ASamarkRoth/ScanningSystem/Report/Theory/Theory.tex

\documentclass[11pt,a4paper]{article}
\usepackage[utf8]{inputenc}
\usepackage[english]{babel}
\usepackage[T1]{fontenc}
\usepackage{amsmath}
\usepackage{amsfonts}
\usepackage{amssymb}
\usepackage{graphicx}
\usepackage{array}
\usepackage{multirow}
\usepackage[left=2cm,right=2cm,top=2cm,bottom=2cm]{geometry}
\author{Guillem Tocabens}
\title{First measurements}
\begin{document}
\section{Physical background}

\end{document}
