ASamarkRoth/ScanningSystem/figs_and_draws/3DPrinter.md

#Purchasing 3D printer#

_LTH contact_: <http://www.design.lth.se/english/the-department/research-laboratories/3dprintlab/facilities/>

* Olaf Diegel <olaf.diegel@mkon.lth.se>

_Nicholai_:
3D skrivaren som använder ett resin är från ett företag som heter /Formlabs/, och deras senaste modell heter /Form 2/.
*Form* *2 product page*: https://formlabs.com/3d-printers/form-2/?utm_content=landing
*Promo video*: https://www.youtube.com/watch?time_continue=1&v=Ak4kgiSvgN8
*Reviews*: https://www.youtube.com/watch?time_continue=1&v=Ak4kgiSvgN8
*Reviews*: https://www.youtube.com/watch?v=HkILCsAOMcQ

-----------------------

För extruder printers kan jag rekommendera att du kolla på företag såsom:
/- /*Makerbot* - (största på markaden, men dyra och inte alltid bäst) - https://www.makerbot.com/products/3d-printers/
- *Ultimaker* - (bra upplösning, skriver inte alltid lika snabbt) - https://ultimaker.com/en/products
- *Lulzbot* - https://www.lulzbot.com/store/printers
- *Raise3D* - https://www.raise3d.com/pages/products

Jag har inte personligen erfarenhet av dessa skrivarna, annat än Form 2 resin skrivaren, så kolla gärna upp reviews på youtube eller likanade på dom andra. Kanalen "Tested" kollar mycket på 3D skrivare tex. All priser är mellan 20 000-35 000 SEK.

---------------------

För metall 3D prining finns bla:
- *Markforged* - https://markforged.com/products/
- *PLM Group* - https://plmgroup.se/produkter/3d-printers/production-3d-printers/direct-metal/

Räkna med att de kostar rätt bra mycket mer =)

##Interesting##

* Metal: <https://plmgroup.se/produkter/3d-printers/production-3d-printers/direct-metal/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>

##Compilation##
There are mainly two types of plastic 3D-printers denoted; resin (SLA) and extruder (FDM). <http://apm-designs.com/fdm-vs-sla-3d-printer-tech-comparison> makes a good introduction and comparison. 

From a chat with Nicholai and some internet search we have gathered two main candidates: 

* [Ultimaker 3](https://ultimaker.com/en/products/ultimaker-3). This is of extruder type. 
* [Form 2](https://formlabs.com/3d-printers/form-2/?utm_content=landing). This is a resin type.

_Accuracy_: Both have accuracy ~0.1 mm (Form 2 perhaps a little better). Form 2 is better on making difficult shapes.
_Dimensions_: 

* Form 2: 145 × 145 × 175 mm 
* Ultimaker 3: 215 x 215 x 200 mm

_Materials_: Both offer many different materials. 

* Form 2: <https://formlabs.com/materials/>
* Ultimaker 3: <https://ultimaker.com/en/products/materials>

Perhaps the ultimaker material is better suitable? 

For the Form 2 one can buy the liquid plastic ~1500-2000 kr per litre. While the plastic for the Ultimaker comes on rolls and are cheaper (~500 kr/750 g).

_Service/maintenance_: The Form 2 needs some more cleaning in between prints. The piece printed with the Form 2 might also need some extra treatment (removal of supporting structure) before it is ready. The companies offer fast service and spare parts.

Somebody needs to maintain the printer from time to time to keep it functional. How can this be arranged in the division?

_Software_: Never a problem.

_Installation_: The printer is not loud but it makes some noise. The microbeam hall is probably the best choice of location. How do we initiate these discussions?

What is perhaps most unclear is how we should organise the installation and maintenance of the printer in the division? Pavel told me that Kevin showed an interest to take part in the payment. 

Note that the information above are my (and Pavels) interpretations.
