ASamarkRoth/ScanningSystem/figs_and_draws/AbsorberDist-V1.0.pdf

Material: Aluminum, stainless steel, ...

10:1

Distance pieces for Absorber V1.0 20x H=2.0 mm
20x H=1.5 mm
20x H=1.0 mm

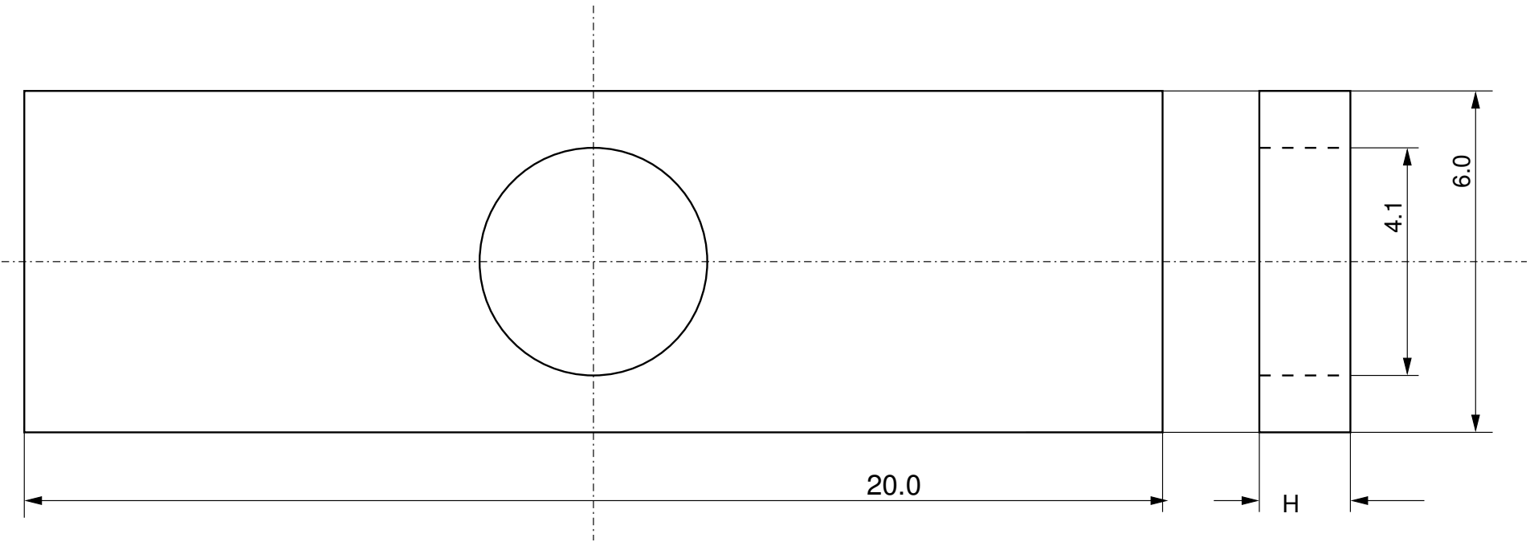
[picture p4: figure]
