ASamarkRoth/ScanningSystem/figs_and_draws/SourceHolder-V1.0.pdf

1:1

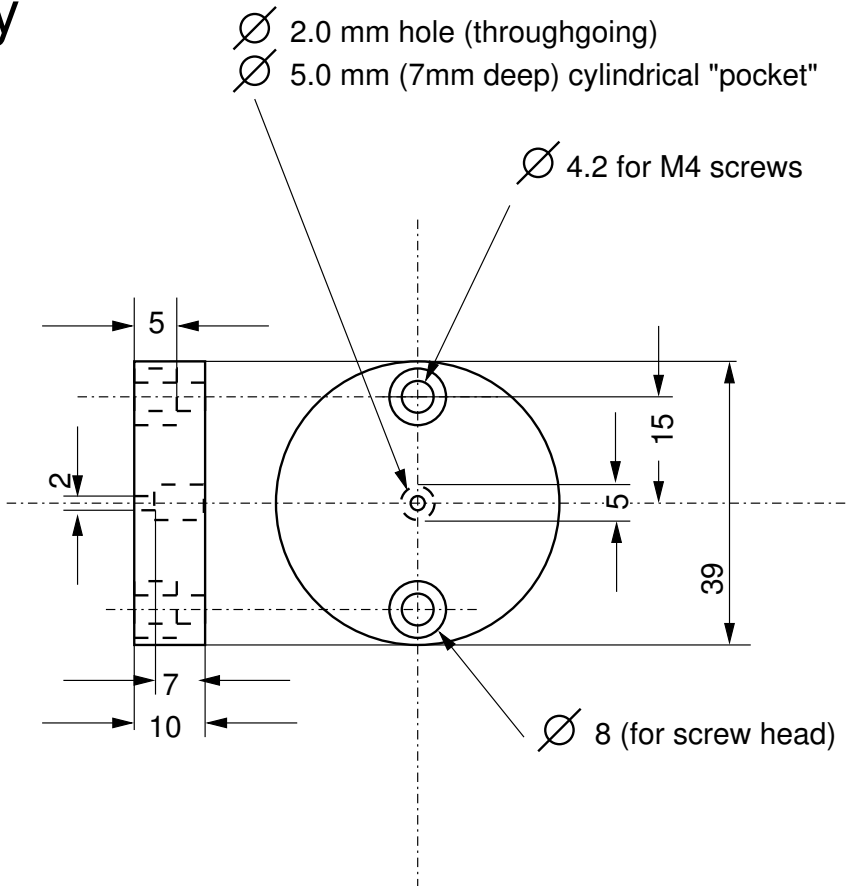
[picture p5: figure]
4.2 for M4 screws; 8 (for screw head); 2.0 mm hole (throughgoing) 5.0 mm (7mm deep) cylindrical "pocket"

# Material: Tungsten alloy

1x

# Source Holder for Collimator V1.0
