ASamarkRoth/ScanningSystem/figs_and_draws/Positioning system/HIWIN Servomotorer.pdf

# Servomotorer

### Sätt dina tankar i rörelse

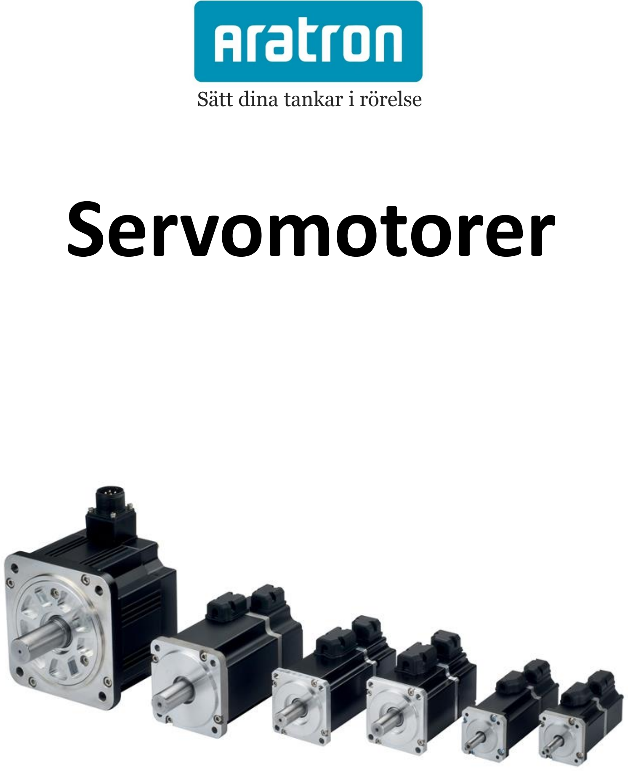
[picture p6: page 1]

# Servomotorer

## HIWIN AC servomotorer från 50W > 2kW

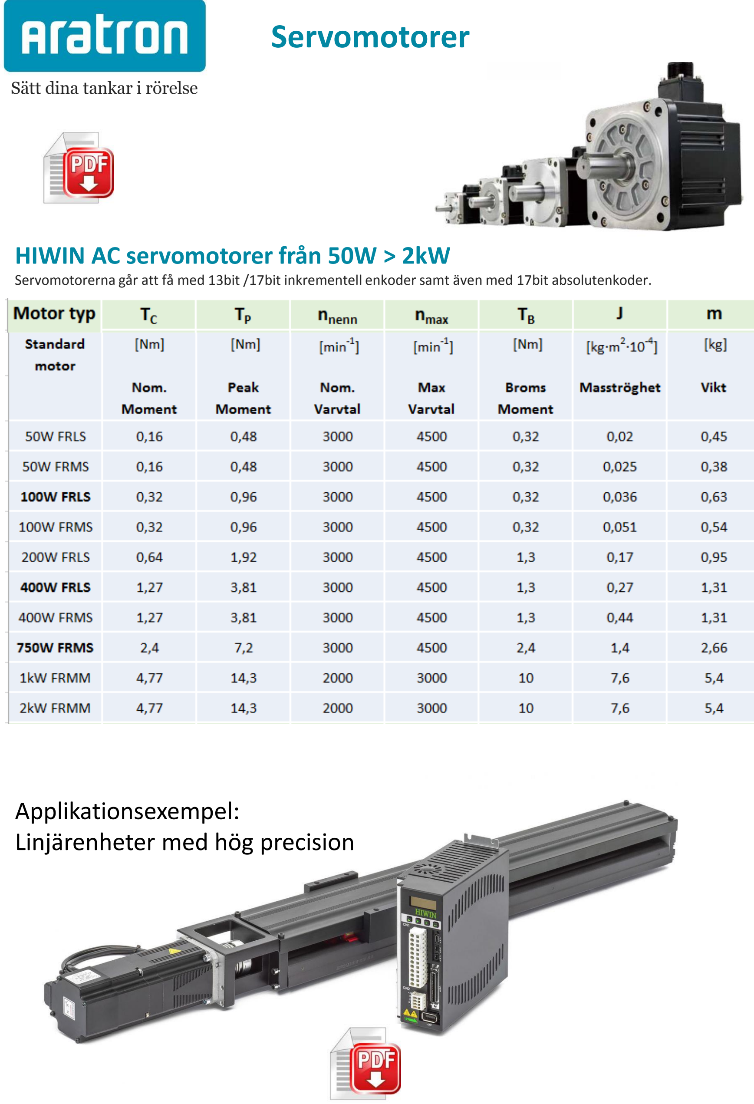
[picture p7: page 2]

Servomotorerna går att få med 13bit /17bit inkrementell enkoder samt även med 17bit absolutenkoder.

Sätt dina tankar i rörelse

## Applikationsexempel: Linjärenheter med hög precision

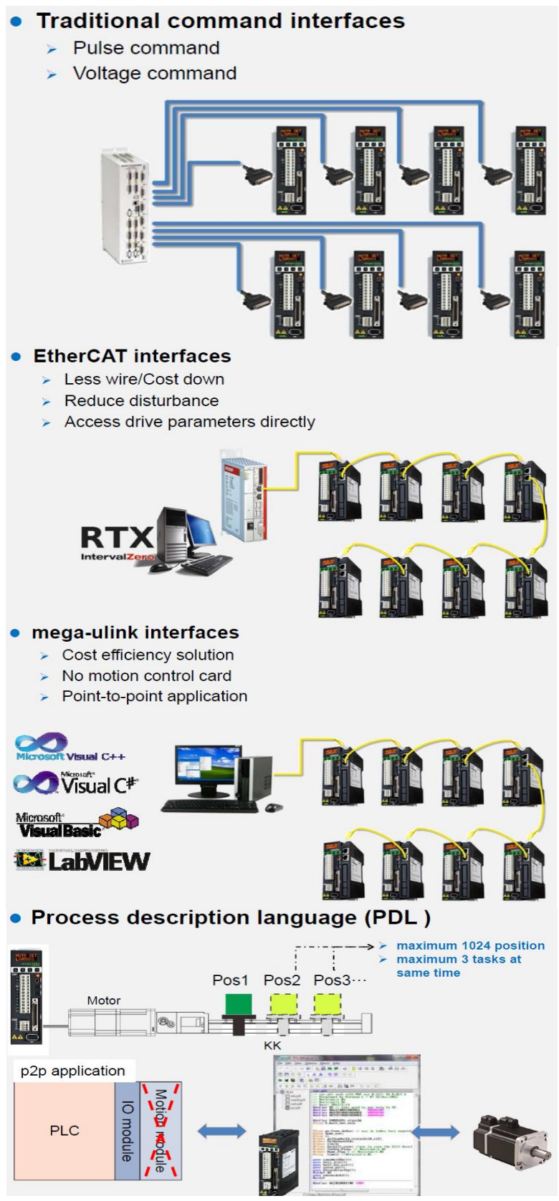
[picture p8: figure]
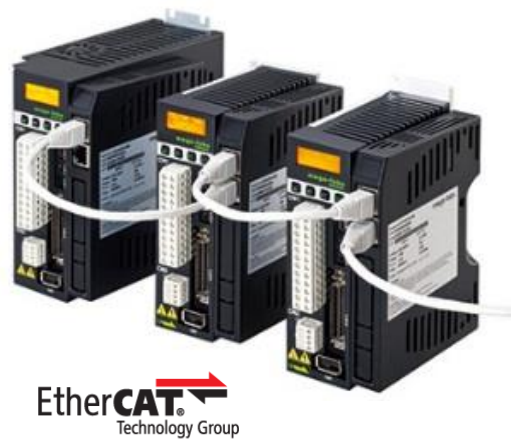
[picture p9: figure]

## Exempel på några egenskaper & funktioner

## HIWIN D2 Servodrivers

Intelligent programmerbar Standard Driver har en stor flexibiliteten. D2 har färdiga program för referenskörningar samt en gratis mjukvara ”lightening” som förenklar parameterinställning. D2 är lämplig för positionering, hastighetskontroll samt enklare I/O kontroll. Optioner: Modbus (RTU och ASCII) för seriell kommunikation mot bl.a. HMI display för att visa värden. EtherCAT interface (CoE) för avancerad CNC kontroll eller (megaulink) som erbjuder bra gränssnitt med API som passar mot andra mjukvaror och programspråk. Med en PDL koder kan HIWIN servodriver enkelt programmeras och styra positioner och hastigheter mm. D2 Driver fungerar såväl ”Standalone” som en enkel PLC eller som slav till en extern PLC eller PC styrsystem beroende på vad som passar bäst.

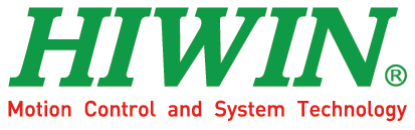
[picture p10: figure]

# Servodriver

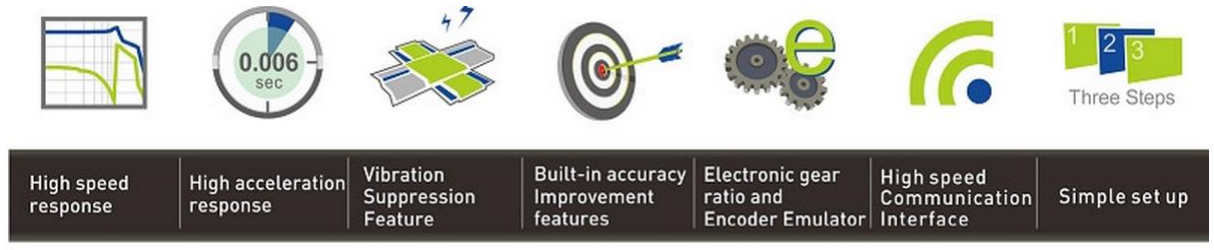
[picture p11: figure]

## Servomotorer & Direktdrivna momentmotorer

### Sätt dina tankar i rörelse

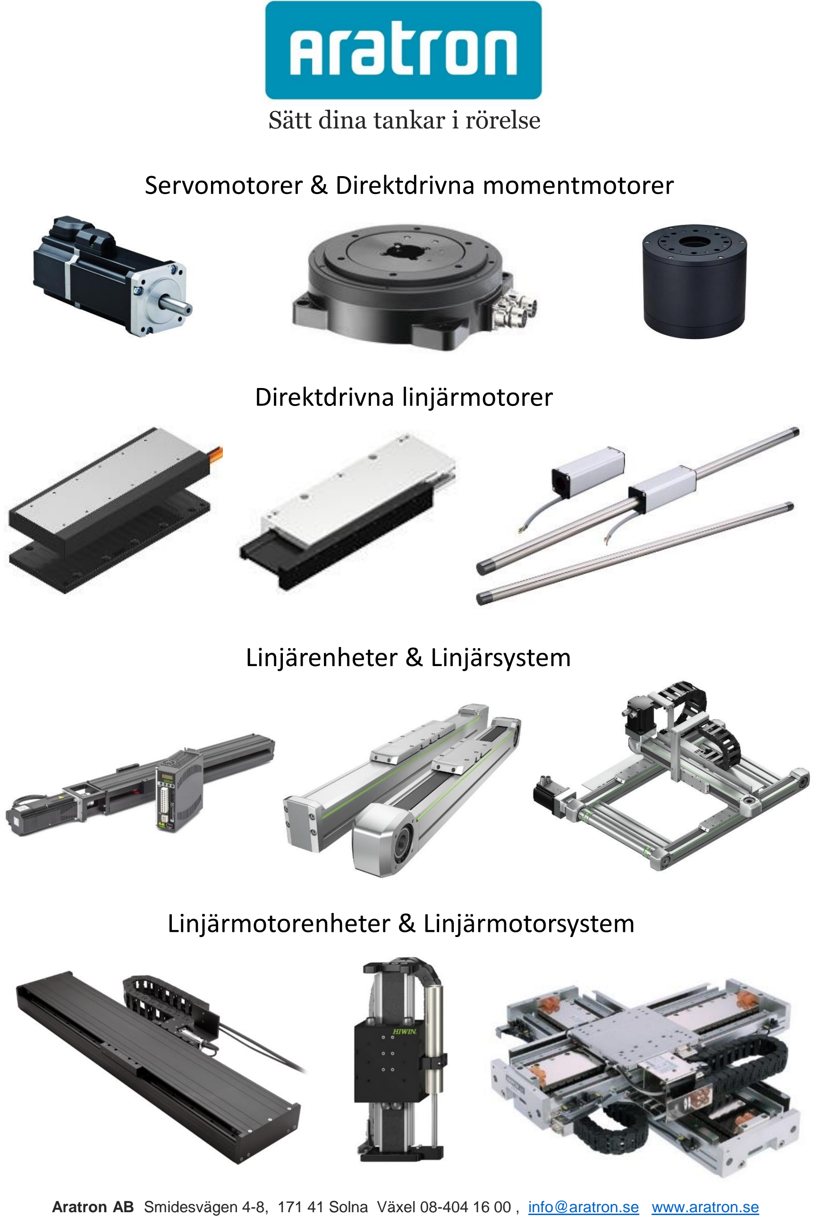
[picture p12: page 4]

Aratron AB Smidesvägen 4-8, 171 41 Solna Växel 08-404 16 00 , info@aratron.se www.aratron.se

## Direktdrivna linjärmotorer

## Linjärenheter & Linjärsystem

## Linjärmotorenheter & Linjärmotorsystem
