ASamarkRoth/ScanningSystem/figs_and_draws/Positioning system/Kort information om HIWIN Servodrifter med nåra prisexempel.pdf

Sätt dina tankar i rörelse

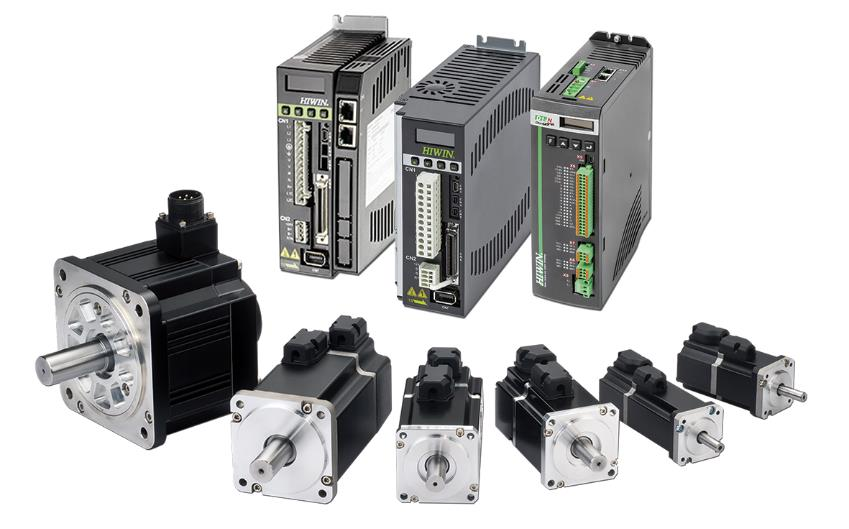
[picture p13: figure]

Aratron AB Smidesvägen 4-8, 171 41 Solna Växel 08-404 16 00 , info@aratron.se www.aratron.se

# HIWIN´s stora framgång beror på förmågan att alltid leverera högsta kvalitet till de mest konkurrenskraftiga priserna

# AC Servomotorer & Servodrives

## HIWIN erbjuder ett stort produktutbud för linjära rörelser & transmissioner

Med nyckelkomponenter såsom kulskruvar, linjära skenstyrningar, kryssrullager, linjärmotorer, momentmotorer, linjära mätskalor, AC servo och stegmotorer och elektriska gripdon mm. För några av dessa nyckelkomponenter t.ex. kulskruvar och linjära skenstyrningar rankas HIWIN som en av de största tillverkarna i världen. Genom kombinationer av dessa komponenter kan våra försäljningsingenjörer ge ert företag den bästa linjära systemlösningen.

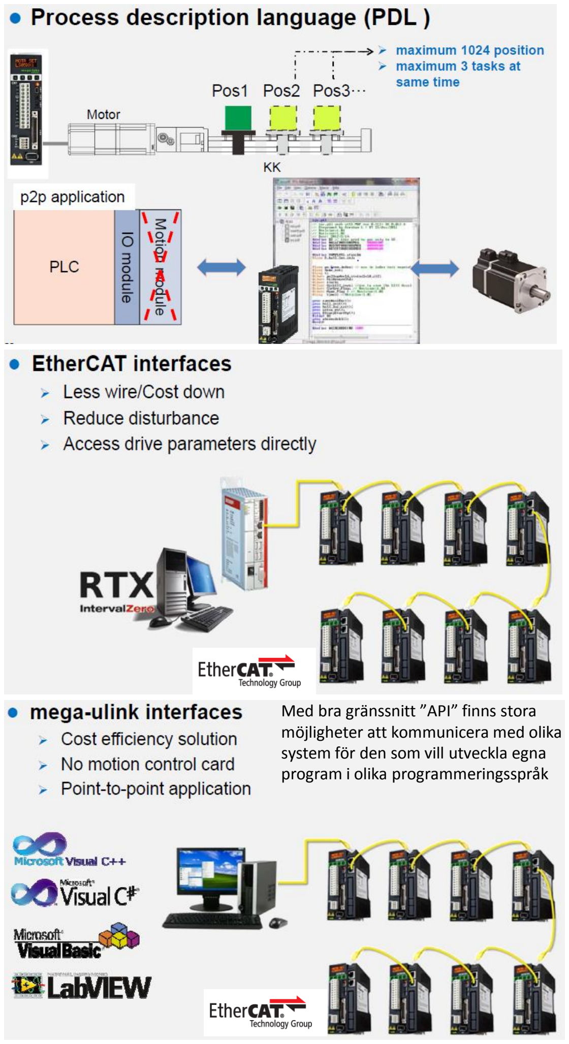
[picture p14: figure]
Med bra gränssnitt ”API” finns stora möjligheter att kommunicera med olika system för den som vill utveckla egna program i olika programmeringsspråk

### D2 Servodrivers erbjuder många möjligheter

Intelligent programmerbar Standard Driver med HIWIN´s PDL kod ökar flexibiliteten. D2 har färdiga program för referenskörningar samt en gratis mjukvara ”lightening” som förenklar parameterinställning. D2 är lämplig för positionering, hastighetskontroll samt enklare I/O kontroll. Optioner: Modbus (RTU och ASCII) för seriell kommunikation mot bl.a. HMI display för att visa värden. EtherCAT interface (CoE) för avancerad CNC kontroll eller (mega-ulink) som erbjuder bra gränssnitt med API som passar mot andra mjukvaror och programspråk.

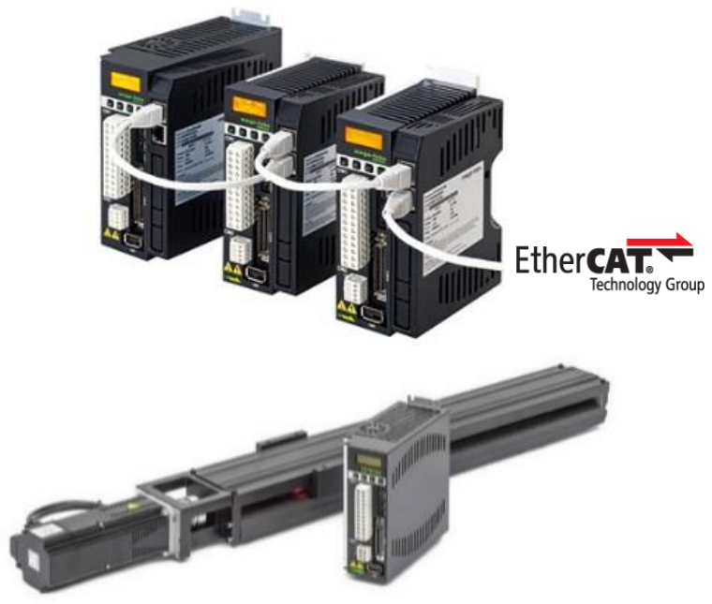
[picture p15: figure]
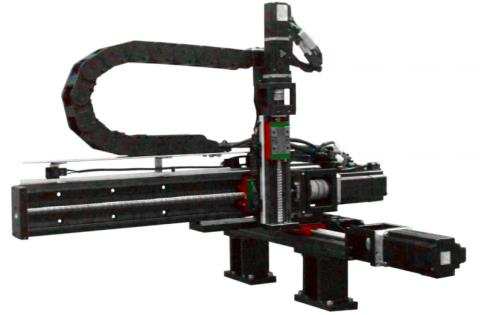
[picture p16: figure]
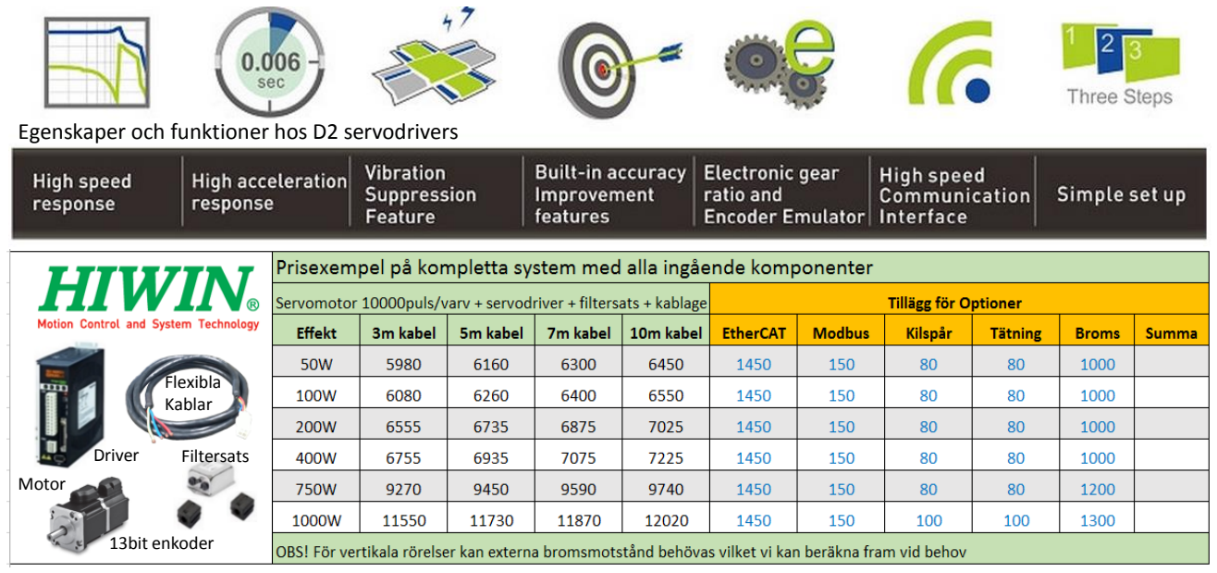
[picture p17: figure]
13bit enkoder; Driver; Flexibla Kablar; Filtersats; Motor

Aratron AB Smidesvägen 4-8, 171 41 Solna Växel 08-404 16 00 , info@aratron.se www.aratron.se

Fråga oss gärna på systemlösningar med servomotordrifter och linjärenheter

## Kortfattad beskrivning

Egenskaper och funktioner hos D2 servodrivers
