ASamarkRoth/ScanningSystem/figs_and_draws/Ritningar LYCCA-mount scanner/AddPieces-V1.0.pdf

## Distance cylinder & preamp support

Material: Hard plastic / plexiglas | 1:1 | Material: Aluminum | 1:1

16

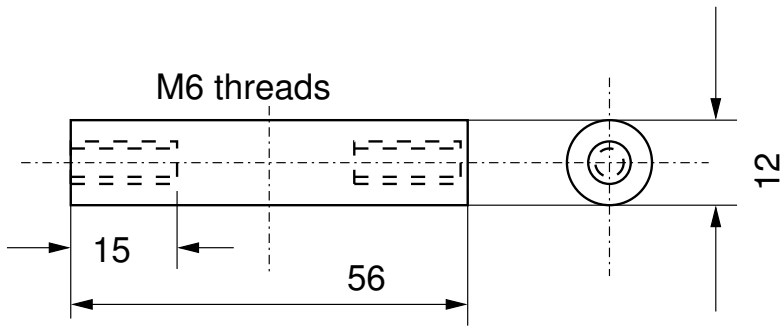
[picture p27: figure]
M6 threads

60

4 x | 12 x
