ASamarkRoth/ScanningSystem/figs_and_draws/BX 170308 SPECIAL BORD -ANTON ROTH.PDF

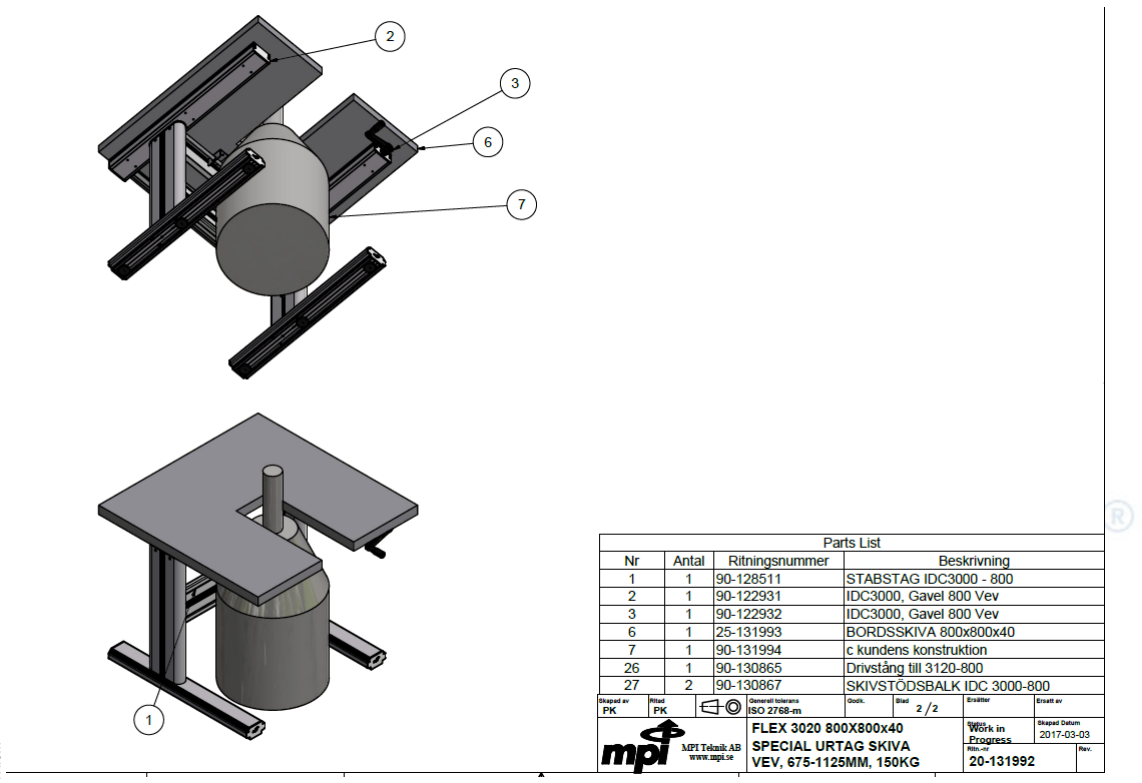
[picture p28: figure]

Kund: | Projektnamn | Datum: 2017-03-08
| | Er ref.: Anton Roth
| Offertnummer | Vår ref.: Besnik Xhemajli
BX 170308 SPECIAL BORD -ANTON ROTH

Gigant Arbetsplats AB/Configura - BX 170308 SPECIAL BORD -ANTON ROTH.om

OFFERT

2017-03-08 | Sida 1 (2)

Anton Roth

Offertnummer BX 170308 SPECIAL BORD -ANTON ROTH
Hej!
Här kommer en offert enligt dina ösnkemål.

Materialet i 40 skivan är trälamell/spån och det är inga problem att borra i den. Vad gäller broms så ska varje benpar klara 150 kg utan att det ska bli någon rörelse i bordet, men vid överlastning kan bordet börja sjunka. Borra hål och fästa i golv borde vara möjligt men ansvaret för det faller på kunden. Varje ben har 3st ställfötter som är inställbara i höjdled.

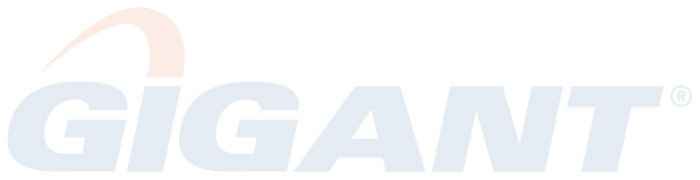
[picture p29: figure]

Välkommen att kontakta mig vid frågor!

Med vänlig hälsning

Gigant Arbetsplats AB
Innesälj

Besnik Xhemajli
Tel. direkt | 010-4546316
Mobil | 070-219 40 57
E-post | besnik.xhemajli@gigant.se
Gigant Arbetsplats AB | Telefon | Fax | Bankgiro | Postgiro | Vat reg nr | E-post
Sandbergsvägen 3 | 010-4546316 | | | | | besnik.xhemajli@gigant.se
| | | | Org nr | Internet

Sida 2 (2)

Offertspecifikation

Best.nr. | Benämning | Antal | a' pris | Totalpris
(20-131992 ) | SPECIAL BORD 100:311 | 1.00 13 019:93 | 13 019:93
Leveransvillkor | Enligt Gigants allmäna försäljnings-och leveransvillkor
Betalningsvillkor | Enligt Gigants allmäna försäljnings-och leveransvillkor
SUMMA TOTALT (exkl. moms) | SEK 13 020:-
Kund: | Projektnamn | Datum: 2017-03-08
| | Er ref.: Anton Roth
| Offertnummer | Vår ref.: Besnik Xhemajli
BX 170308 SPECIAL BORD -ANTON ROTH
