ASamarkRoth/ScanningSystem/figs_and_draws/SFi-Sor-Off17012410080.pdf

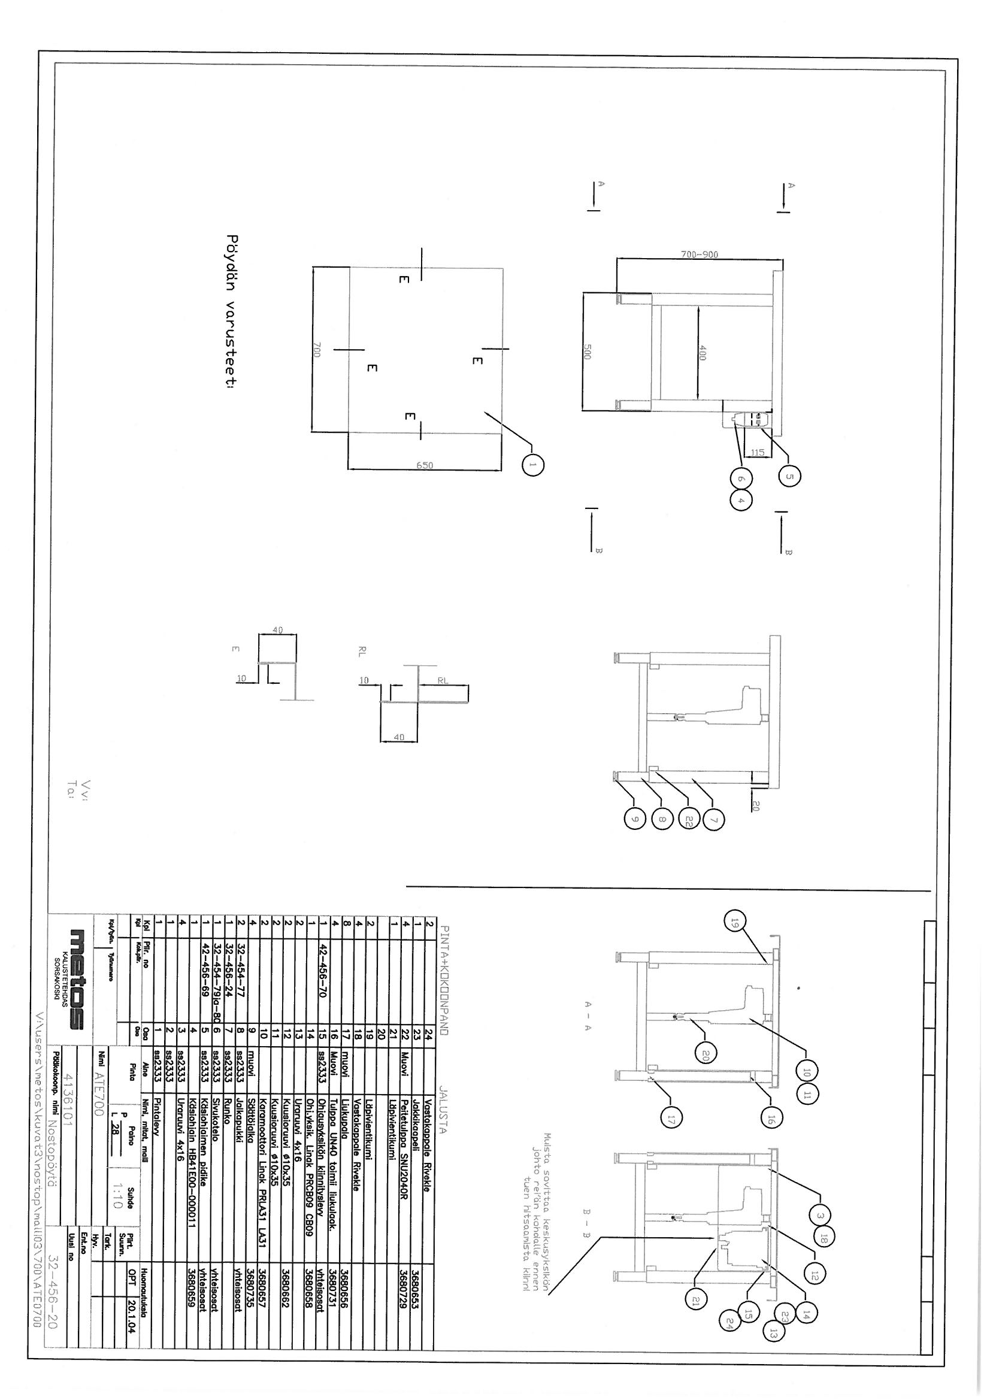
[picture p30: page 1]
