ASamarkRoth/ScanningSystem/figs_and_draws/Positioning system/principskissSKS.pdf

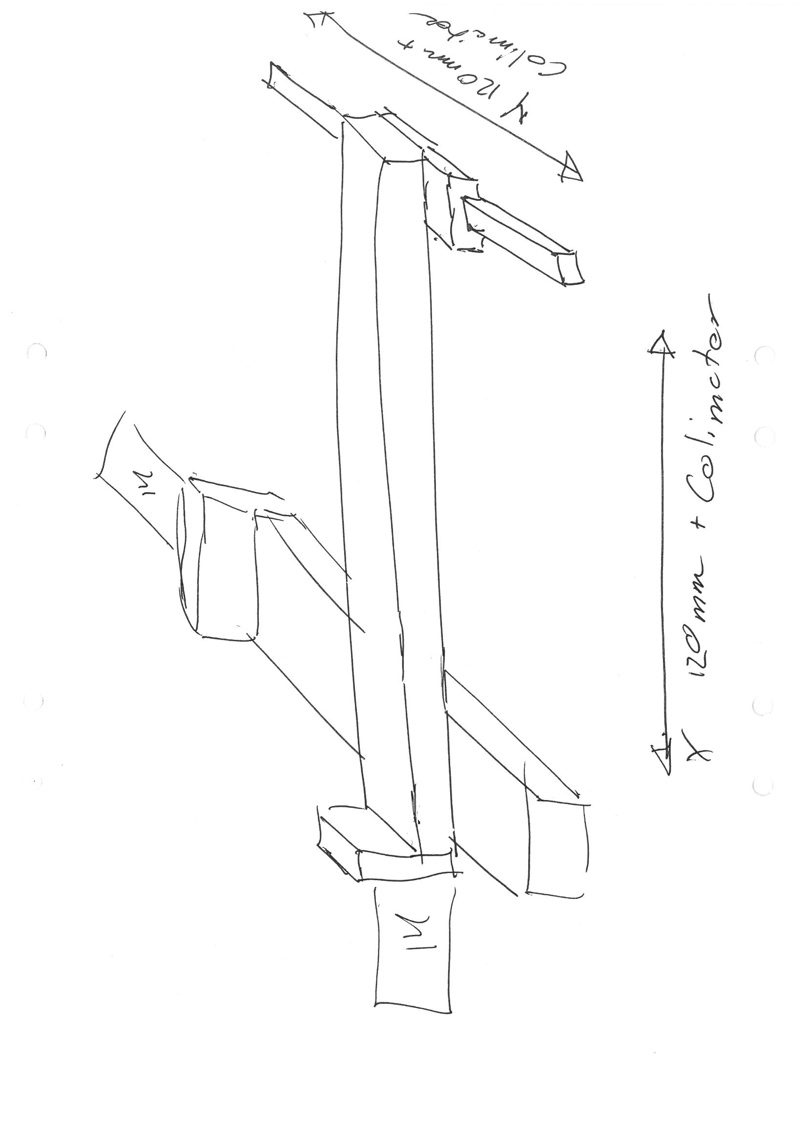
[picture p31: page 1]
