ASamarkRoth/ScanningSystem/figs_and_draws/Positioning system/SketchPS.png

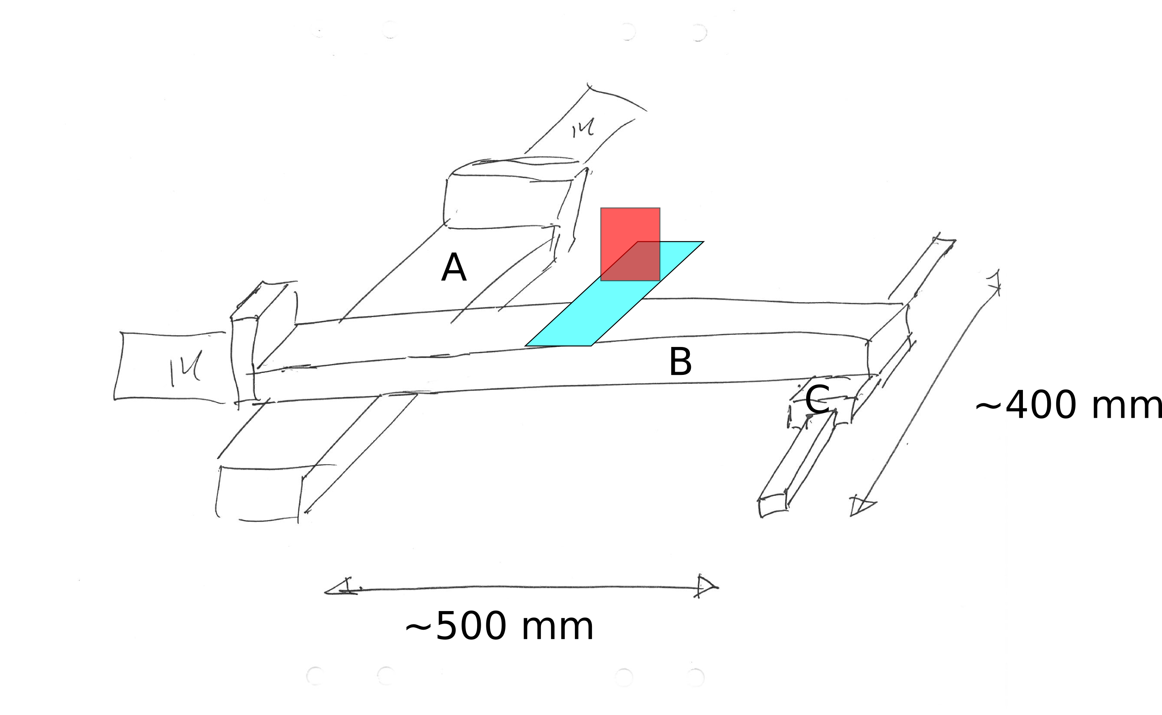
figs_and_draws/Positioning system/SketchPS.png
