ASamarkRoth/ScanningSystem/figs_and_draws/Positioning system/TopTableDrillingSputter.svg.png

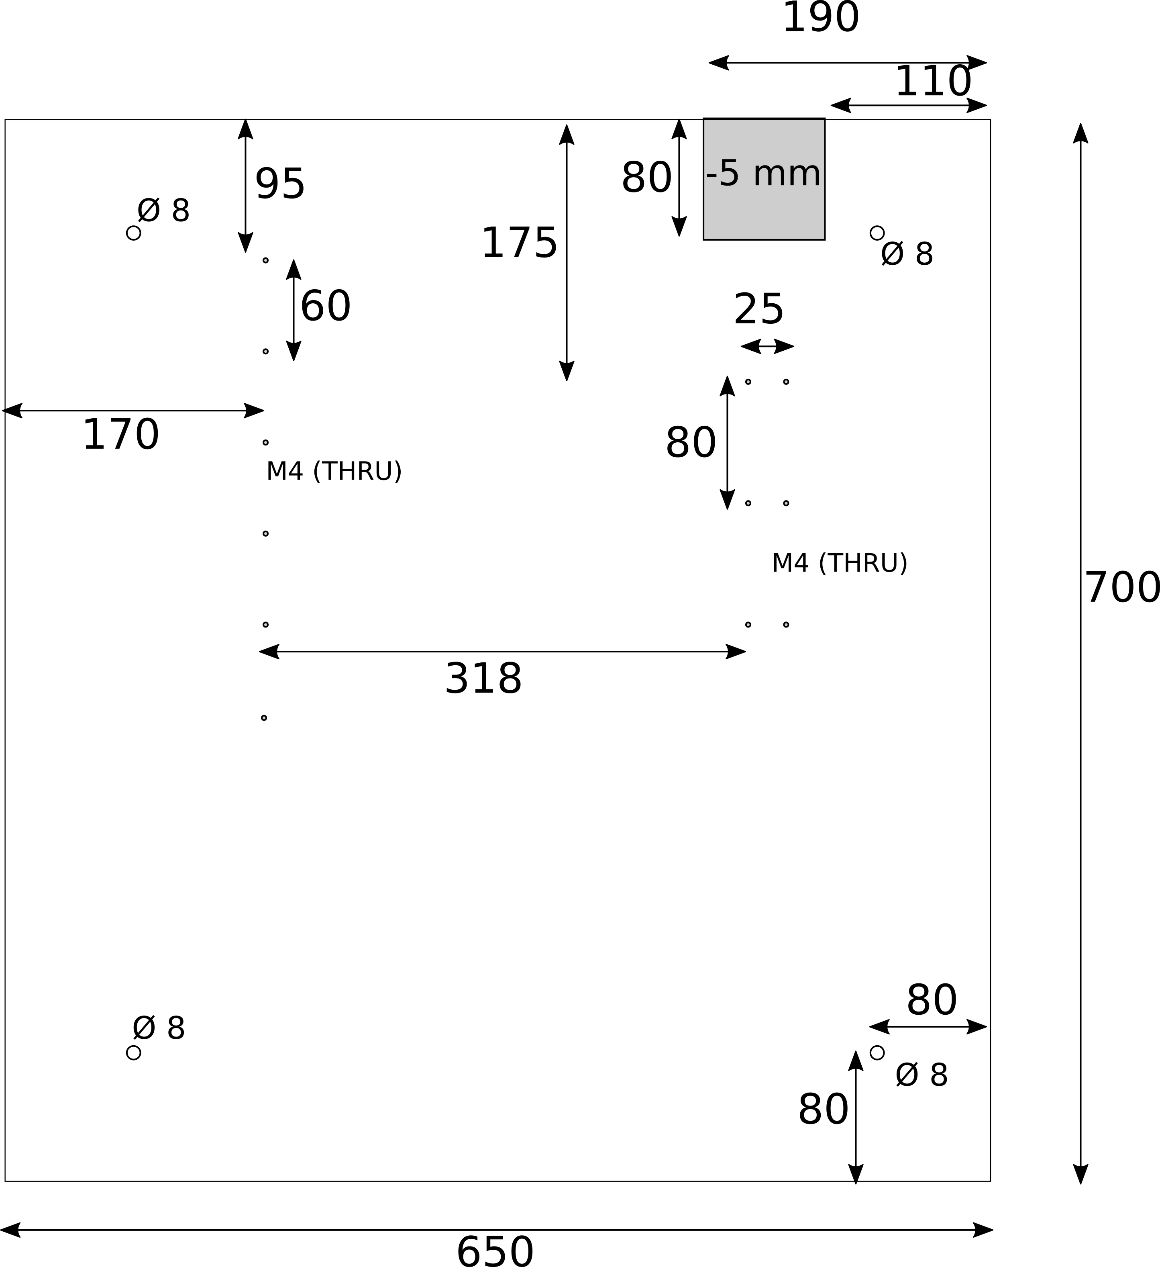
figs_and_draws/Positioning system/TopTableDrillingSputter.svg.png
