ASamarkRoth/ScanningSystem/figs_and_draws/ScanningSystem1.png

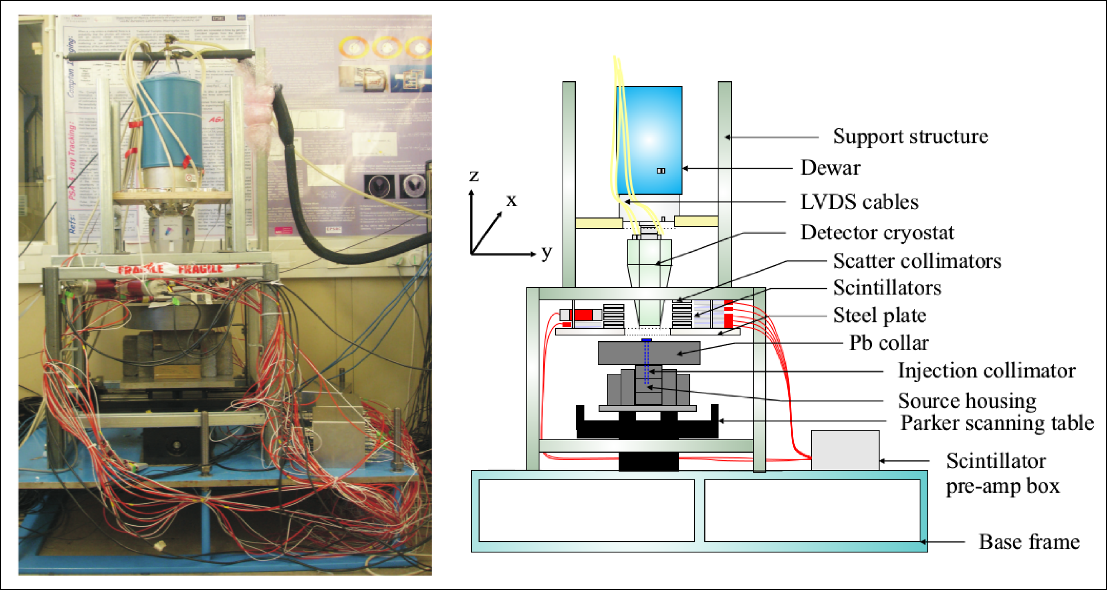
figs_and_draws/ScanningSystem1.png
