ASamarkRoth/ScanningSystem/figs_and_draws/ScanningSystem2.png

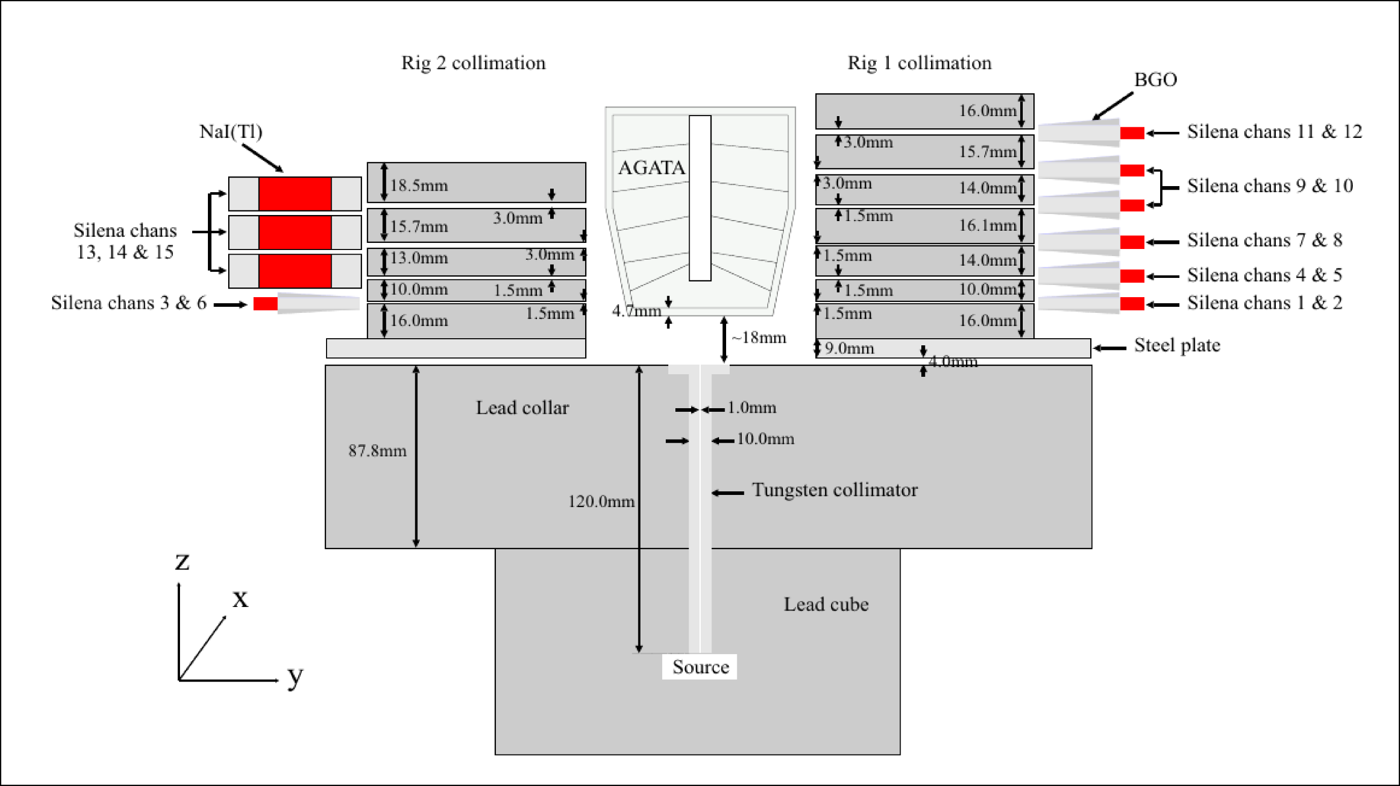
figs_and_draws/ScanningSystem2.png
