ASamarkRoth/ScanningSystem/orders/Order_Compotech_stepper_motors.odt

Offert positionssystem: Lunds Universitet, avdelning kärnfysik - Compotech

Organisationsnummer: 202100-3211

Faktureringsadress | Leveransadress
Lunds universitet Anton Roth Kärnfysik Box 188 221 00 Lund | Lunds universitet Fysiska inst Kärnfysik Sölvegatan 14 223 62 Lund

2st 17H261-02S/D (61mm lång, 1,2A per fas (motor drar då max ~1,8A totalt, ger ca 0,5Nm vid låga varvtal)): 190kr/st exkl. moms
