ASamarkRoth/ScanningSystem/orders/Distrelec_Order_No_Compex_Anton-1.PDF

Postal address: Elfa Distrelec AB, 175 80 Järfälla Visiting address: Elektronikhöjden 14 Tel: 020-75 80 00 Fax: 020-75 80 10
Internet: www.elfa.se E-mail: order@elfa.se Bank/Swift address: Swedbank AB (publ) SWEDSESS IBAN No.: SE54 8000 0890 1190 3267 3163 Bank giro: 565-2060 Organization no.: 556751-1414 VAT no.: SE556751141401 Seat of board of directors: Järfälla

Godsadress
Fysiska Instutitionen/Kärnfysik Sölvegatan 14
223 62 LUND
Sweden
Följesedel | 1 ( 1)
Leveransnummer | 83791681
Leveransdatum | 01.11.2017
Kundnummer | 2090226
Kundnamn | Fysiska Instutitionen/Kärnfysik
Kundens referens | Compex_Anton
Vårt kundordernummer 1001954839
Datum | 01.11.2017
Kontaktperson | Pavel Golubev
Vårt kontonummer | 2090225

Villkor
Leveransvillkor Normal to door / LUND Antal positioner 1

Vikt (brutto/netto) volym
Bruttovikt 172 G | Nettovikt 172 G | Volym 1.44 CDM
Pos | Artikelnr | Benämning | Beställt antal | Levererat antal Kvar att
leverera

Bruttovikt

000010 | 300-09-110 | Läsgaffel 3.18mm 5V 30mA | 8 | ST | 8 | 0 | 56 G
| Tillverkare | Optek | / Typ nr. OPB990T51Z
Customer Material No.:Anton Såmark-Roth
StatVarunr/ImpKodnr 8541409090
Country of Origin: US , 8 ST
