ASamarkRoth/ScanningSystem/orders/Offert3DPrima.pdf

Prima Printer Nordic AB
Kantyxegatan 25 F
213 76 MALMÖ / SWEDEN
Corp. id no.: 556957-2927

Phone: + 46 40 684 97 90
E-mail: info@3dprima.com
Webpage: www.3dprima.com

IBAN: SE9080000821492376772238 SWIFT/BIC: SWEDSESS
BankGiro: 377-8214

1

Lunds Universitet Kärnfysik Anton Såmark-Roth
Sweden

## Offert Nr: 2

Order Nr: | 17666
Kund Nr: | 12397
Er referens:

Momsreg nr: SE556957292701

Datum: | 30 Aug 2017
Pos | ID | Artikelnamn | Antal | Pris exkl. moms | Summa exkl. moms
1 | 22142 | Ultimaker 3 Extended | 1.00 | 36,900.00 | 36,900.00
2 | 21862 | PrimaSelect PLA - 2.85mm - 750 g - Natural EAN: 7340002100319 Discount 50% = 598.00 SEK gross (478.40 SEK net) Model: PS-PLA-285-0750-NA | 4.00 | 119.60 | 478.40
3 | 21717 | PrimaSelect ABS+ - 2.85mm - 750 g - Svart EAN: 7340002100951 Discount 50% = 798.00 SEK gross (638.40 SEK net) Model: PS-ABSP-285-0750-BK | 4.00 | 159.60 | 638.40
4 | 22442 | PrimaSelect PLA PRO - 2.85mm - 750 g - Svart EAN: 7340002102696 Discount 50% = 798.00 SEK gross (638.40 SEK net) Model: PS-PLAPRO-285-0750-BK | 4.00 | 159.60 | 638.40
5 | 22181 | PrintaFix Basic EAN: 9190001018164 Discount 10% = 99.90 SEK gross (79.92 SEK net) | 1.00 | 719.30 | 719.30
6 | 21569 | BuildTak Spatel EAN: 0099461339224 Discount 10% = 21.90 SEK gross (17.52 SEK net) Model: BT30185 | 1.00 | 157.70 | 157.70
Summa varor exkl. moms SEK | 39,532.20
Frakt SEK | 0.00
Summa totalt exkl. moms SEK | 39,532.20
25.00% Moms SEK | 9,883.04
Summa totalt inkl. moms SEK | 49,415.20
Avdragen Rabatt SEK | 2,315.80
Betalningssätt: | Faktura
Leveransadress: | Lunds Universitet Kärnfysik Anton Såmark-Roth - -
| Sweden

Vi hoppas att offerten ser bra ut och ser fram emot en beställning.

Powered by TCPDF (www.tcpdf.org)
