ASamarkRoth/ScanningSystem/orders/OrdererkännandeSensorPieces.pdf

52943

Ordernummer
234

Kundkod

2017-06-30

Orderdatum

Er referens
Peter Huismann | Anton Roth

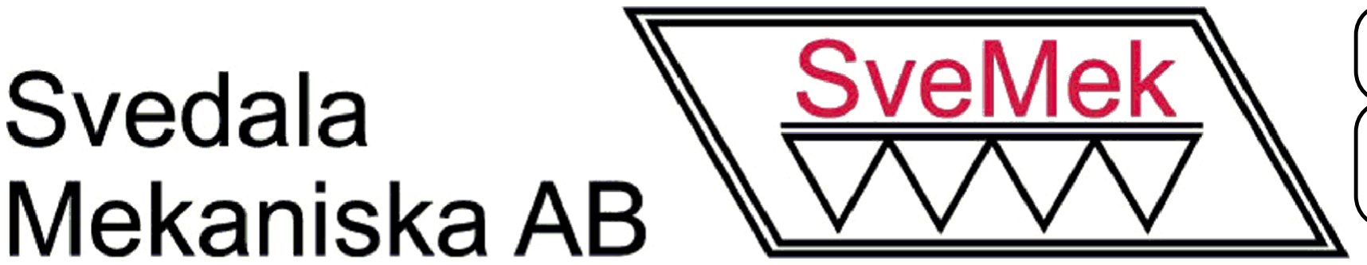
[picture p36: figure]

Ert momsreg.nr | Vår referens

Sida
1 / 1
Utskriftsdatum
2017-07-06

# Ordererkännande

### e-post 170630 AJ

Ert ordernr

Betalningsvillkor

Postadress

### 30 dagar netto

Leveransvillkor

Leveranssätt

Leveransadress

Godsmärkning Lev.period gäller för leverans från oss

### Efter förfallodatum debiteras dröjsmålsränta med

12,00%

### Telefax

### 223 62 Lund

### Lunds University Fysiska inst Kärnfysik Sölvegatan 14 221 00 LUND

### Lunds University Synchrotron Radiation Research Department of Physics Box 118

### Företagsbil

### Fritt Svedala, Ex Works

Pos Artikelnr | Benämning | Levper | Antal | à-pris | % | Belopp
1 SENSORCUTBLADELGSensorCutBladeLG | 2017-08-30 | 2,00 ST | 0,00 | 0,00
| Ritn.nr: SENSORCUTBLADELG
2 SENSORCUTBLADELUSensorCutBladeLU | 2017-08-30 | 2,00 ST | 0,00 | 0,00
| Ritn.nr: SENSORCUTBLADELU
3 SENSORHOLDER&SLI SensorHolder&Slit | 2017-08-30 | 4,00 ST | 0,00 | 0,00
| Ritn.nr: SENSORHOLDER&SLI
Summa Exkl. Moms ( SEK ) | 0,00

Vi har semesterstängt vecka 29,30,31.
Växel 040-404090
Direkt nummer
Anders Jönsson 040-40 40 91 Susanna Månsson 040-40 40 92 Peter Huisemann 040-40 40 93 Hans Eriksson 040-40 40 94

SWEDEN

Svedala Mekaniska AB
Företagsgatan 13
233 51 SVEDALA

info@svemek.com

Postadress | Besöksadress

Företagsgatan 13
233 51 SVEDALA

www.svemek.com

Org.nr | 556524-9942
VAT.nr | SE556524994201
Telefon | 040-404090

IBAN

Bankgiro

SWIFT

PlusGiro

Säte: Svedala

659-9757

SE8050000000052011006171

ESSESESS

F-skattsedel innehas | Skandinaviska Enskilda Banken AB

Telefax
