ASamarkRoth/ScanningSystem/orders/Order_gammadata_sources.pdf

## Offert

Offert nr | Utskriftsdatum | Kund nr | Sida
4001727 | 2017-03-20 | 10542 | 1
Leveransadress: | Fakturaadress:
Lunds Universitet | Lunds Universitet
Fysiska institutionen, avd. Kärnfysik | Fysiska Institutionen, Kärnfysik
Sölvegatan 14 | Box 118
223 62 LUND | 221 00 LUND
Vår ref. | Leveransvillkor

Offerten är giltig till

Betalningsvillkor
Stefan Isaksson | EXW Tillverkare | SEK | 30 dagar netto
Er ref. | Leveranstid | Valuta

Allmänna villkor
Anton Roth | 2-4 veckor | 2017-04-16 | ALOS05

Innehar F-skattebevis

Styrelsens säte:
Uppsala
Adress | Tel
| Fax E-post
| Internet

Organisationsnr
Gammadata Instrument AB | order@gammadata.se
| www.gammadata.se
Produktnr | Benämning | Antal | Pris ex moms | Belopp

556296-3503
Momsregistreringsnr
SE556296350301

Box 2034

018-56 68 00

750 02 UPPSALA | 018-56 68 88
CS137S10 | Sealed gamma/beta emitter. 370 kBq | 1 St | 1 690,00 | 1 690,00
CO57S100 | Sealed gamma emitter. 3.7 MBq | 1 St | 4 560,00 | 4 560,00
CO60S1 | Sealed gamma emitter. 37 kBq | 1 St | 850,00 | 850,00
EU152S1 | Sealed gamma emitter. 37 kBq | 1 St | 1 690,00 | 1 690,00
NA22S10 | Sealed gamma emitter. 370 kBq | 1 St | 1 690,00 | 1 690,00
| 1 inch diameter solid disk Nominal uncalibrated activity +/- 20%.
| Total fraktkostnad uppskattas till ca. 3000,-
