ASamarkRoth/ScanningSystem/orders/OrderGigant.pdf

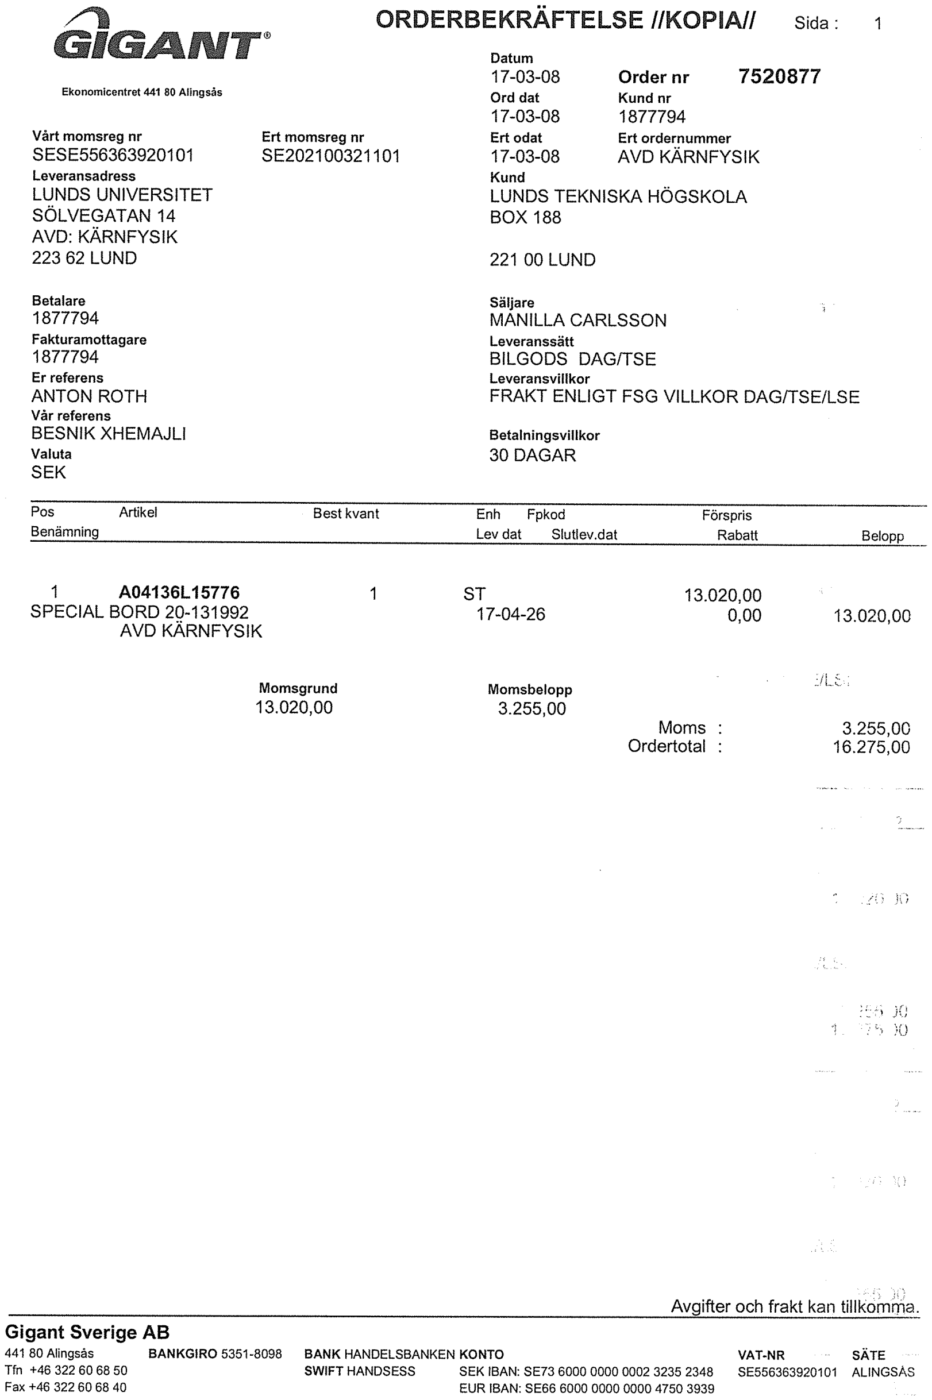
[picture p38: page 1]
