ASamarkRoth/ScanningSystem/orders/Order_TungstenPieces1.pdf

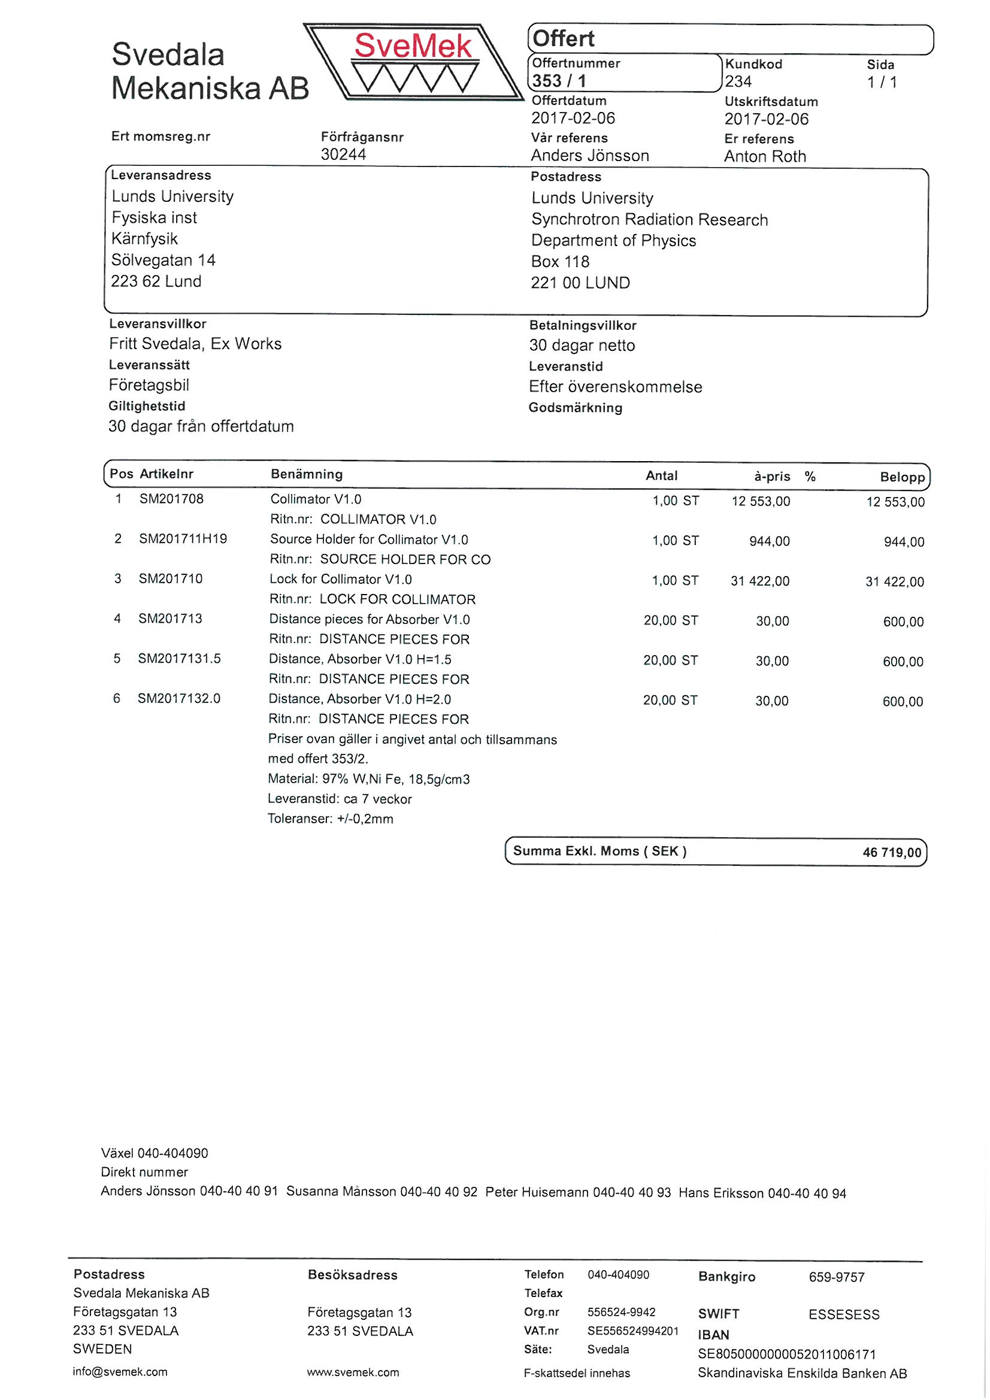
[picture p39: page 1]
