ASamarkRoth/ScanningSystem/orders/Order_TungstenPieces2.pdf

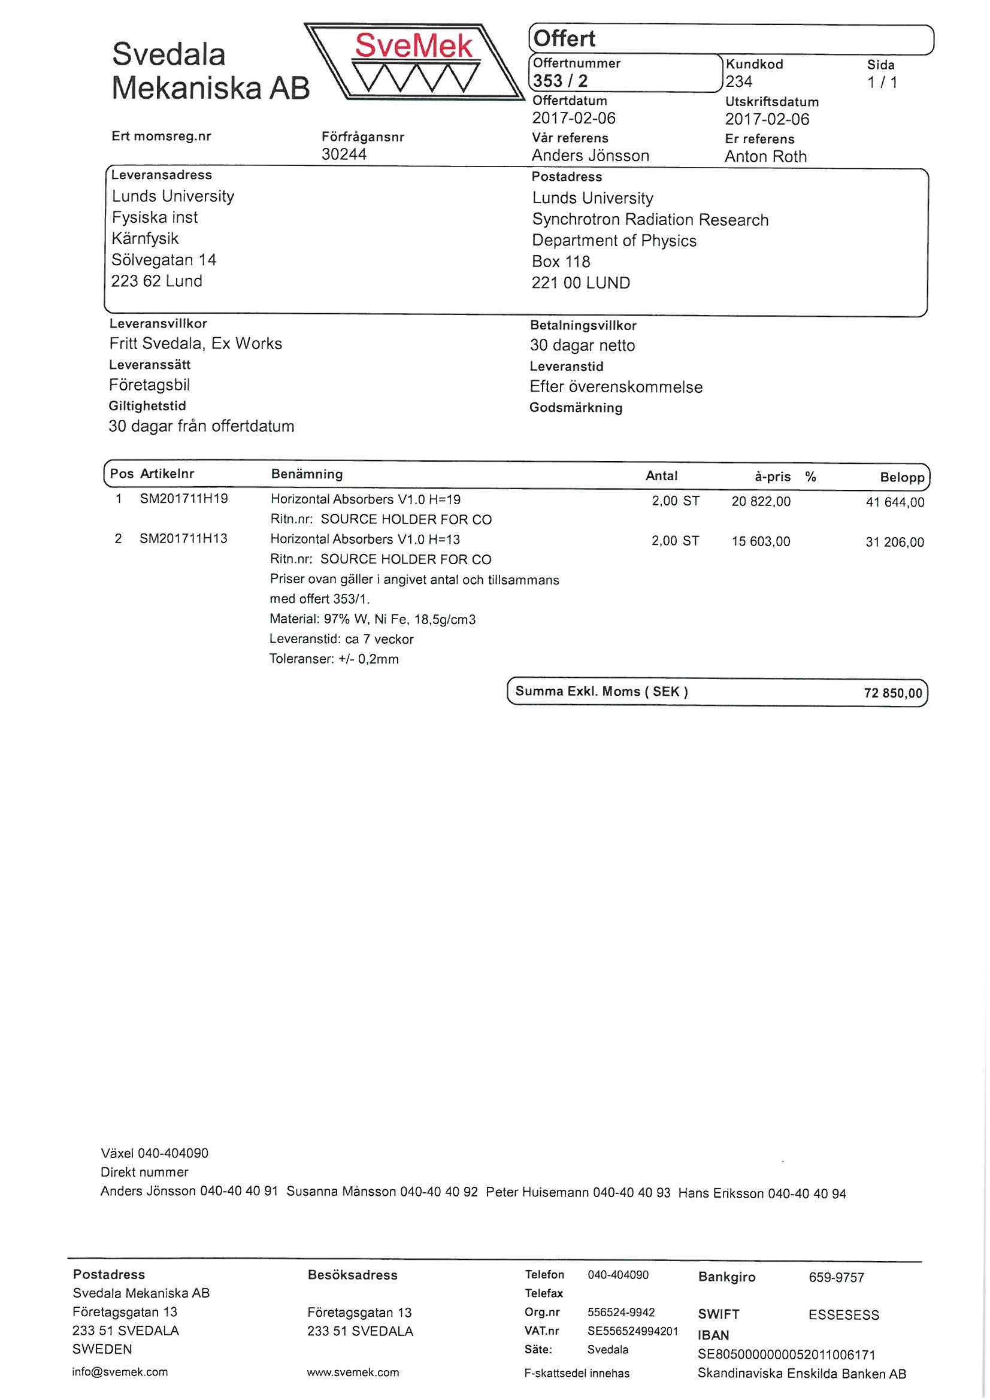
[picture p40: page 1]
