ASamarkRoth/ScanningSystem/orders/Ordererkännande_SveMekLYCCA.pdf

52384

Ordernummer
234

Kundkod

2017-01-25

Orderdatum

Er referens
Peter Huismann | Anton Roth


Ert momsreg.nr | Vår referens

Sida
1 / 1
Utskriftsdatum
2017-01-30

# Ordererkännande

### E-post 170125 AJ

Ert ordernr

Betalningsvillkor

Postadress

### 30 dagar netto

Leveransvillkor

Leveranssätt

Leveransadress

Godsmärkning Lev.period gäller för leverans från oss

### Efter förfallodatum debiteras dröjsmålsränta med

12,00%

### Telefax

### 223 62 Lund

### Lunds University Fysiska inst Kärnfysik Sölvegatan 14 221 00 LUND

### Lunds University Synchrotron Radiation Research Department of Physics Box 118

### Företagsbil

### Fritt Svedala, Ex Works

Pos Artikelnr | Benämning | Levper | Antal | à-pris | % | Belopp
1 SM201701 | Preamp support | 2017-02-17 | 4,00 ST | 0,00 | | 0,00
2 SM201704 | Distanse cylinder | 2017-02-17 | 12,00 ST | 0,00 | | 0,00
3 SM201702 | Absorber LYCCA-Holder Plastic-Top V | 2017-02-17 | 1,00 ST | 0,00 | | 0,00
4 SM201703 | Absorber LYCCA-Holder,bas V1.0 plex | 2017-02-17 | 1,00 ST | 0,00 | | 0,00
5 SM201705 | Absorber LYCCA-Holder,bas V1.0 alum | 2017-02-17 | 1,00 ST | 0,00 | | 0,00
6 000000 | Totalt pris | 2017-02-17 | 1,00 ST | 13 500,00 | | 13 500,00
Summa Exkl. Moms ( SEK ) | 13 500,00

Växel 040-404090
Direkt nummer
Anders Jönsson 040-40 40 91 Susanna Månsson 040-40 40 92 Peter Huisemann 040-40 40 93 Hans Eriksson 040-40 40 94

SWEDEN

Svedala Mekaniska AB
Företagsgatan 13
233 51 SVEDALA

info@svemek.com

Postadress | Besöksadress

Företagsgatan 13
233 51 SVEDALA

www.svemek.com

Org.nr | 556524-9942
VAT.nr | SE556524994201
Telefon | 040-404090

IBAN

Bankgiro

SWIFT

PlusGiro

Säte: Svedala

659-9757

SE8050000000052011006171

ESSESESS

F-skattsedel innehas | Skandinaviska Enskilda Banken AB

Telefax
