ASamarkRoth/ScanningSystem/SveMek files/TASISpec.obj

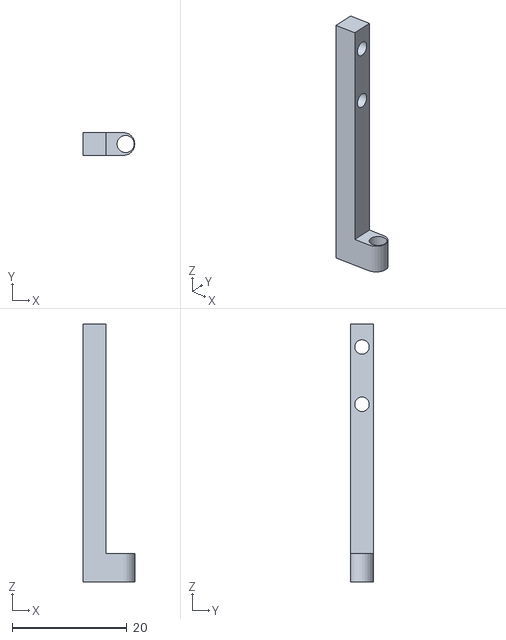
[picture p43: CAD file, 2017-11-17]
SveMek files/TASISpec.obj
9.00 x 4.00 x 45.0
