ASamarkRoth/ScanningSystem/TASISpec pieces/TASISpec piece1.step

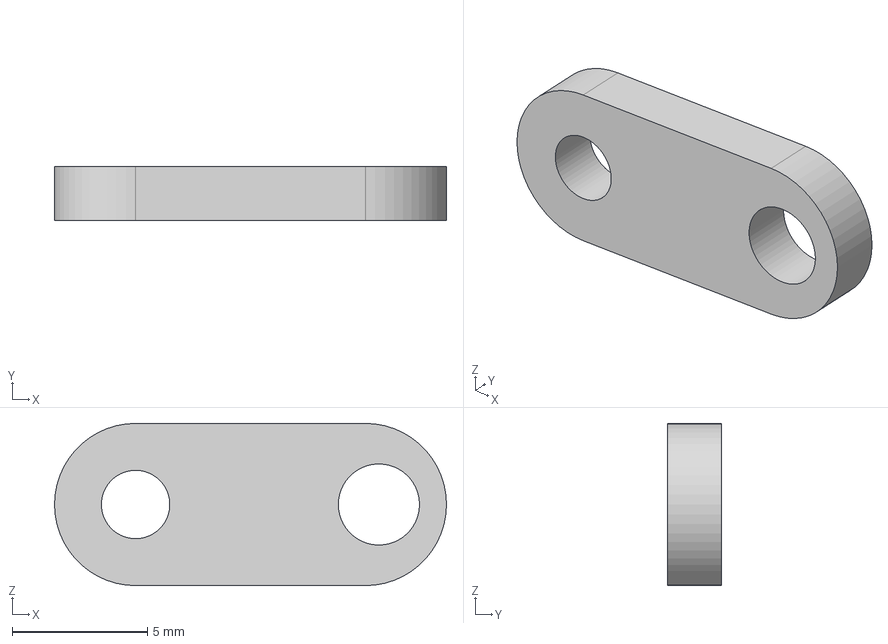
[picture p44: CAD file, 2017-06-07]
TASISpec pieces/TASISpec piece1.step
14.5 x 2.00 x 6.00 mm
