ASamarkRoth/ScanningSystem/Tungsten pieces/Lock.step

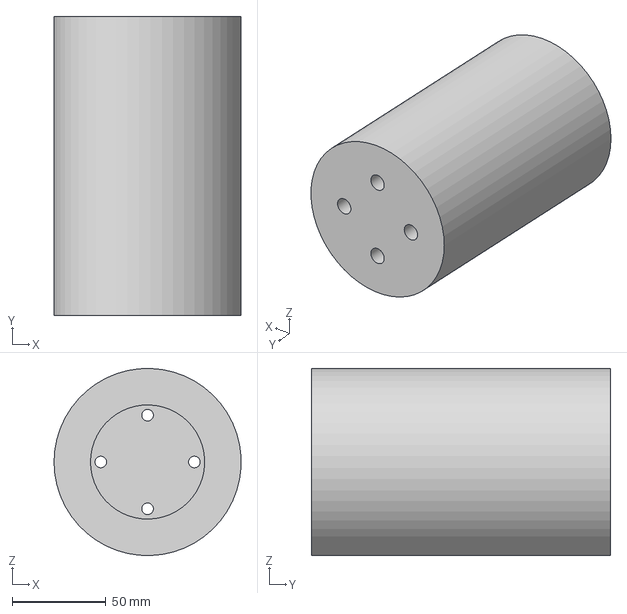
[picture p45: CAD file, 2017-02-06]
Tungsten pieces/Lock.step
99.9 x 160.0 x 100.0 mm
