ASamarkRoth/ScanningSystem/figs_and_draws/setup_3D/Top plate.step

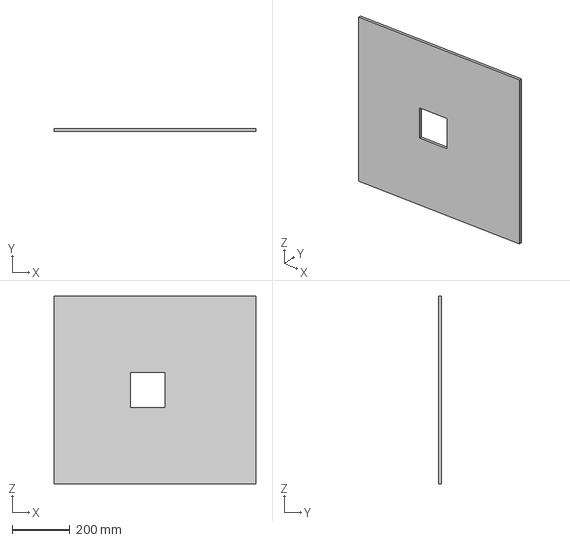
[picture p46: CAD file, 2017-03-27]
figs_and_draws/setup_3D/Top plate.step
700.0 x 10.0 x 650.0 mm
