ASamarkRoth/ScanningSystem/SveMek files/SensorHolder&Slit.obj

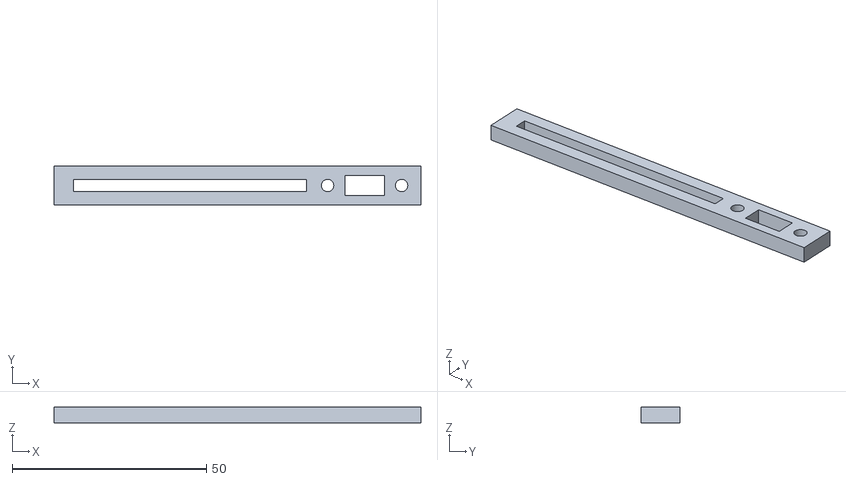
[picture p47: CAD file, 2017-11-17]
SveMek files/SensorHolder&Slit.obj
94.5 x 10.0 x 4.00
