ASamarkRoth/ScanningSystem/TASISpec pieces/TASISpec piece2.step

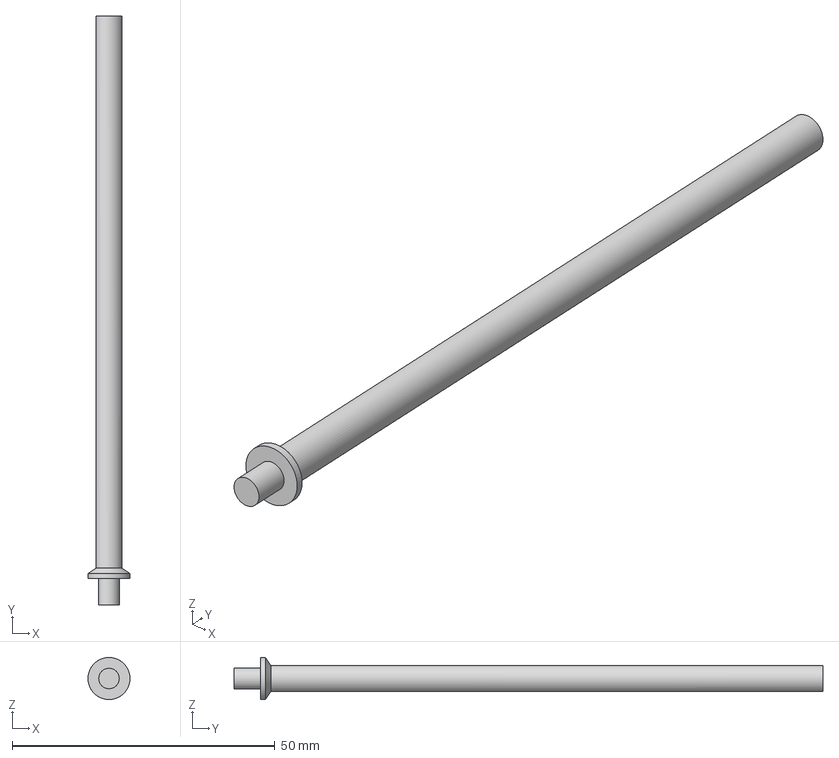
[picture p48: CAD file, 2017-06-07]
TASISpec pieces/TASISpec piece2.step
8.00 x 112.0 x 8.00 mm
