ASamarkRoth/ScanningSystem/Tungsten pieces/Collimator.step

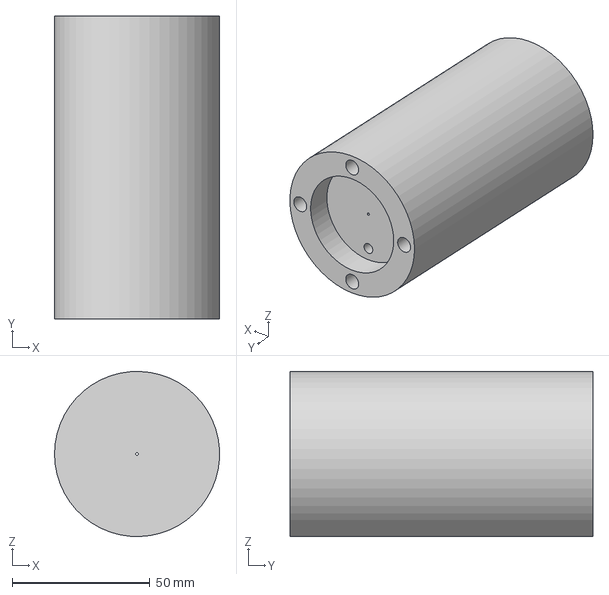
[picture p49: CAD file, 2017-02-06]
Tungsten pieces/Collimator.step
59.9 x 110.0 x 60.0 mm
