ASamarkRoth/ScanningSystem/figs_and_draws/setup_3D/Setup.step

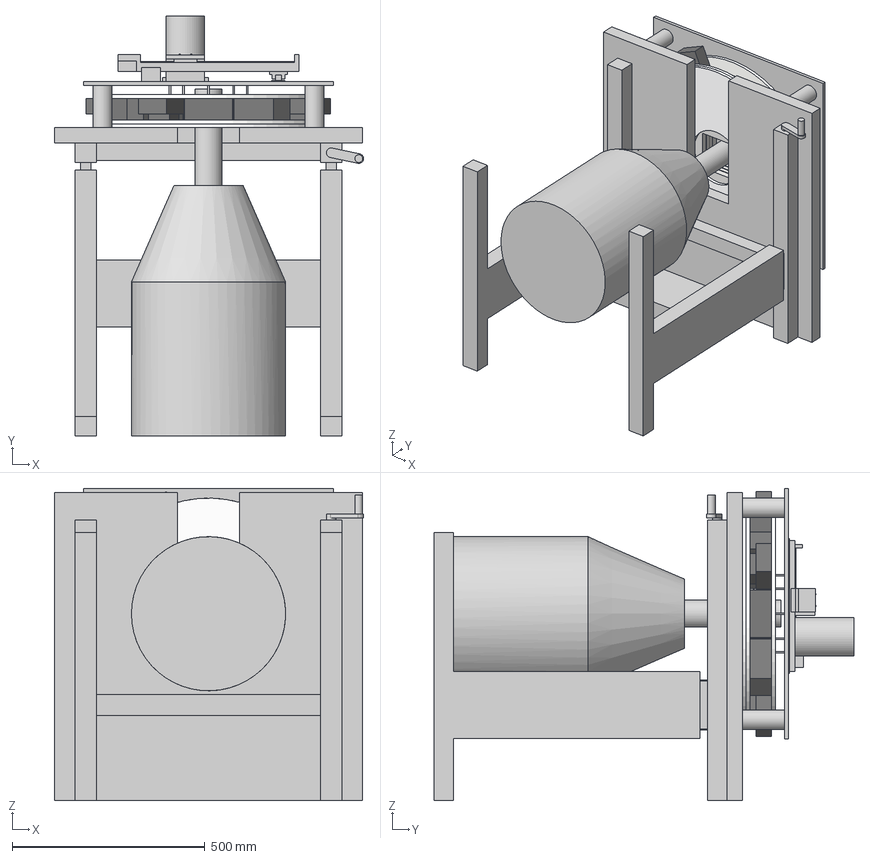
[picture p50: CAD file, 2017-03-07]
figs_and_draws/setup_3D/Setup.step
802.5 x 1090.0 x 809.8 mm
Dewar + crystal
Table
Lycca complex
Horizontal holders
Top table
Wagon 1
KK5002
KK6005
Wagon 2
Linear guide
Wagon 3
Level for LG
Arm
