ASamarkRoth/ScanningSystem/TASISpec pieces/TASISpec piece3.step

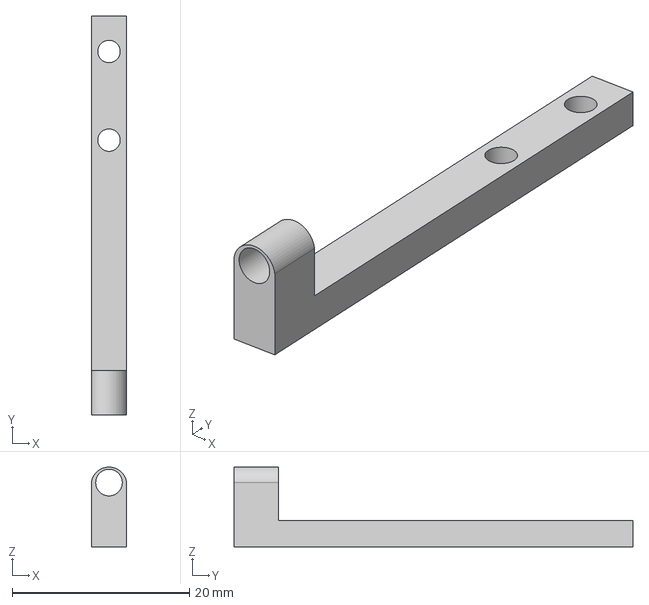
[picture p51: CAD file, 2017-06-07]
TASISpec pieces/TASISpec piece3.step
4.00 x 45.0 x 9.00 mm
