ASamarkRoth/ScanningSystem/Tungsten pieces/Horizontal absorber.step

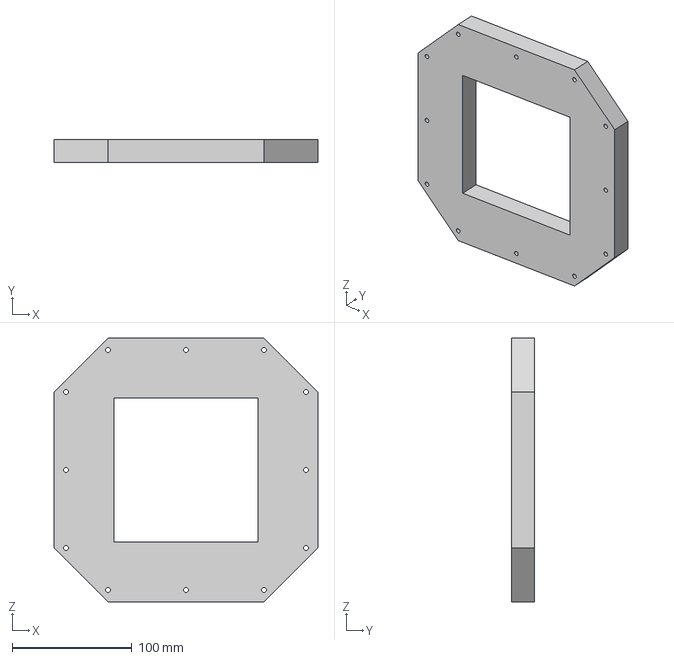
[picture p52: CAD file, 2017-02-06]
Tungsten pieces/Horizontal absorber.step
220.0 x 19.0 x 220.0 mm
