ASamarkRoth/ScanningSystem/figs_and_draws/setup_3D/Table v1.step

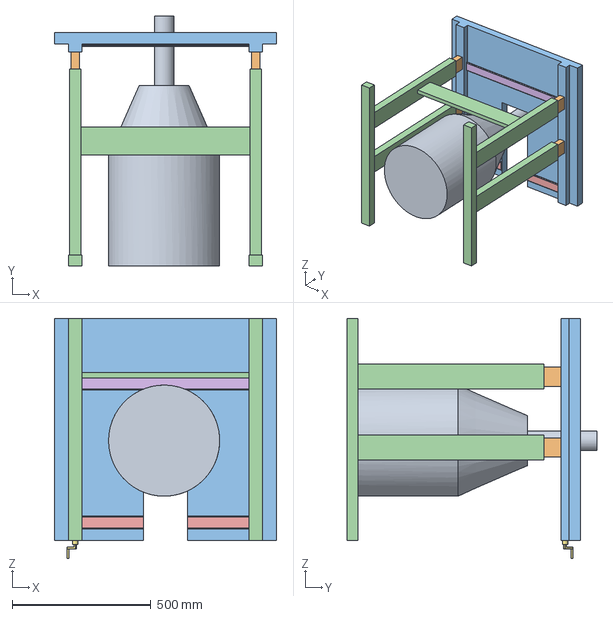
[picture p53: CAD file, 2017-03-01]
figs_and_draws/setup_3D/Table v1.step
800.0 x 900.0 x 865.0 mm
