ASamarkRoth/ScanningSystem/SveMek files/SensorCutBladeLU v0.step

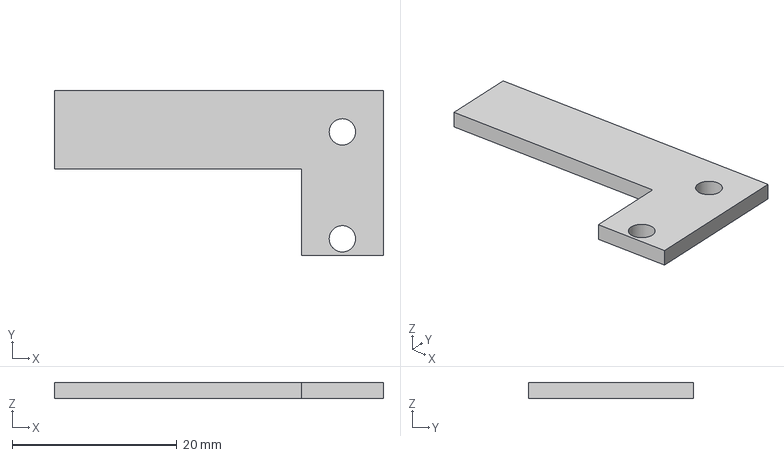
[picture p54: CAD file, 2017-06-30]
SveMek files/SensorCutBladeLU v0.step
40.0 x 20.0 x 2.00 mm
