ASamarkRoth/ScanningSystem/Tungsten pieces/Source holder.step

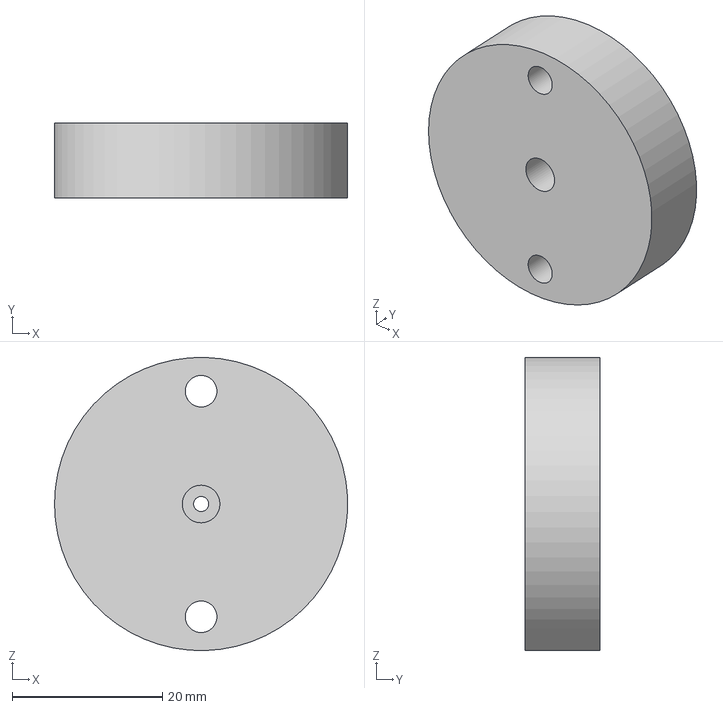
[picture p55: CAD file, 2017-02-06]
Tungsten pieces/Source holder.step
39.0 x 10.0 x 39.0 mm
