ASamarkRoth/ScanningSystem/figs_and_draws/setup_3D/Position table.step

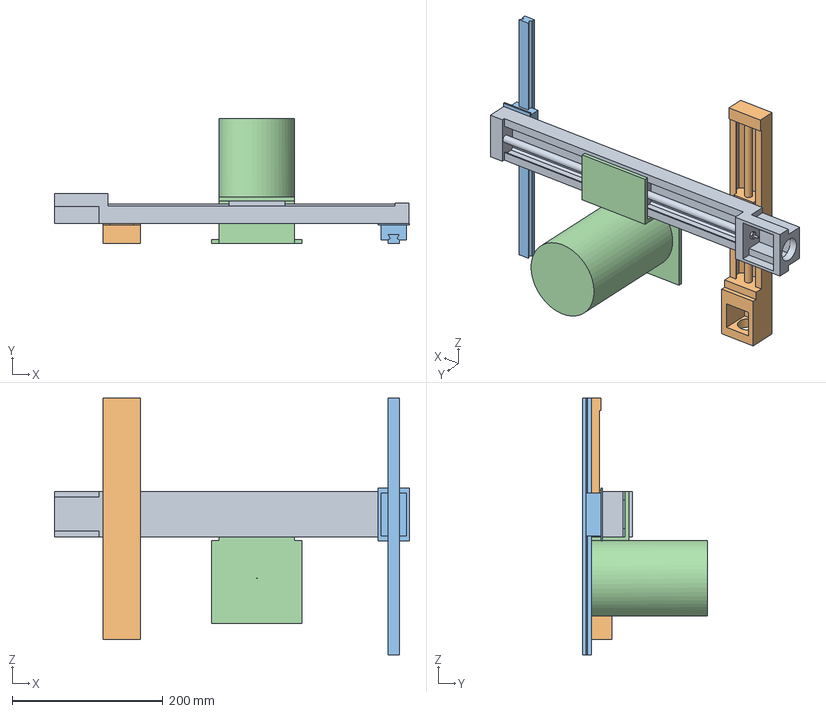
[picture p56: CAD file, 2017-03-01]
figs_and_draws/setup_3D/Position table.step
470.4 x 165.0 x 340.0 mm
