ASamarkRoth/ScanningSystem/SveMek files/SensorCutBladeLG v0.step

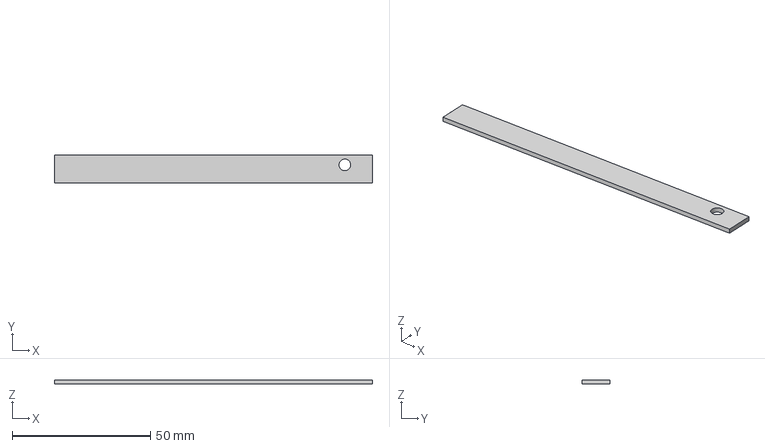
[picture p57: CAD file, 2017-06-30]
SveMek files/SensorCutBladeLG v0.step
115.0 x 10.0 x 1.50 mm
