ASamarkRoth/ScanningSystem/SveMek files/Legs v4.step

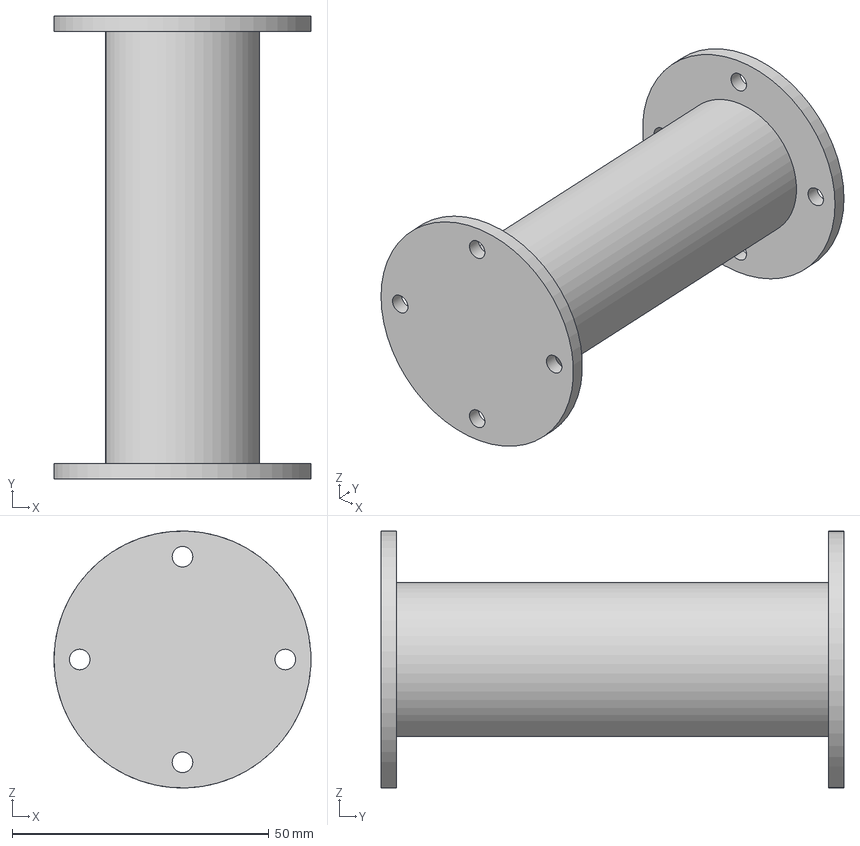
[picture p58: CAD file, 2017-03-17]
SveMek files/Legs v4.step
50.0 x 90.0 x 50.0 mm
