ASamarkRoth/ScanningSystem/SveMek files/Holder plastic base v2.step

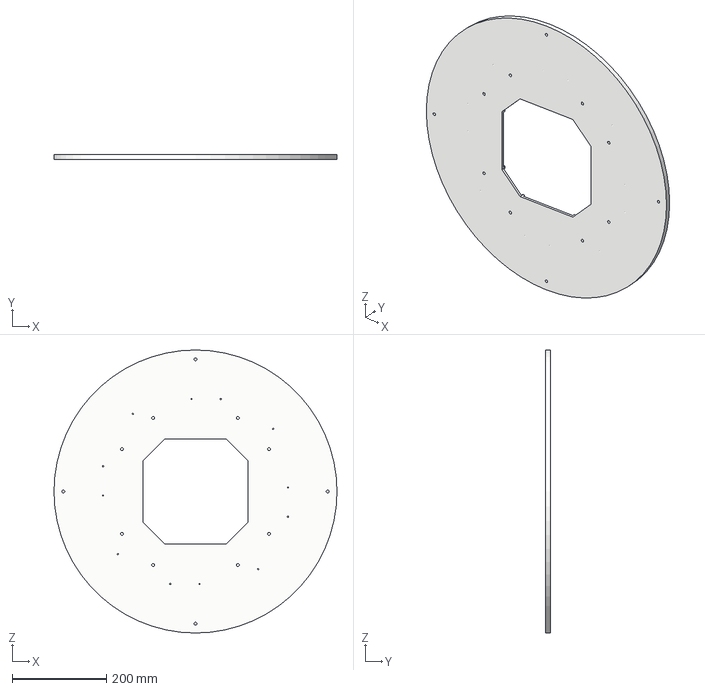
[picture p59: CAD file, 2017-02-13]
SveMek files/Holder plastic base v2.step
600.0 x 10.0 x 600.0 mm
