ASamarkRoth/ScanningSystem/SveMek files/Distance cylinder v1.step

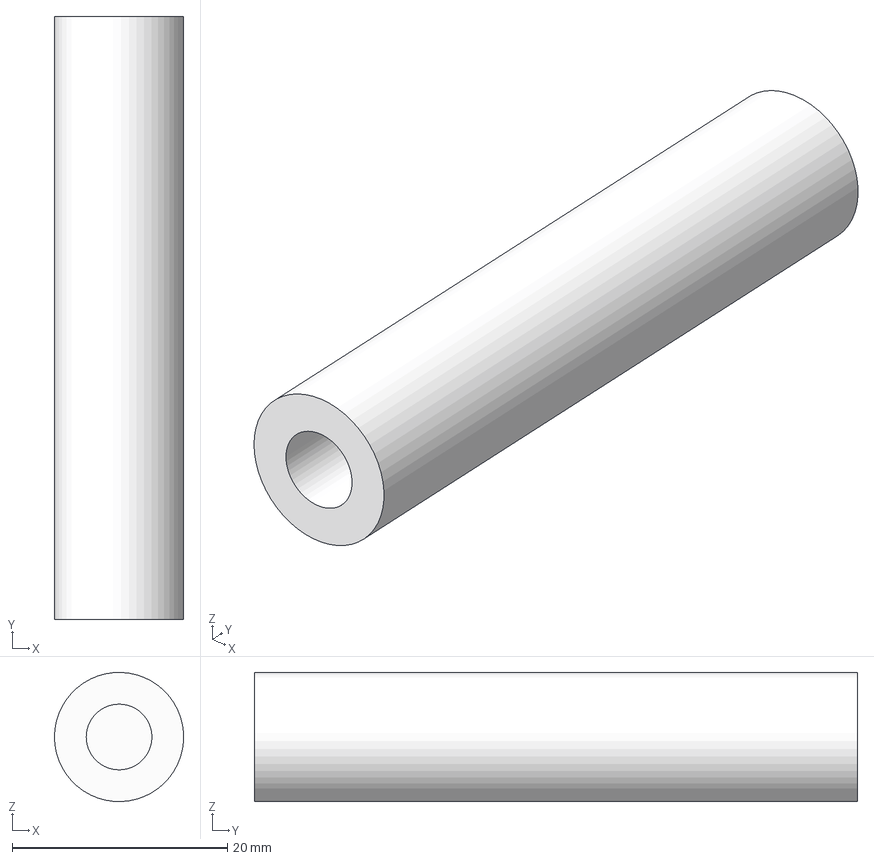
[picture p60: CAD file, 2017-02-10]
SveMek files/Distance cylinder v1.step
12.0 x 56.0 x 12.0 mm
