ASamarkRoth/ScanningSystem/SveMek files/Lycca aluminum base v1.step

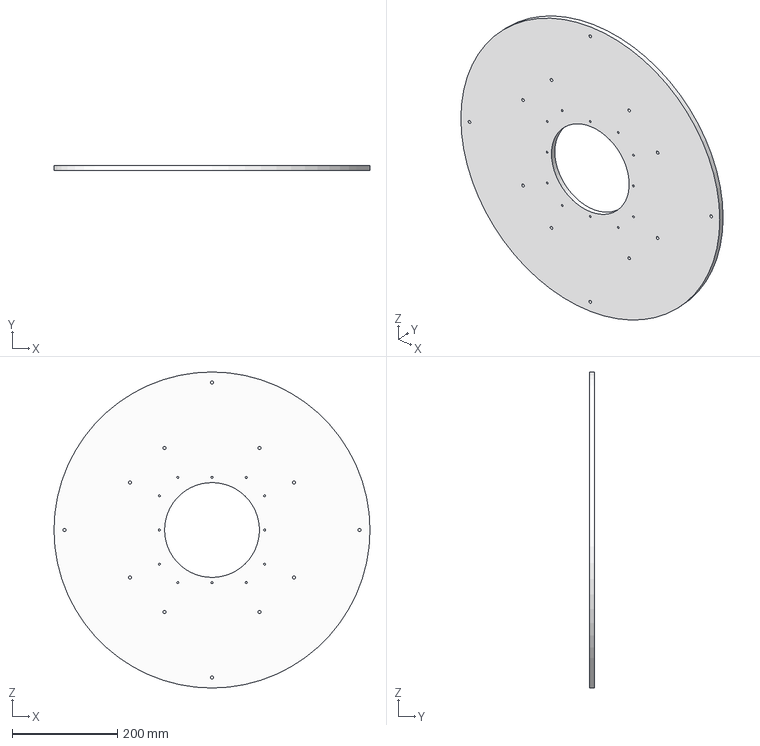
[picture p61: CAD file, 2017-02-10]
SveMek files/Lycca aluminum base v1.step
600.0 x 10.0 x 600.0 mm
