ASamarkRoth/ScanningSystem/(list of files, cad)

Other CAD files:
SveMek files/SensorHolder&Slit v0.step
