ASamarkRoth/ScanningSystem/Report/First measurements/Setup.jpg

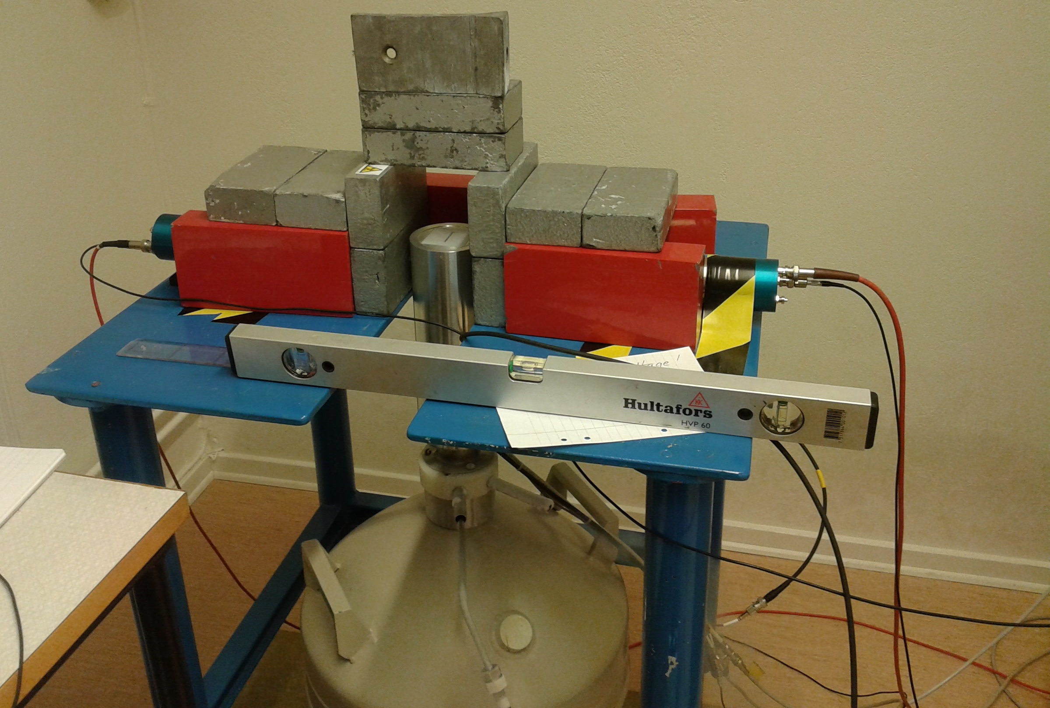
Report/First measurements/Setup.jpg
