ASamarkRoth/ScanningSystem/Report/First measurements/Scan.pdf

### Feuille3

Cobalt 60
Center | Top right | Bottom right Bottom left | Top left
Energy (keV)
FWHM (keV) | 2,49 | 2,76 | 2,87 | 2,98 | 2,62
FWTM (keV) | 4,71 | 5,26 | 5,53 | 5,70 | 5,01
FWFM (keV) | 6,34 | 6,97 | 7,08 | 7,32 | 6,67
FWTM/FWHM | 1,89 | 1,91 | 1,93 | 1,91 | 1,91
FWFM/FWHM | 2,55 | 2,53 | 2,47 | 2,46 | 2,55
| | | Cobalt 57
Center | Top right | Bottom right Bottom left | Top left
Energy (keV) | 121,38 | 121,57 | 121,49 | 121,48 | 121,56
FWHM (keV) | 1,59 | 1,59 | 1,62 | 1,70 | 1,58
FWTM (keV) | 2,90 | 3,13 | 3,17 | 3,29 | 3,08
FWFM (keV) | 4,19 | 4,07 | 4,19 | 4,07 | 3,71
FWTM/FWHM | 1,82 | 1,97 | 1,96 | 1,94 | 1,95
FWFM/FWHM | 2,64 | 2,56 | 2,59 | 2,39 | 2,35
1 332,50 | 1 332,01 | 1 331,91 | 1 331,73 | 1 332,22
