ASamarkRoth/ScanningSystem/Measurements/New crystal/Results.xls

 | 60 keV (single Gaussian) | 60 keV (double Gaussian) | 661 keV | 1332 keV
Resolution (FWHM, keV) | 1.45 | 1.03 | 1.45 | 1.91
FWTM/FWHM |  |  |  | 1.90
FWFM/FWHM |  |  |  | 2.76
