ASamarkRoth/ScanningSystem/Report/First_measurements.pdf

### 1 Overall setup

The global setup uses three detectors: two scintillator detectors, placed on the sides (black squared boxes on the picture, Figure 1) and one semi conductor detector - hyperpure germanium detector -below the collimated source (grey cylinder on the picture). The source is placed on the top lead brick which contains a hole in the middle to collimate the radioactive source. In that position, the source is 97mm from the top of the crystal, which is 5mm from the top of the cryostat (grey cylinder), and collimated in a 5mm hole through an 80mm lead brick. the source is covered by a little lead brick and the setup is shielded by lead to avoid propagation of gamma radiation away from the setup (see Figure 2).


Figure 1: Back of the original setup. The scintillator detectors are the black squared boxes on the sides of the germanium detector, placed in a cryostat (grey cylinder in the middle).

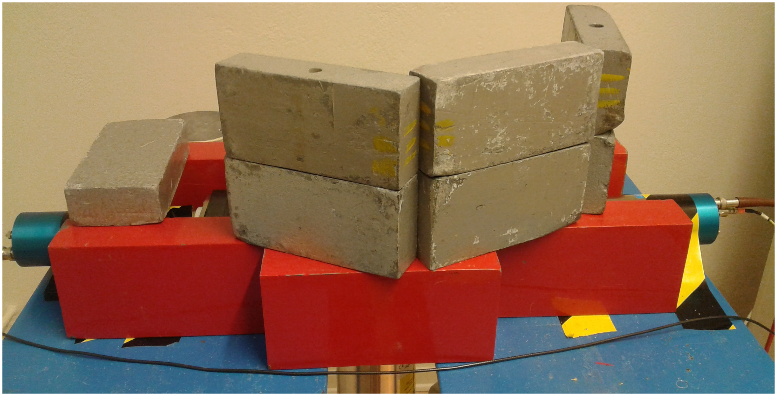
[picture p82: figure]

Figure 2: Front side of the original setup (with the lead shielding).

### 2 Scanning the prototype detector

For this rst set of measurements, we did not use the scintillator detectors but only the germanium detector. The goal of this experiment was to determine some properties of the detector depending on the location of the collimated source. Therefore, we collimated the source in ve dierent places on the top of the crystal: one measurement was performed with the collimator in the center of the crystal surface, and four were performed with the collimator in the corners of the crystal surface. The scanning went as described on Figure ?? and we used two dierent cobalt sources: one of 60Co and one of 57Co (the decay schemes are shown in Figure 2).

| 1

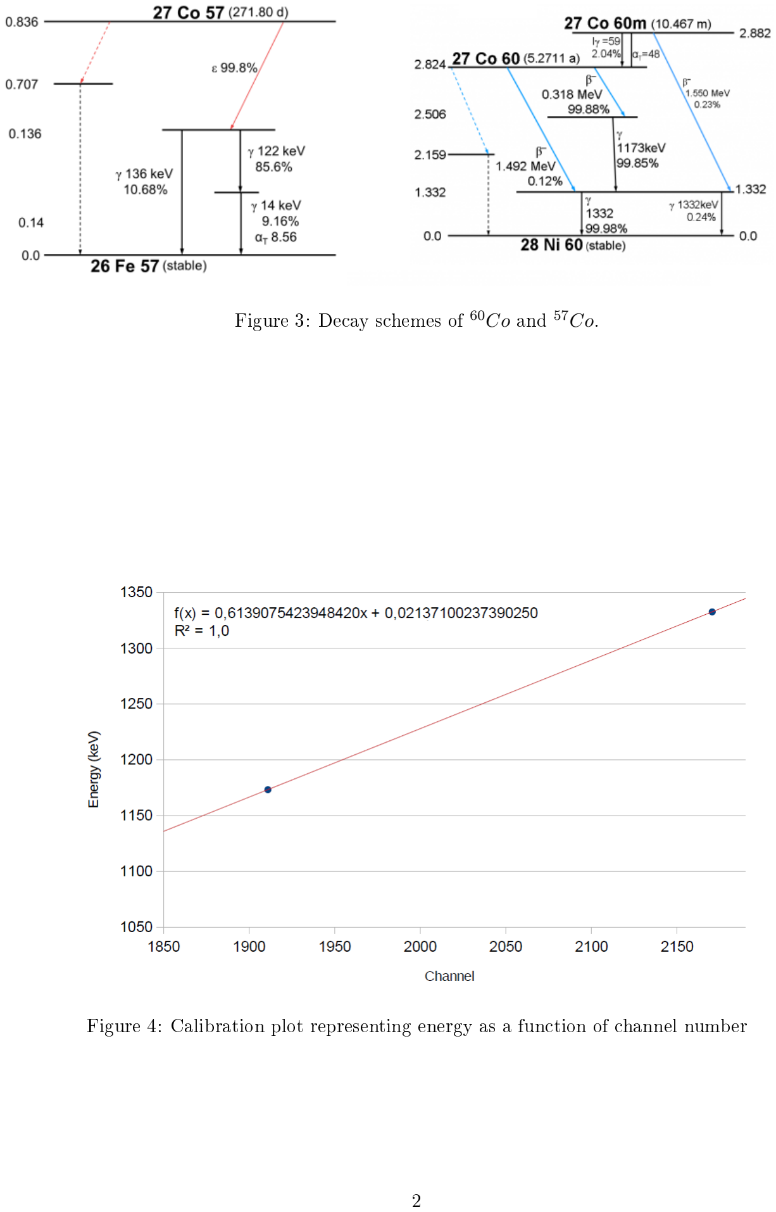
[picture p83: page 2]

Figure 3: Decay schemes of 60Co and 57Co.

Figure 4: Calibration plot representing energy as a function of channel number

2
