ASamarkRoth/ScanningSystem/Report/First measurements/20170213_142723.jpg

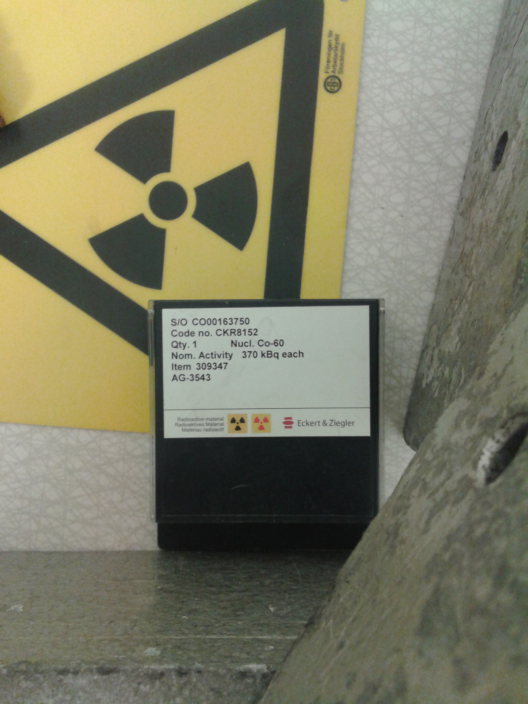
Report/First measurements/20170213_142723.jpg
