ASamarkRoth/ScanningSystem/Report/First measurements/calibration.png

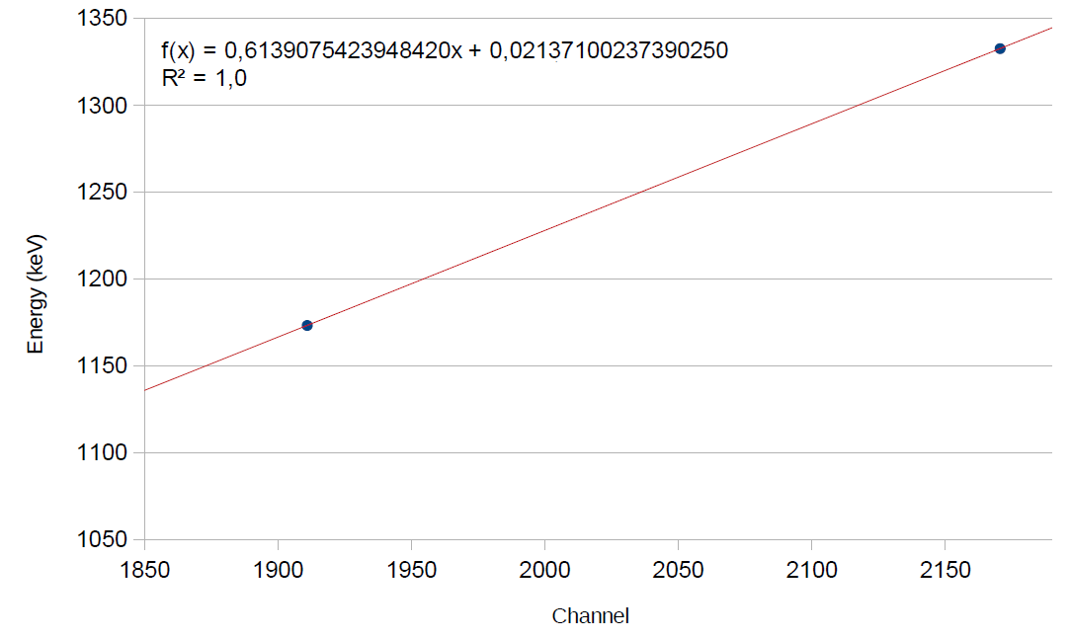
Report/First measurements/calibration.png
