ASamarkRoth/ScanningSystem/Report/First measurements/Calibration_2.png

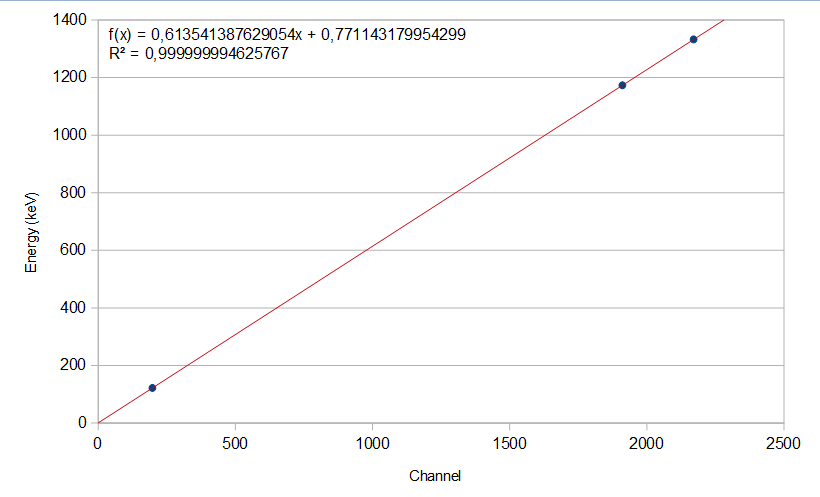
Report/First measurements/Calibration_2.png
