ASamarkRoth/ScanningSystem/Report/First measurements/Co57_decay.png

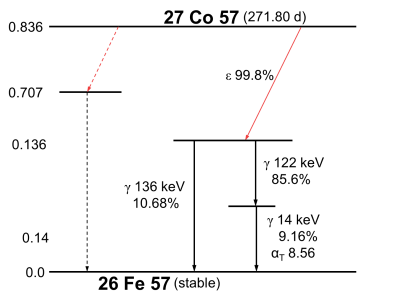
Report/First measurements/Co57_decay.png
