ASamarkRoth/ScanningSystem/Report/First measurements/Cos_decays.png

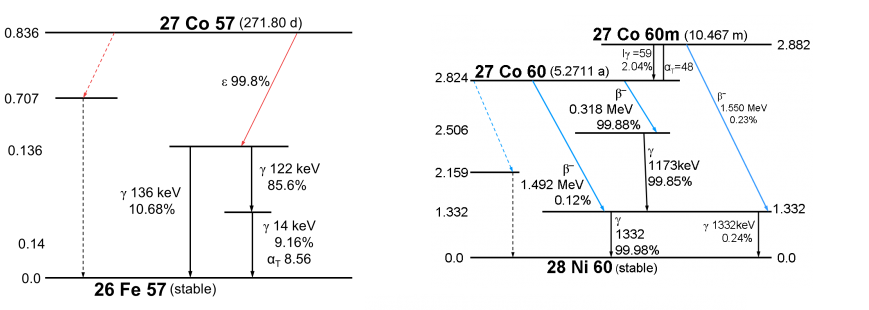
Report/First measurements/Cos_decays.png
