ASamarkRoth/ScanningSystem/Report/First measurements/horiz.png

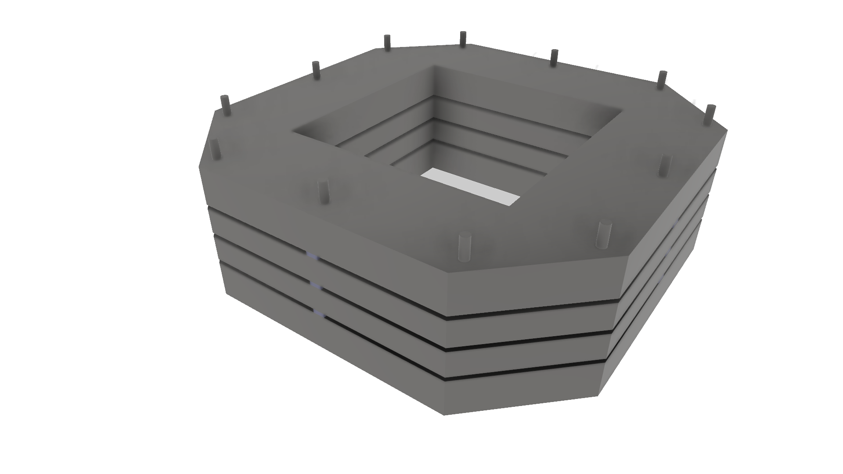
Report/First measurements/horiz.png
