ASamarkRoth/ScanningSystem/Report/First measurements/lycca.png

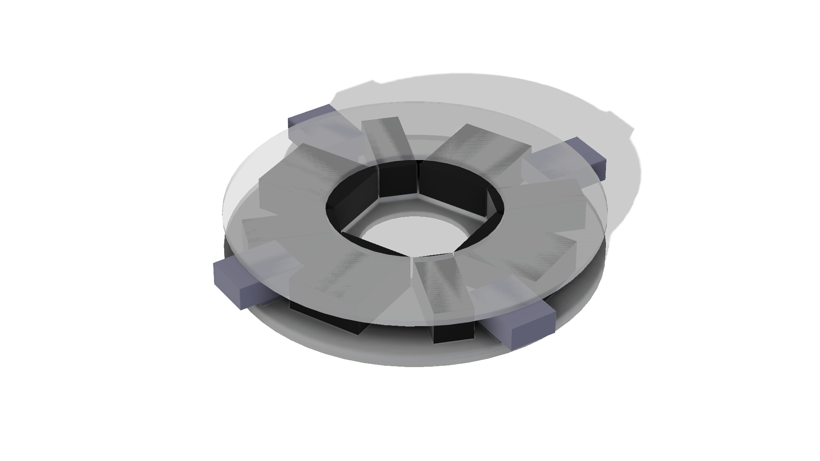
Report/First measurements/lycca.png
