ASamarkRoth/ScanningSystem/Report/First measurements/Modules1.jpg

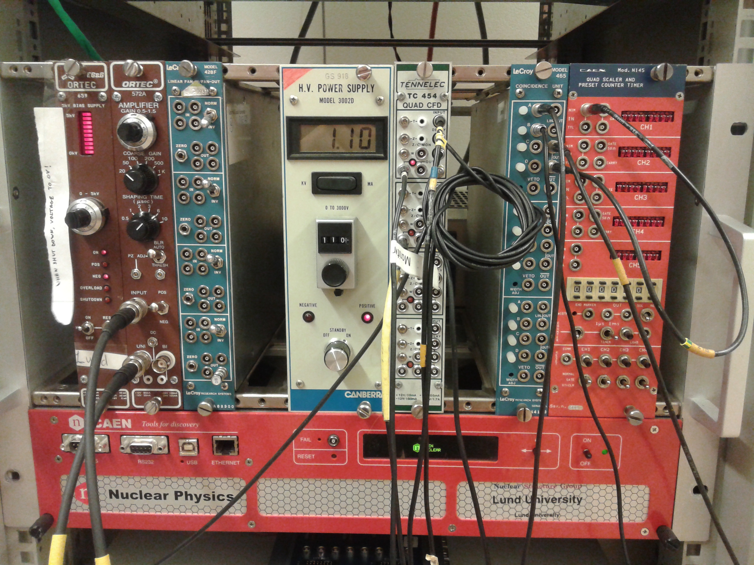
Report/First measurements/Modules1.jpg
