ASamarkRoth/ScanningSystem/Report/First measurements/Modules2.jpg

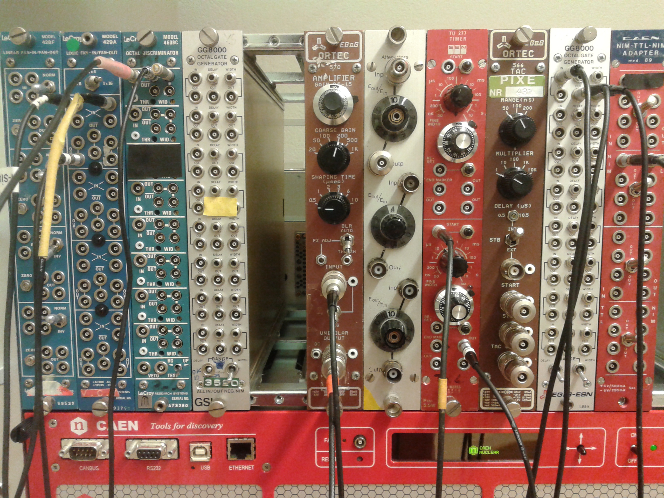
Report/First measurements/Modules2.jpg
