ASamarkRoth/ScanningSystem/Report/First measurements/Nuclchart.png

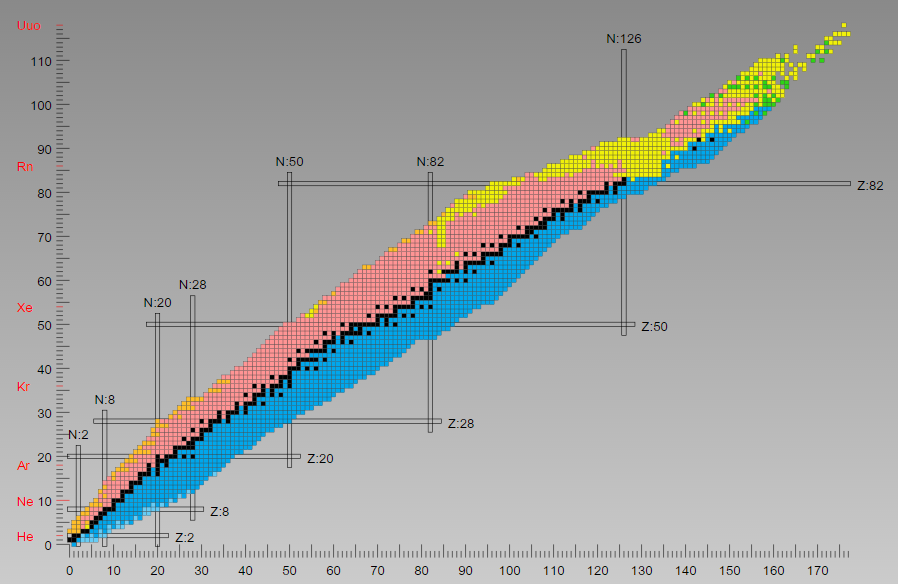
Report/First measurements/Nuclchart.png
