ASamarkRoth/ScanningSystem/Report/First measurements/Scan.png

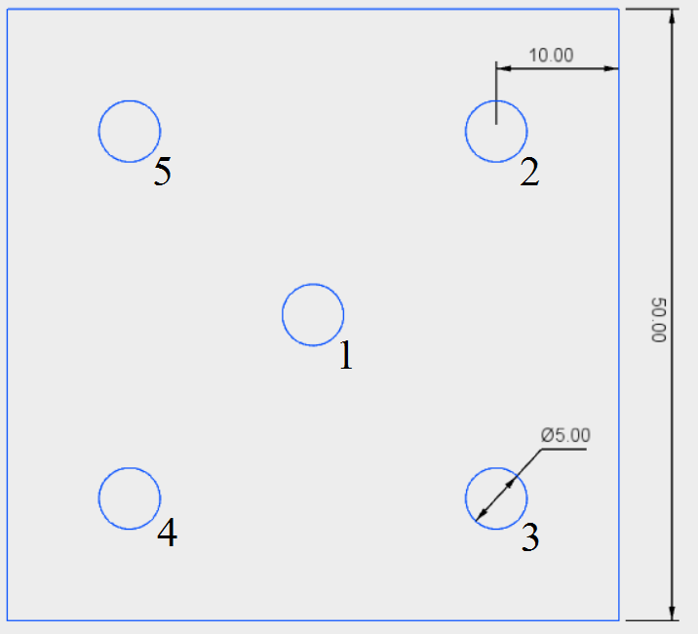
Report/First measurements/Scan.png
