ASamarkRoth/ScanningSystem/Report/First measurements/Scan_Co_57.png

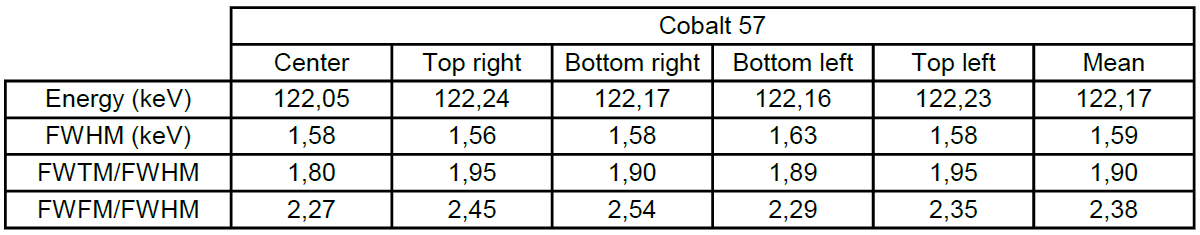
Report/First measurements/Scan_Co_57.png
