ASamarkRoth/ScanningSystem/Report/First measurements/Scan_Co_60.png

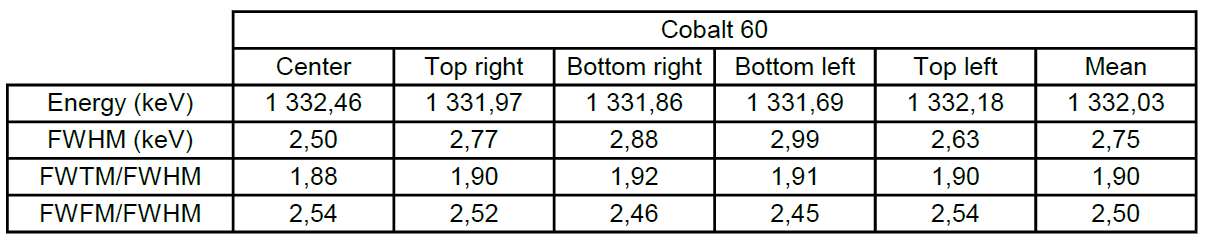
Report/First measurements/Scan_Co_60.png
