ASamarkRoth/ScanningSystem/Report/First measurements/Scan_Cos.png

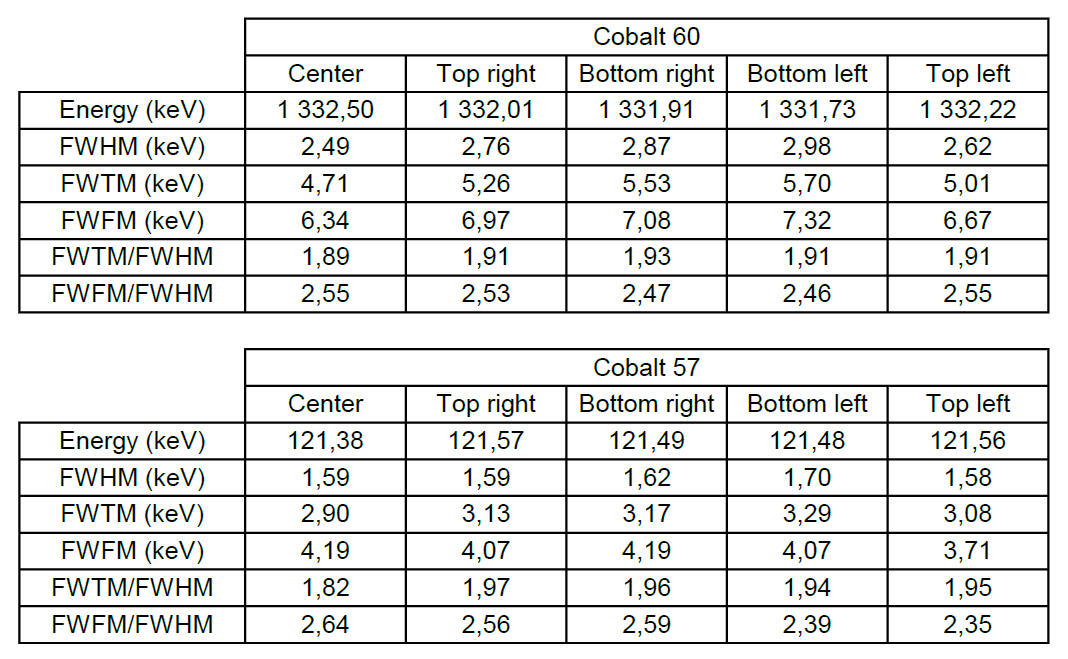
Report/First measurements/Scan_Cos.png
