ASamarkRoth/ScanningSystem/diary.txt

In this document events that have occurred in the use Compex components should be written down.

Compex prototype:
26/01: First HV ramp up, ~500 V per 2 min.
	Signals, well shaped, are there without source
	Co-60 source added - weirdly shaped signals and spectrum
27/01: Change of source to Cs-137 ~10 kBq
	Nice looking spectrum obtained over the weekend
30/01: Change of scale on oscilloscope -> the y-position of the signal shifts, i.e. we have an offset. This was not the case after first ramp up!
	Also, mistakenly ramped up the voltage to max (forgot to rotate switch back). But the signal shape still looked good.
03/02: Change of the shaper, new measurements must be performed. Performed three sets of measurements with source of 60 and 57 cobalt and 137 cesium.
	Measurement of the background has been started and will be on through the weekend.
06/02: Added a bunch of new modules to get some coincidences. The whole scheme will be drawn in the Latex file as soon as I can.
	This far, we have the data for 60 and 57 cobalt, 137 cesium and the background. I will start a measurement with a 55 iron source for the night.
	Worked on coincidences, the whole setup is now working (NIM to TTL was not working correctly) and I will try to get some data tomorrow.
07/02: First data with the whole coincidence setup are now in the "measurement" folder but is the setup really working ?
	Indeed, too much noise on the final coincidence spectrum. Noise may come from the scintillators: performed a coincidence measurement shielding the scintillators and still noise.
	Need to determine exactly how we expect the coincidence spectrum to look like so that we can pursue further.
	Had to do a new calibration (60 cobalt) while we added gain in order to see coincidences.
	The setup changed a little: had to remove one of the "collimation bricks" of lead to get a decent count rate and thus the distance from the source to the top of the crystal changed (-70mm total).
08/02: Started to scan the detector. Used the lead brick to collimate the source (5mm diameter) which is placed at  mm from the top of the detector.
	Measurement are performed as follows: first beam in the center, then top right handed corner and going anti-trigonometric direction.
	First four measurements are done, the last one (top left) will go over night.
09/02: Finished to scan the detector with the cobalt 60 source and started with the cobalt 57 source.
	The source is too weak to give enough statistics: four hour to get a net area of less than 3000 (Canberra used the peak at 122keV with 100 000 net area a least).
	Thus, we won't have a lot of statistics but should be enough to get an idea.
	Started the second measurement for cobalt 57, will finish it tomorrow morning and try to do at least one more.
	Otherwise, I calculated the resolution for the measurements with cobalt 60 source: the results are in the excel file "Results".
10/02: Finished to scan the detector with the cobalt 57 source.
	I stoped the measurements with around 1000 counts in the net area of the peak at 122keV.
	Calculation of the resolution for each measurement are in the 'Results' file, with the symmetry ratios, and I will write a paragraph to analyse these results.
	Still can't calculate the efficiency of the detector while we miss information (the age of the sources basically), need to look for this.
15/02: Point on the analysis now that the measurements are done:
		-At first glance, resolution is a bit lower than what expected seing the Canberra measurements for 60Co but way lower for 57Co (twice larger).
		-The symmetry ratios on the other hand are better than what Canberra measured which means the peaks we have look more like real Gaussians (still need to look at this in detail for the analysis routine in Python).
		-There is a shift in energy between the different positions of the collimated source (center or corners) for both cobalt sources. Fot this, I tried to calibrate using the two sources and not only 60Co to have a 
		 peak in lower energies. The results are "better" in the sense that now the peak in 57Co spectrum is closer to its literature value, but of course, the shift is still present. See the Results excel file.
		-I asked Mikael and the source is so to say a ghost source, implying we don't now its age and thus can't calculate the efficiency of the crystal.
	I will write this in the report today and continue with the analysis (background, other peaks in the spectra, look at the coincidence data...).
	I am calculating the peak-to-Compton values in each case, will finish this tomorrow.
