ASamarkRoth/ScanningSystem/(threads)

Thread 4 (2017-06-23):

Real position update

tfy11aro, 2017-06-23:
Once a coordinate system is chosen it is important to keep using it. Hence, it is essential to update the position according to the motor movement, strictly. Missed steps and if no power is connected need to be properly detected and adjusted for.

tfy11aro, 2017-06-26:
The position update has now been implemented. However, it is unclear what happens if the power is off.

Furthermore, it is essential to fail safe the program if a user wants to terminate in the middle of a scan. A command now exists which activates a stopping of the program whenever the script is called. But this needs further testing and it the order in which the real position is updated needs to be improved in the script.

ASamarkRoth, 2017-11-20:
Unclear what is really meant here. A functioning stop has been implemented ...

Thread 5 (2017-06-26):

Reset to origin

ASamarkRoth, 2017-06-26:
Always have the ability to simply reset the positioning system after a termination or error.

-> Install the photo-sensors and make an activation of two in one direction be the origin.

ASamarkRoth, 2017-11-13:
Photo sensors have now successfully been installed.

Software implementation remains.

ASamarkRoth, 2017-11-20:
Implemented and tested successfully.

Closed 2017-11-20.

Thread 7 (2017-11-13):

Floating ground

ASamarkRoth, 2017-11-13:
Mikael Elfman pointed out that there might be a need for a specific common ground to avoid floating voltages and false signals.

Ask Mikael for a clarification of how this can be implemented.

Thread 8 (2017-11-14):

Reproducibility (x,y)

ASamarkRoth, 2017-11-14:
If an emergency breakdown occurs, how well can we reproduce the (x,y) position scans?

One way to test this is:

1. Set stepper at (x0,y0).
2. Step +100 steps and then -100 steps.
3. How many times can this be done?

On this subject it might become more and more important to fix the sensor cut blades in x such that they are stable.
