ASamarkRoth/ScanningSystem/figs_and_draws/AbsorberHor-V1.0.pdf

Horizontal Absorbers V1.0 | 2x H=19mm
| 2x H=13mm

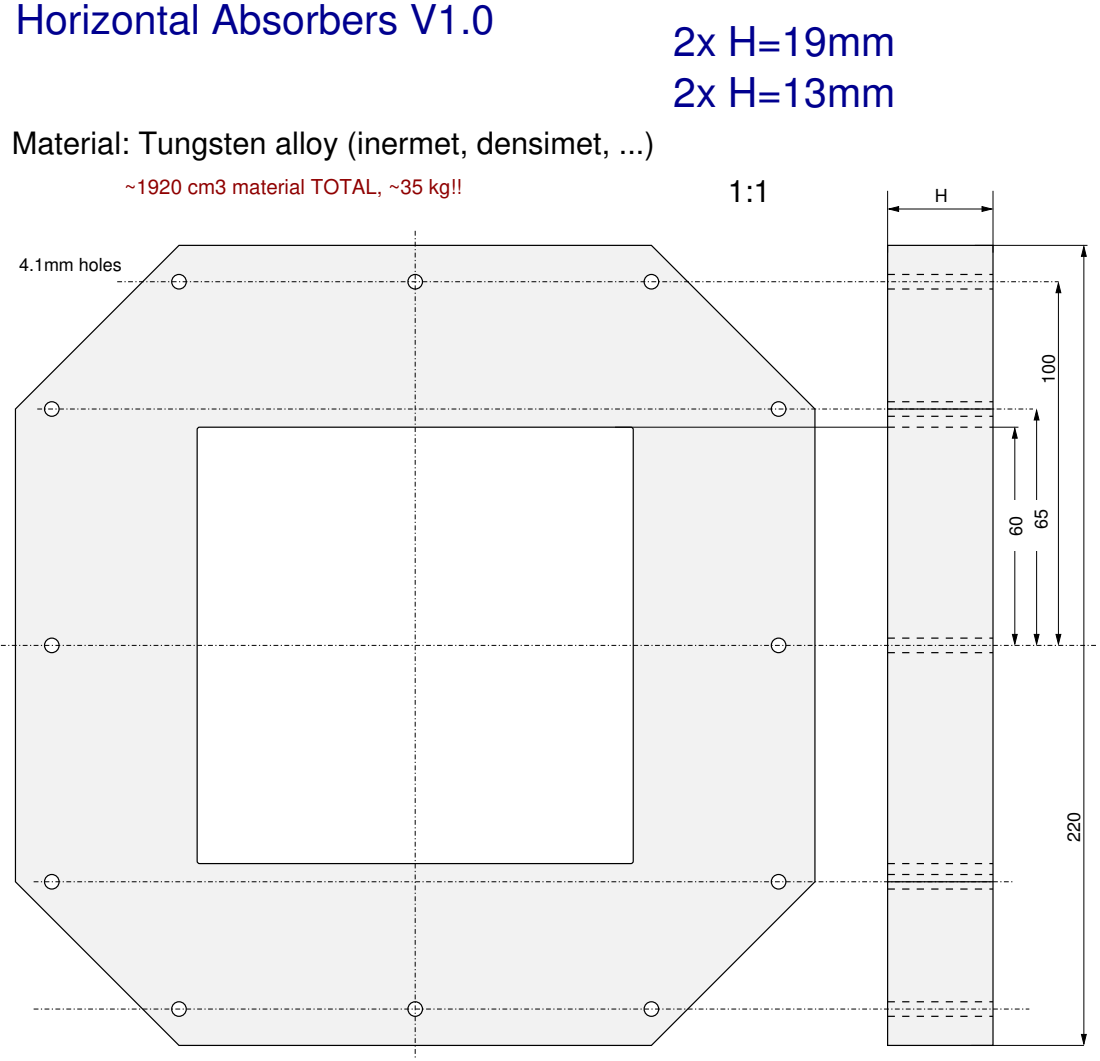
[picture p98: page 1]
4.1mm holes

Material: Tungsten alloy (inermet, densimet, ...)

~1920 cm3 material TOTAL, ~35 kg!!
