ASamarkRoth/ScanningSystem/figs_and_draws/Collimator-V1.0.pdf

1:1

# Material: Tungsten alloy

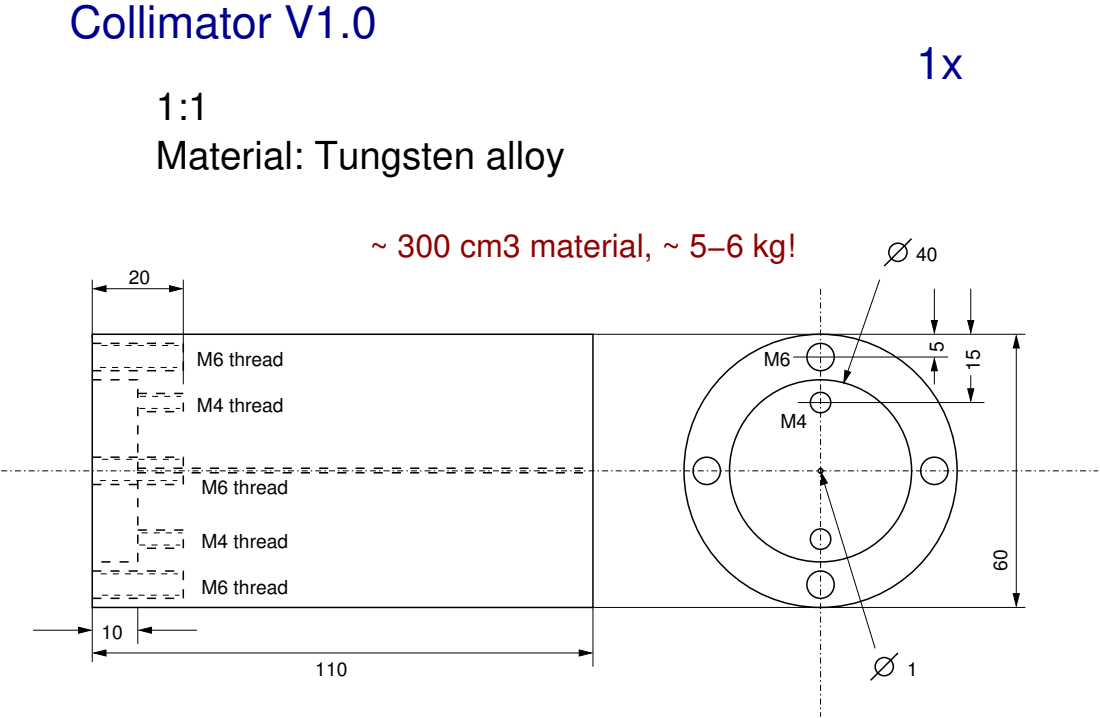
[picture p99: page 1]
M4 thread; M6 thread; Collimator V1.0; ~ 300 cm3 material, ~ 5−6 kg!
