ASamarkRoth/ScanningSystem/figs_and_draws/Lock-Coll-V1.0.pdf

1:1

# Material: Tungsten alloy

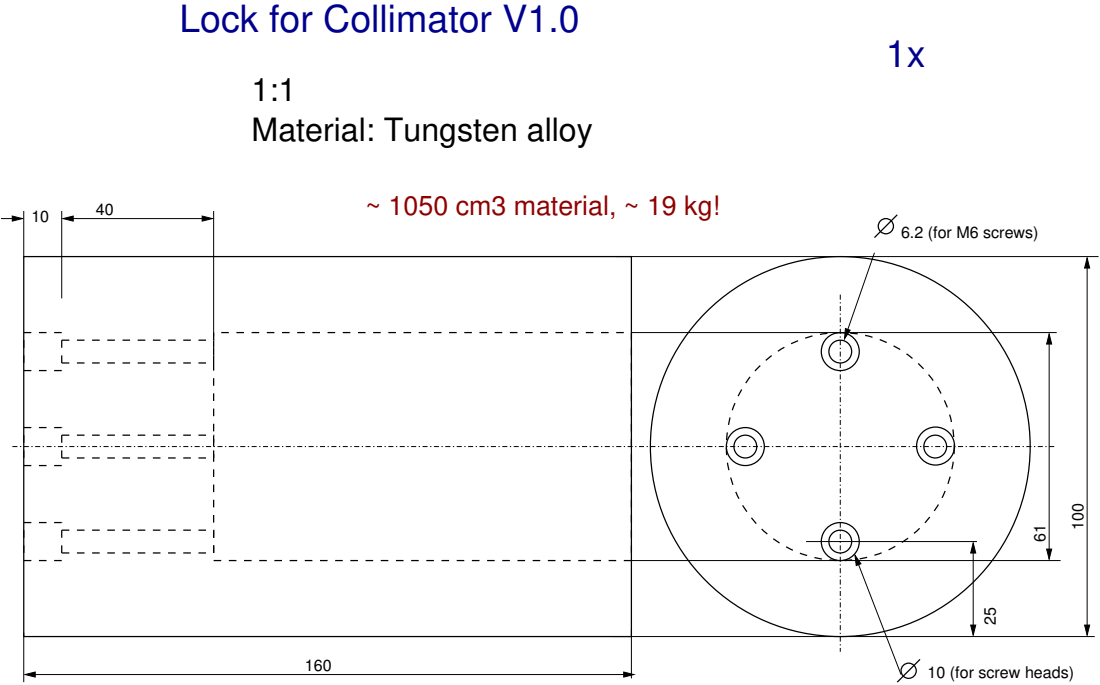
[picture p100: page 1]
6.2 (for M6 screws); ~ 1050 cm3 material, ~ 19 kg!

Lock for Collimator V1.0

10 (for screw heads)
