ASamarkRoth/ScanningSystem/figs_and_draws/Positioning system/Aratron_linjarenheter_kulskruvsdrivna_KK.pdf

# Single Axis Robot

# KK Series

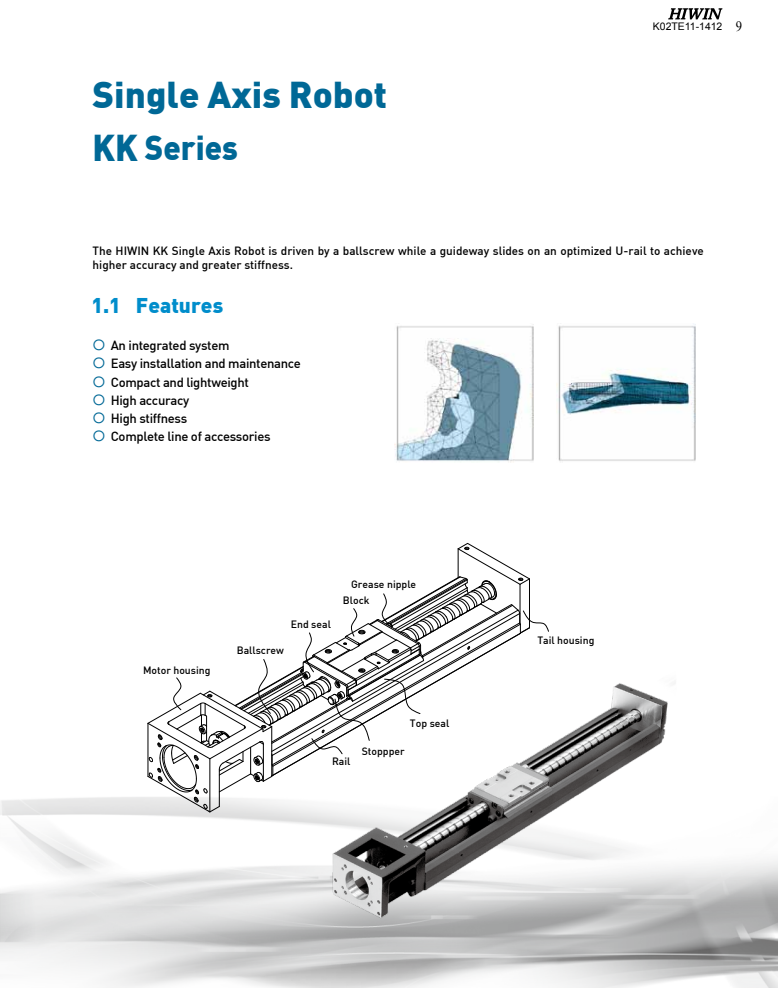
[picture p102: page 1]
Motor housing; Ballscrew; End seal; Block; Grease nipple; Tail housing; Top seal; Stoppper; Rail

The HIWIN KK Single Axis Robot is driven by a ballscrew while a guideway slides on an optimized U-rail to achieve
higher accuracy and greater stiffness.
1.1 Features

〇 An integrated system
〇 Easy installation and maintenance
〇 Compact and lightweight
〇 High accuracy
〇 High stiffness
〇 Complete line of accessories

Taiwan Patent No. 183022
China Patent No. 481446
USA Patent No. 6584868
Germany Patent No. 20117489.8

10 K02TE11-1412

## 1.1.1 Modulization

The KK Single Axis Robot integrating a ballscrew and guideway forms a modularized product. The modularized design can help customers save time, cost and system inspection. Therefore, installation efficiency and a space-saving design are also promoted.

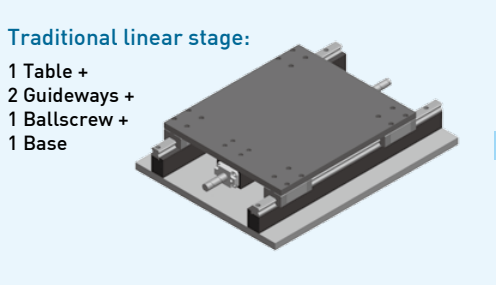
[picture p103: figure]
Traditional linear stage:

## 1.1.2 Equivalent Load

The gothic arch contact design sustains load from all directions and offers high rigidity and accuracy.

## 1.1.3 High Stiffness

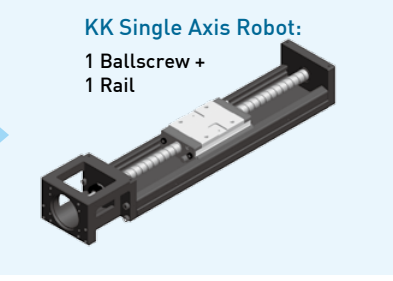
[picture p104: figure]
KK Single Axis Robot: 1 Ballscrew + 1 Rail

Using finite element analysis on the U-shaped cross section allows the volume and rigidity to be made balanced, therefore, a high rigidity rail, compact design and a light weight design are also accomplished

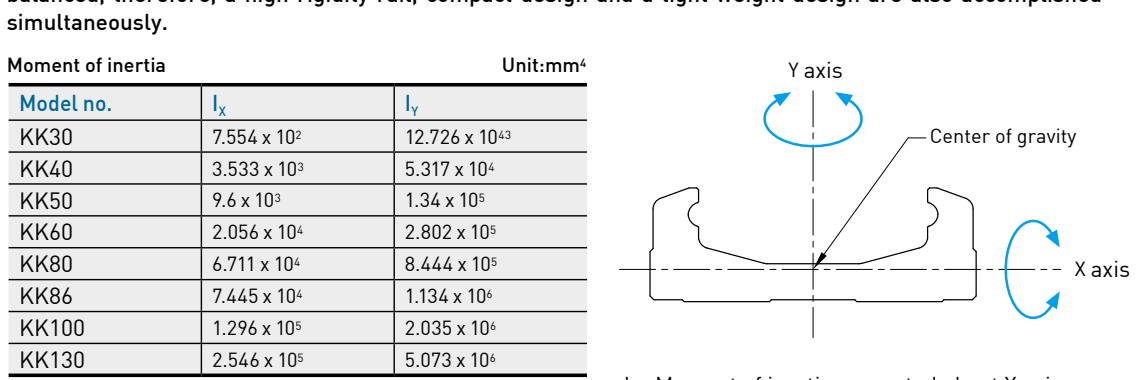
[picture p105: figure]
simultaneously.; Model no.; Moment of inertia; Unit:mm⁴; Center of gravity; Y axis; X axis

## 1.1.4 Various Specification

KK Single Axis Robots of various specifications are developed, providing customers with different choices relating to space and loading conditions.

1 Table +
2 Guideways +
1 Ballscrew +
1 Base

45°

45°

45°

45°

Model no. | W | H
KK30 | 30 | 15
KK40 | 40 | 20
KK50 | 50 | 26
KK60 | 60 | 33
KK80 | 80 | 45
KK86 | 86 | 46
KK100 | 100 | 55
KK130 | 130 | 65

IX : Moment of inertia computed about X axis IY : Moment of inertia computed about Y axis

W

H

# 1.2 Accessories

Accessories of KK Single Axis Robot are also supported for specific demands, such as an aluminum cover, bellows, motor adaptor flange and limit switchs.

### 〇 Aluminum cover and bellow: contamination protection 〇 Motor adaptor flange: connection for different types of motors 〇 Limit switchs: starting point, positioning and other safety matters

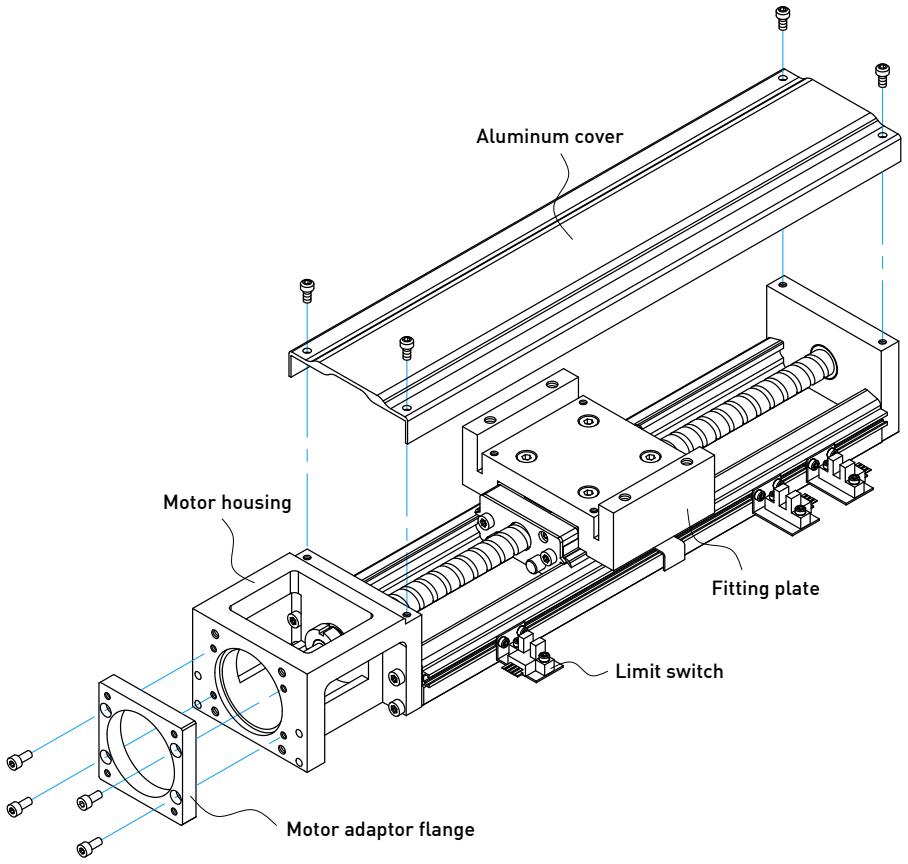
[picture p106: figure]
Aluminum cover; Fitting plate; Limit switch; Motor housing; Motor adaptor flange
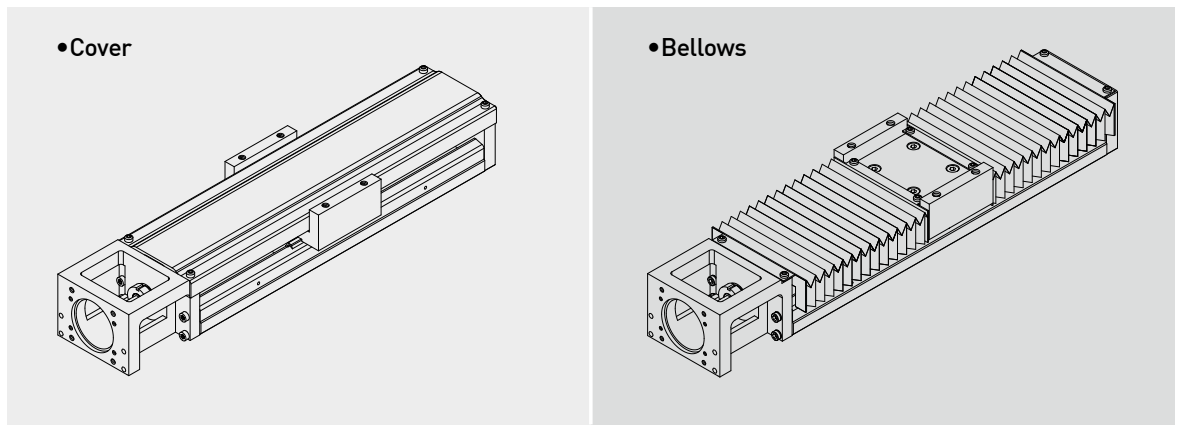
[picture p107: figure]
● Cover; ● Bellows

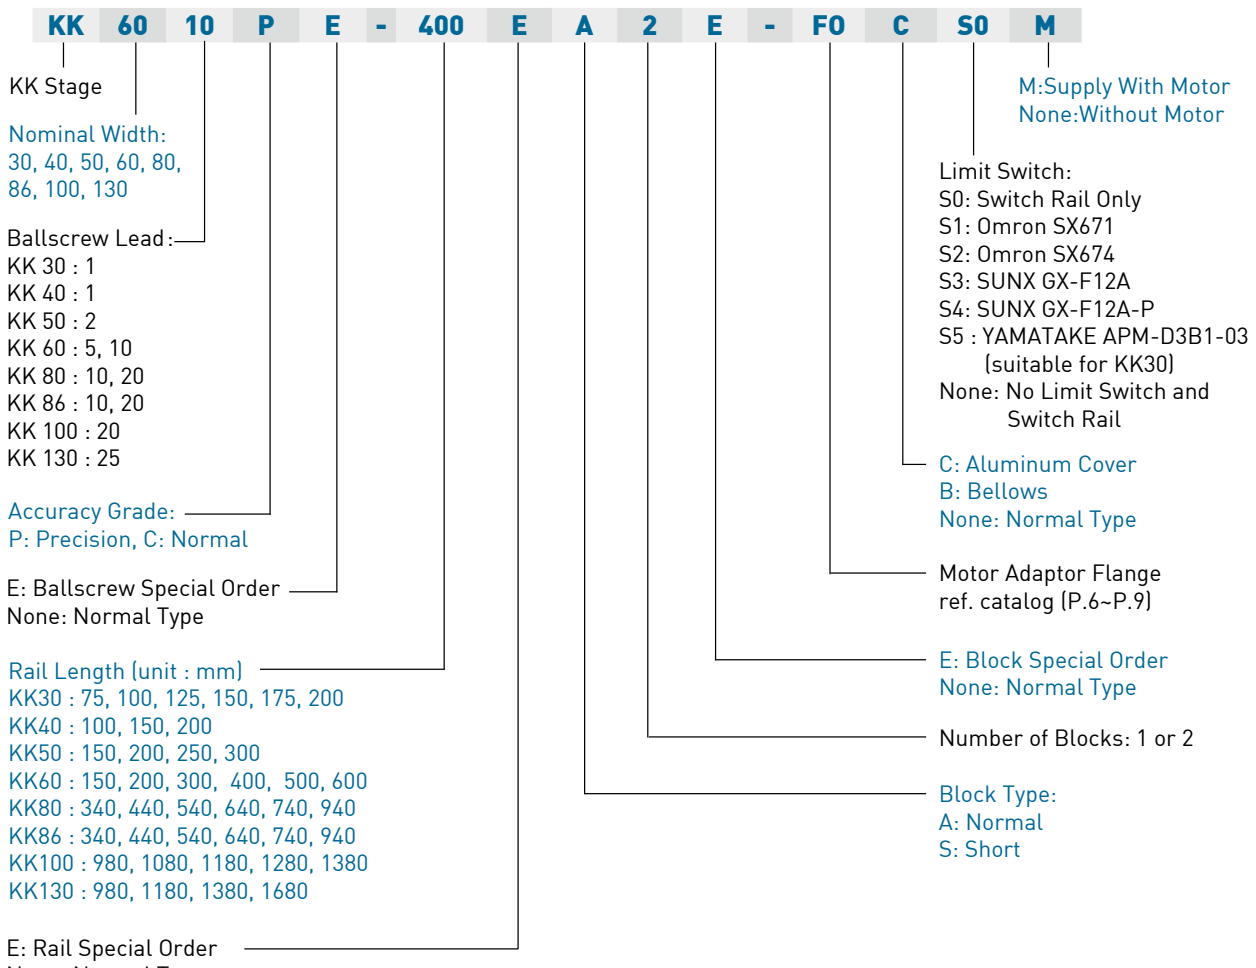
[picture p108: figure]
KK Stage; Nominal Width: 30, 40, 50, 60, 80, 86, 100, 130; Accuracy Grade: P: Precision, C: Normal; E: Ballscrew Special Order None: Normal Type; Rail Length (unit : mm) KK30 : 75, 100, 125, 150, 175, 200 KK40 : 100, 150, 200 KK50 : 150, 200, 250, 300 KK60 : 150, 200, 300, 400, 500, 600 KK80 : 340, 440, 540, 640, 740, 940 KK86 : 340, 440, 540, 640, 740, 940 KK100 : 980, 1080, 1180, 1280, 1380 KK130 : 980, 1180, 1380, 1680; Ballscrew Lead: KK 30 : 1 KK 40 : 1 KK 50 : 2 KK 60 : 5, 10 KK 80 : 10, 20 KK 86 : 10, 20 KK 100 : 20 KK 130 : 25; Limit Switch: S0: Switch Rail Only S1: Omron SX671 S2: Omron SX674 S3: SUNX GX-F12A S4: SUNX GX-F12A-P S5 : YAMATAKE APM-D3B1-03 (suitable for KK30) None: No Limit Switch and Switch Rail; Motor Adaptor Flange ref. catalog (P.6~P.9); E: Block Special Order None: Normal Type; Number of Blocks: 1 or 2; Block Type: A: Normal S: Short; C: Aluminum Cover B: Bellows None: Normal Type; E: Rail Special Order

M:Supply With Motor
None:Without Motor

# 1.3 Model Number of KK Series

Example: KK6010P-400A1-F1CS0

None: Normal Type

# 1.4 Specifications

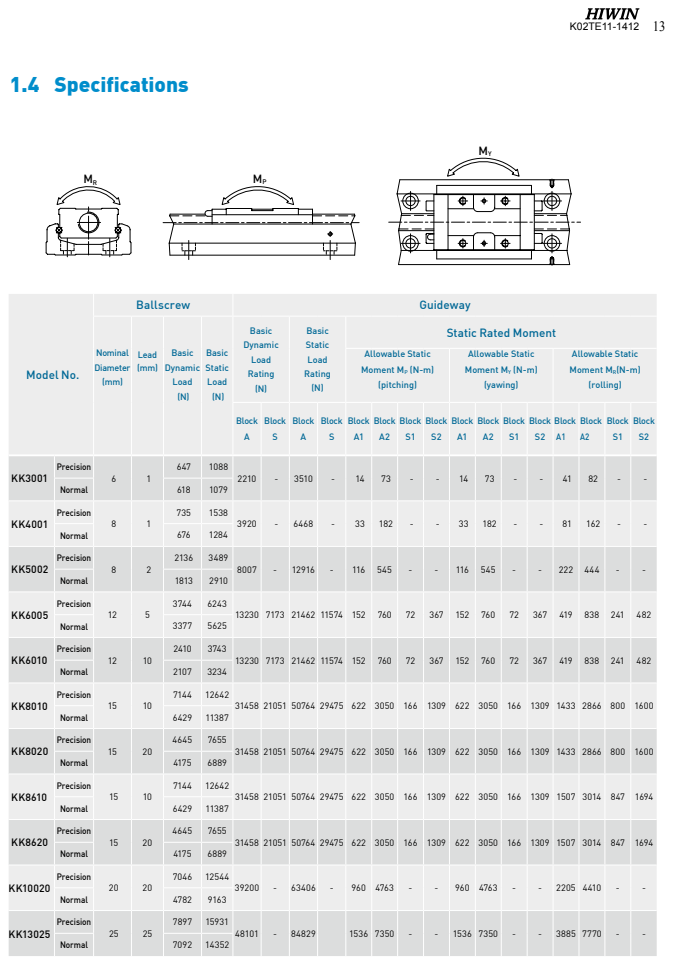
[picture p109: page 5]

Model No. | Ballscrew | Guideway

Basic Dynamic Load Rating (N) | Basic Static Load Rating (N) | Static Rated Moment

Nominal Diameter (mm) | Lead (mm) | Basic Dynamic Load (N) | Basic Static Load (N) | | | Allowable Static Moment MP (N-m) (pitching) | Allowable Static Moment MY (N-m) (yawing) | Allowable Static Moment MR(N-m) (rolling)

Block A | Block S | Block A | Block S | Block A1 | Block A2 | Block S1 | Block S2 | Block A1 | Block A2 | Block S1 | Block S2 | Block A1 | Block A2 | Block S1 | Block S2

KK3001 | Precision | 6 | 1 | 647 | 1088 | 2210 | - | 3510 | - | 14 | 73 | - | - | 14 | 73 | - | - | 41 | 82 | - | -

Normal | | | 618 | 1079

KK4001 | Precision | 8 | 1 | 735 | 1538 | 3920 | - | 6468 | - | 33 | 182 | - | - | 33 | 182 | - | - | 81 | 162 | - | -

Normal | | | 676 | 1284

KK5002 | Precision | 8 | 2 | 2136 | 3489 | 8007 | - | 12916 | - | 116 | 545 | - | - | 116 | 545 | - | - | 222 | 444 | - | -

Normal | | | 1813 | 2910

KK6005 | Precision | 12 | 5 | 3744 | 6243 | 13230 | 7173 | 21462 | 11574 | 152 | 760 | 72 | 367 | 152 | 760 | 72 | 367 | 419 | 838 | 241 | 482

Normal | | | 3377 | 5625

KK6010 | Precision | 12 | 10 | 2410 | 3743 | 13230 | 7173 | 21462 | 11574 | 152 | 760 | 72 | 367 | 152 | 760 | 72 | 367 | 419 | 838 | 241 | 482

Normal | | | 2107 | 3234

KK8010 | Precision | 15 | 10 | 7144 | 12642 | 31458 | 21051 | 50764 | 29475 | 622 | 3050 | 166 | 1309 | 622 | 3050 | 166 | 1309 | 1433 | 2866 | 800 | 1600

Normal | | | 6429 | 11387

KK8020 | Precision | 15 | 20 | 4645 | 7655 | 31458 | 21051 | 50764 | 29475 | 622 | 3050 | 166 | 1309 | 622 | 3050 | 166 | 1309 | 1433 | 2866 | 800 | 1600

Normal | | | 4175 | 6889

KK8610 | Precision | 15 | 10 | 7144 | 12642 | 31458 | 21051 | 50764 | 29475 | 622 | 3050 | 166 | 1309 | 622 | 3050 | 166 | 1309 | 1507 | 3014 | 847 | 1694

KK8620 | Precision | 15 | 20 | 4645 | 7655 | 31458 | 21051 | 50764 | 29475 | 622 | 3050 | 166 | 1309 | 622 | 3050 | 166 | 1309 | 1507 | 3014 | 847 | 1694

KK10020 | Precision | 20 | 20 | 7046 | 12544 | 39200 | - | 63406 | - | 960 | 4763 | - | - | 960 | 4763 | - | - | 2205 | 4410 | - | -

Normal | | | 4782 | 9163

KK13025 | Precision | 25 | 25 | 7897 | 15931 | 48101 | - | 84829 | | 1536 | 7350 | - | - | 1536 | 7350 | - | - | 3885 | 7770 | - | -

Normal | | | 7092 | 14352

# 1.5 Accuracy Grade

Unit : mm
Model | Rail Length | Repeatability | Accuracy | Running Parallelism | Starting Torque(N-cm)
Precision | Normal | Precision | Normal | Precision | Normal | Precision | Normal
KK30 | 75 | ±0.003 | ±0.004 | 0.02 | 0.04 | 0.01 | 0.02 | 1.2 | 0.8
100
125
150
175
200

KK40

100
150 | ±0.003 | ±0.01 | 0.02 | - | 0.01 | - | 1.2 | 0.8
200

KK50

150

±0.003 | ±0.01 | 0.02 | - | 0.01 | - | 4 | 2

200
250
300

KK60

150

±0.003 | ±0.01 | 0.02 | - | 0.01 | - | 15 | 7

200
300
400
500
±0.003 | ±0.01 | 0.025 | - | 0.015 | - | 15 | 7
600

KK80

340

±0.003 | ±0.01 | 0.025 | - | 0.015 | - | 15 | 10

440
540
640
740 | ±0.003 | ±0.01 | 0.03 | - | 0.02 | - | 17 | 10
940 | ±0.003 | ±0.01 | 0.04 | - | 0.03 | - | 25 | 10
KK86 | 340 | ±0.003 | ±0.01 | 0.025 | - | 0.015 | - | 15 | 10
440
540
640
740 | ±0.003 | ±0.01 | 0.03 | - | 0.02 | - | 17 | 10
940 | ±0.003 | ±0.01 | 0.04 | - | 0.03 | - | 25 | 10
KK100 | 980 | ±0.005 | ±0.01 | 0.035 | - | 0.025 | - | 17 | 12
1080
1180 | ±0.005 | ±0.01 | 0.04 | - | 0.03 | - | 20 | 12
1280 | ±0.005 | ±0.01 | 0.045 | - | 0.035 | - | 23 | 15
1380 | | | 0.05 | | 0.04 | | 25
KK130 | 980 | ±0.005 | ±0.01 | 0.035 | - | 0.025 | - | 25 | 15
| 1180 | | | 0.04 | | 0.03 | | 25 | 15
1380
1680 | ±0.007 | ±0.012 | 0.05 | - | 0.04 | - | 27 | 18

# 1.6 Maximum Speed Limit

Model | Ballscrew Lead (mm) | Rail Length (mm) | Speed (mm/sec)
Precision | Normal
KK30 | 01 | 75 | 160 | 160
| | 100 | 160 | 160
| | 125 | 160 | 160
| | 150 | 160 | 160
| | 175 | 160 | 160
| | 200 | 160 | 160
KK40 | 01 | 100 | 190 | 190
| | 150 | 190 | 190
| | 200 | 190 | 190
KK50 | 02 | 150 | 270 | 270
| | 200 | 270 | 270
| | 250 | 270 | 270
| | 300 | 270 | 270
KK60 | 05 | 150 | 550 | 390
| | 200 | 550 | 390
| | 300 | 550 | 390
| | 400 | 550 | 390
| | 500 | 550 | 390
| | 600 | 340 | 340
| 10 | 150 | 1100 | 790
| | 200 | 1100 | 790
| | 300 | 1100 | 790
| | 400 | 1100 | 790
| | 500 | 1100 | 790
| | 600 | 670 | 670
KK80 | 10 | 340 | 740 | 520
| | 440 | 740 | 520
| | 540 | 740 | 520
| | 640 | 740 | 520
| | 740 | 740 | 520
| | 940 | 610 | 430
| 20 | 340 | 1480 | 1050
| | 440 | 1480 | 1050
| | 540 | 1480 | 1050
| | 640 | 1480 | 1050
| | 740 | 1480 | 1050
| | 940 | 1220 | 870
KK86 | 10 | 340 | 740 | 520
| | 440 | 740 | 520
| | 540 | 740 | 520
| | 640 | 740 | 520
| | 740 | 740 | 520
| | 940 | 610 | 430
| 20 | 340 | 1480 | 1050
| | 440 | 1480 | 1050
| | 540 | 1480 | 1050
| | 640 | 1480 | 1050
| | 740 | 1480 | 1050
| | 940 | 1220 | 870
KK100 | 20 | 980 | 1120 | 800
| | 1080 | 980 | 800
| | 1180 | 750 | 750
| | 1280 | 630 | 630
| | 1380 | 530 | 530
KK130 | 25 | 980 | 1120 | 800
| | 1180 | 1120 | 800
| | 1380 | 830 | 800
| | 1680 | 550 | 550

# 1.7 Life Calculations

# 1.7.1 Service Life

Under repeated stress between the raceway and the rolling elements, pitting and flaking will occur as it reaches fatigue failure. The service life of the KK Single Axis Robot is defined as the distanced traveled before any failure of the raceway or rolling elements appear.

# 1.7.2 Nominal Life (L)

The service life varies greatly even when the KK units are manufactured in the same way or operated under the same conditions. For this reason, nominal life is used as the criteria for predicting the service life of a KK unit.

# 1.7.3 Nominal Life Calculation

The calculating formulas are divided into two parts, guideway and ballscrew. The smaller value of the two would be the recommended nominal life of the KK unit.
Nominal life formulas for both the guideway and ballscrew depend on several parameters and are shown below.

# Guideway

L : Life Rating (km) | C : Basic Dynamic Load Rating (N)
ft : Contact Coefficient (ref. Table 1) | Pn : Calculated Loading (N)
fw : Loading Coefficient (ref. Table 2)

# L = ( ft . C

)

3
x 50 km fw | Pn
L : Life Rating (rev.) | Ca : Basic Dynamic Load Rating (N)
fw : Loading Coefficient (ref. Table 2) | Pa,n : Axial Loading (N)
Operating Condition | Loading
| Velocity (V) | Coefficient fw Thrust and Vibration
No Thrust | V﹤15m/min | 1.0 ~ 1.5
Low Vibration | 15m/min﹤V﹤60m/min | 1.5 ~ 2.0
High Vibration | V﹥60m/min | 2.0 ~ 3.5

# Ballscrew and Bearing

Table 2

# L = ( 1 . Ca

)

3
x 10⁶ rev fw | Pa,n
Block Type | Contact Coefficient ft
A1, S1 | 1.0
A2, S2 | 0.81

Table 1

T =

100 × 1000
Ve × 60

Insufficient lubrication of the guideway would lead to a reduction of the service life. The lubricant provides the following functions: ● Reducing rolling friction and avoiding abrasion ● Providing a lubricating film and extending the service life ● Anti-rusting

# 1.8.1 Lubricating Grease

Re-lubricating the KK Single Axis Robot every 100km is recommened. Generally, grease is applied for speeds under 60 m/min. For operating speeds over 60 m/min, a grease with a higher viscosity should be used.

# 1.8.2 Grease Nipple

# 1.8 Lubrication

T : Lubricating frequency (hrs) Ve : Speed (m/min)

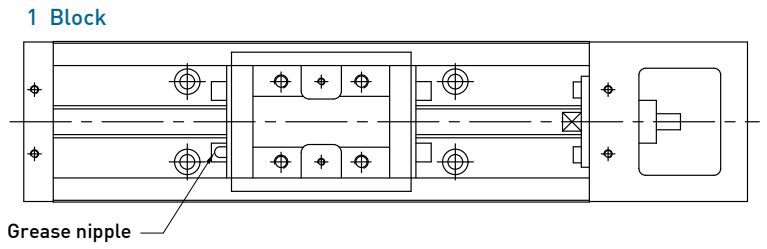
[picture p110: figure]
1 Block; Grease nipple
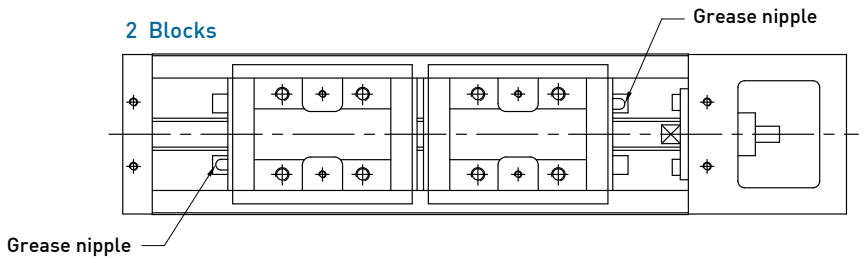
[picture p111: figure]
2 Blocks; Grease nipple

# 1.9 Dimensions

# 1.9.1 Without cover

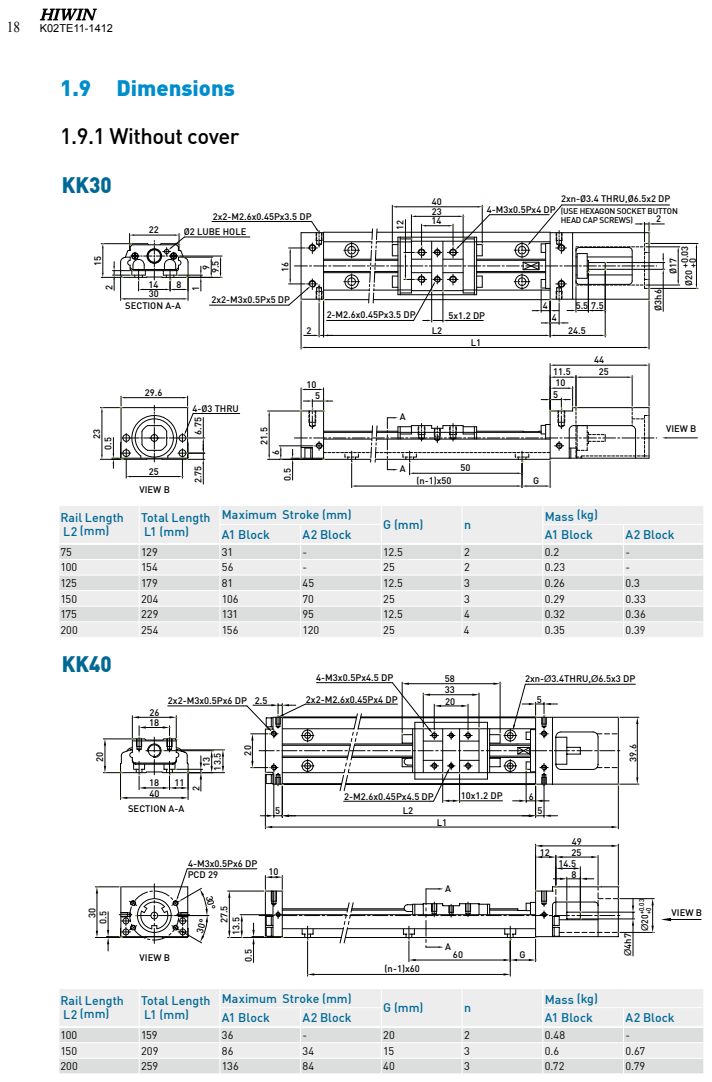
[picture p112: page 10]
4-Ø3 THRU; SECTION A-A; Ø2 LUBE HOLE; VIEW B; 2xn-Ø3.4THRU,Ø6.5x3 DP39.6; 4-M3x0.5Px6 DP PCD 29

2xn-Ø3.4 THRU,Ø6.5x2 DP
(USE HEXAGON SOCKET BUTTON
HEAD CAP SCREWS)

Rail Length L2 (mm) | Total Length L1 (mm) | Maximum Stroke (mm) | G (mm) | n | Mass (kg)

A1 Block | A2 Block | | | A1 Block | A2 Block

75 | 129 | 31 | - | 12.5 | 2 | 0.2 | -
100 | 154 | 56 | - | 25 | 2 | 0.23 | -
125 | 179 | 81 | 45 | 12.5 | 3 | 0.26 | 0.3
150 | 204 | 106 | 70 | 25 | 3 | 0.29 | 0.33
175 | 229 | 131 | 95 | 12.5 | 4 | 0.32 | 0.36
200 | 254 | 156 | 120 | 25 | 4 | 0.35 | 0.39

100 | 159 | 36 | - | 20 | 2 | 0.48 | -
150 | 209 | 86 | 34 | 15 | 3 | 0.6 | 0.67
200 | 259 | 136 | 84 | 40 | 3 | 0.72 | 0.79

KK50

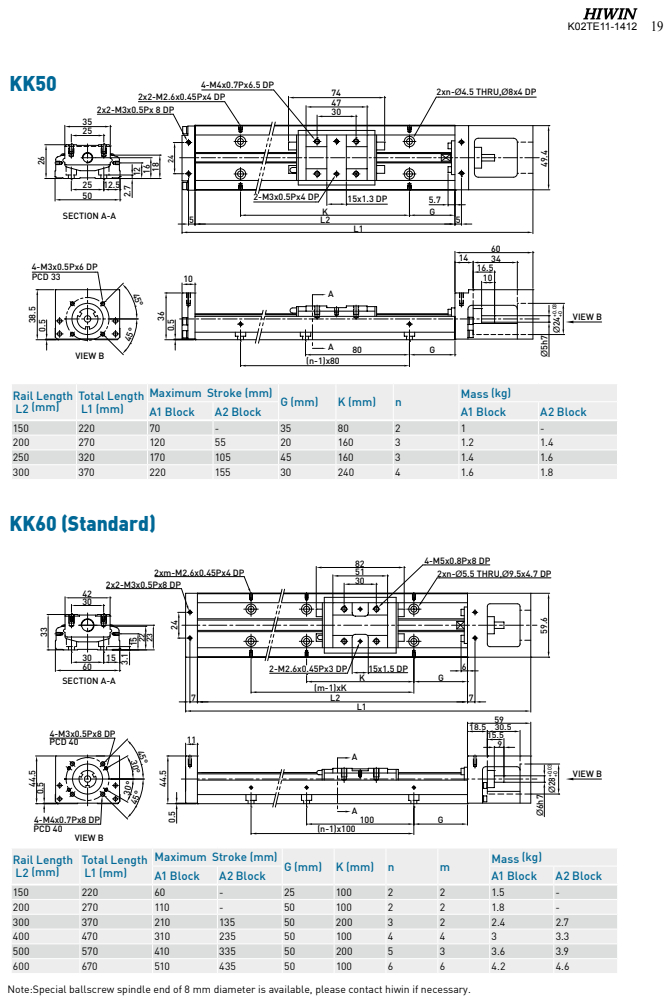
[picture p113: page 11]
SECTION A-A; VIEW B; PCD 33; KK60 (Standard); 30 60 SECTION A-A; PCD 40; 2xn-Ø5.5 THRU,Ø9.5x4.7 DP

2xn-Ø4.5 THRU,Ø8x4 DP 2x2-M2.6x0.45Px4 DP

Rail Length L2 (mm) | Total Length L1 (mm) | Maximum Stroke (mm) | G (mm) | K (mm) | n | Mass (kg)

A1 Block | A2 Block | | | | A1 Block | A2 Block

150 | 220 | 70 | - | 35 | 80 | 2 | 1 | -
200 | 270 | 120 | 55 | 20 | 160 | 3 | 1.2 | 1.4
250 | 320 | 170 | 105 | 45 | 160 | 3 | 1.4 | 1.6
300 | 370 | 220 | 155 | 30 | 240 | 4 | 1.6 | 1.8

Rail Length L2 (mm) | Total Length L1 (mm) | Maximum Stroke (mm) | G (mm) | K (mm) | n | m | Mass (kg)

A1 Block | A2 Block | | | | | A1 Block | A2 Block

150 | 220 | 60 | - | 25 | 100 | 2 | 2 | 1.5 | -
200 | 270 | 110 | - | 50 | 100 | 2 | 2 | 1.8 | -
300 | 370 | 210 | 135 | 50 | 200 | 3 | 2 | 2.4 | 2.7
400 | 470 | 310 | 235 | 50 | 100 | 4 | 4 | 3 | 3.3
500 | 570 | 410 | 335 | 50 | 200 | 5 | 3 | 3.6 | 3.9
600 | 670 | 510 | 435 | 50 | 100 | 6 | 6 | 4.2 | 4.6

Note:Special ballscrew spindle end of 8 mm diameter is available, please contact hiwin if necessary.

# KK60 (Light Duty)

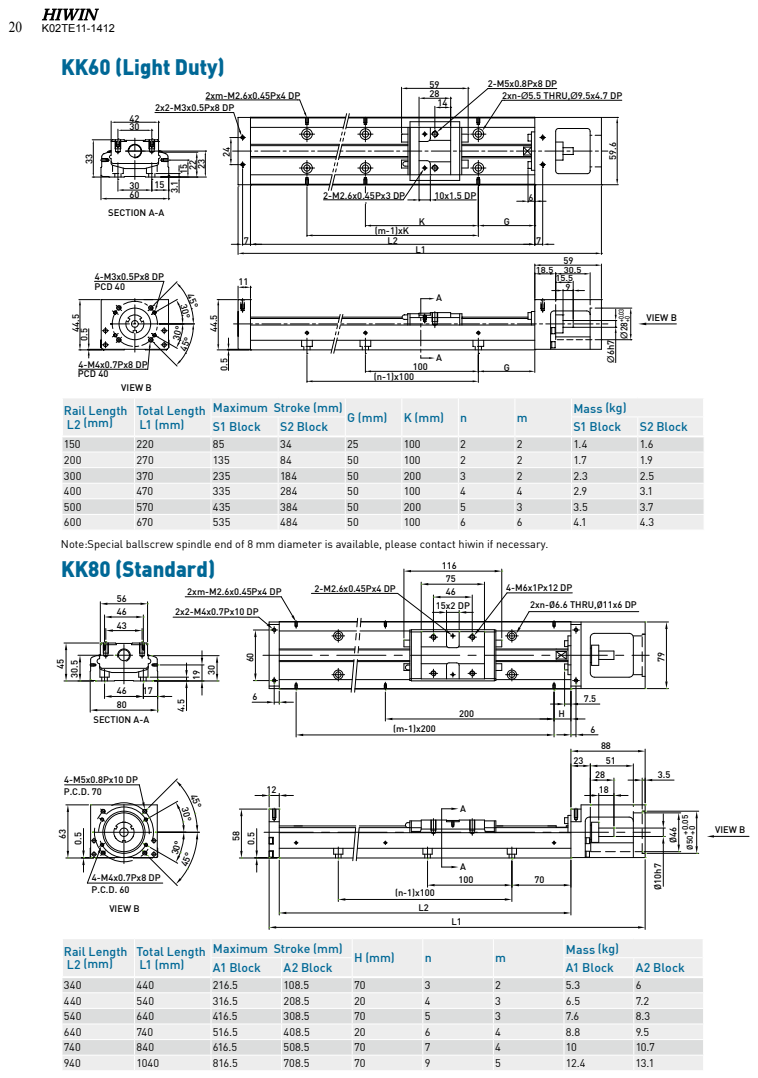
[picture p114: page 12]
SECTION A-A; VIEW B; PCD 40; 2xn-Ø5.5 THRU,Ø9.5x4.7 DP; 2xn-Ø6.6 THRU,Ø11x6 DP

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

S1 Block | S2 Block | | | | | S1 Block | S2 Block

150 | 220 | 85 | 34 | 25 | 100 | 2 | 2 | 1.4 | 1.6
200 | 270 | 135 | 84 | 50 | 100 | 2 | 2 | 1.7 | 1.9
300 | 370 | 235 | 184 | 50 | 200 | 3 | 2 | 2.3 | 2.5
400 | 470 | 335 | 284 | 50 | 100 | 4 | 4 | 2.9 | 3.1
500 | 570 | 435 | 384 | 50 | 200 | 5 | 3 | 3.5 | 3.7
600 | 670 | 535 | 484 | 50 | 100 | 6 | 6 | 4.1 | 4.3

Note:Special ballscrew spindle end of 8 mm diameter is available, please contact hiwin if necessary.
KK80 (Standard)

Rail Length L2 (mm) | Total Length L1 (mm) | Maximum Stroke (mm) | H (mm) | n | m | Mass (kg)

A1 Block | A2 Block | | | | A1 Block | A2 Block

340 | 440 | 216.5 | 108.5 | 70 | 3 | 2 | 5.3 | 6
440 | 540 | 316.5 | 208.5 | 20 | 4 | 3 | 6.5 | 7.2
540 | 640 | 416.5 | 308.5 | 70 | 5 | 3 | 7.6 | 8.3
640 | 740 | 516.5 | 408.5 | 20 | 6 | 4 | 8.8 | 9.5
740 | 840 | 616.5 | 508.5 | 70 | 7 | 4 | 10 | 10.7
940 | 1040 | 816.5 | 708.5 | 70 | 9 | 5 | 12.4 | 13.1

# KK80 (Light Duty)

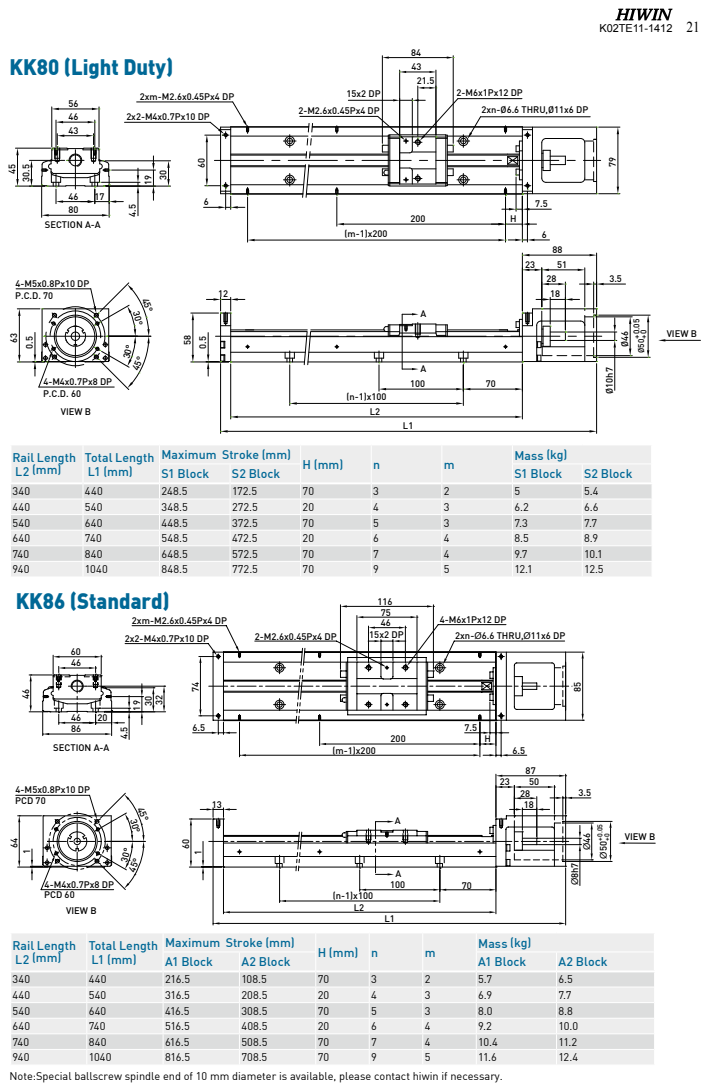
[picture p115: page 13]
VIEW B; 2xn-Ø6.6 THRU,Ø11x6 DP; SECTION A-A; KK86 (Standard); 4-M5x0.8Px10 DP PCD 70; 4-M4x0.7Px8 DP PCD 60

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

S1 Block | S2 Block | | | | S1 Block | S2 Block

340 | 440 | 248.5 | 172.5 | 70 | 3 | 2 | 5 | 5.4
440 | 540 | 348.5 | 272.5 | 20 | 4 | 3 | 6.2 | 6.6
540 | 640 | 448.5 | 372.5 | 70 | 5 | 3 | 7.3 | 7.7
640 | 740 | 548.5 | 472.5 | 20 | 6 | 4 | 8.5 | 8.9
740 | 840 | 648.5 | 572.5 | 70 | 7 | 4 | 9.7 | 10.1
940 | 1040 | 848.5 | 772.5 | 70 | 9 | 5 | 12.1 | 12.5

A1 Block | A2 Block | | | | A1 Block | A2 Block

340 | 440 | 216.5 | 108.5 | 70 | 3 | 2 | 5.7 | 6.5
440 | 540 | 316.5 | 208.5 | 20 | 4 | 3 | 6.9 | 7.7
540 | 640 | 416.5 | 308.5 | 70 | 5 | 3 | 8.0 | 8.8
640 | 740 | 516.5 | 408.5 | 20 | 6 | 4 | 9.2 | 10.0
740 | 840 | 616.5 | 508.5 | 70 | 7 | 4 | 10.4 | 11.2
940 | 1040 | 816.5 | 708.5 | 70 | 9 | 5 | 11.6 | 12.4

Note:Special ballscrew spindle end of 10 mm diameter is available, please contact hiwin if necessary.

# KK86 (Light Duty)

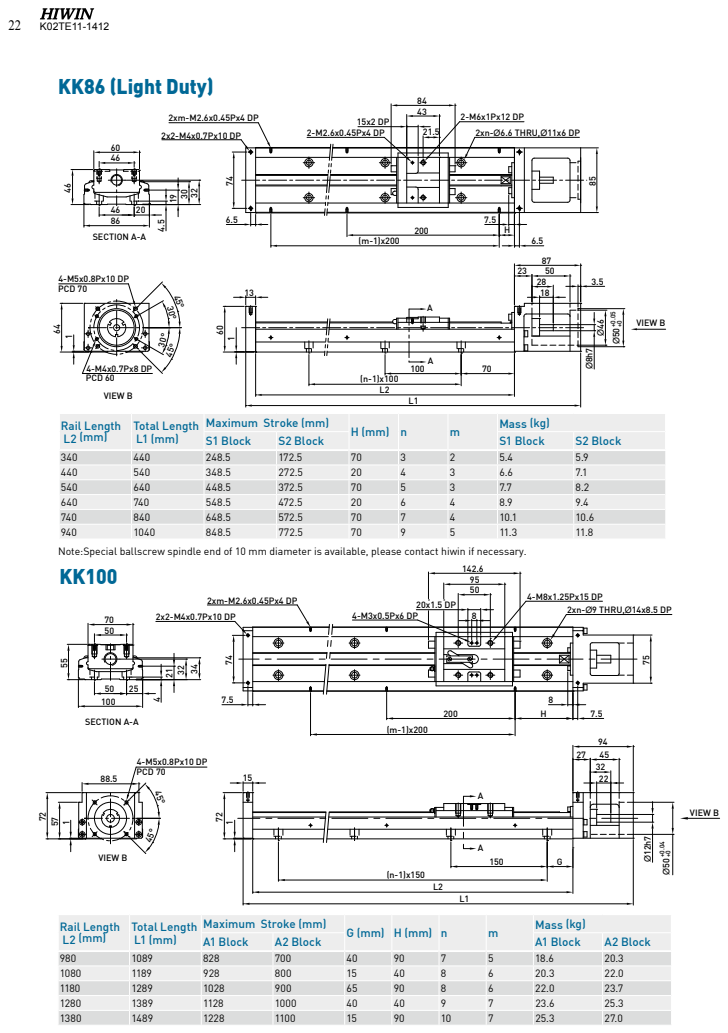
[picture p116: page 14]
2xn-Ø6.6 THRU,Ø11x6 DP; SECTION A-A; PCD 60; VIEW B; 4-M5x0.8Px10 DP PCD 70; 2xn-Ø9 THRU,Ø14x8.5 DP

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

S1 Block | S2 Block | | | | S1 Block | S2 Block

340 | 440 | 248.5 | 172.5 | 70 | 3 | 2 | 5.4 | 5.9
440 | 540 | 348.5 | 272.5 | 20 | 4 | 3 | 6.6 | 7.1
540 | 640 | 448.5 | 372.5 | 70 | 5 | 3 | 7.7 | 8.2
640 | 740 | 548.5 | 472.5 | 20 | 6 | 4 | 8.9 | 9.4
740 | 840 | 648.5 | 572.5 | 70 | 7 | 4 | 10.1 | 10.6
940 | 1040 | 848.5 | 772.5 | 70 | 9 | 5 | 11.3 | 11.8

Note:Special ballscrew spindle end of 10 mm diameter is available, please contact hiwin if necessary.

Rail Length L2 (mm) | Total Length L1 (mm) | Maximum Stroke (mm) | G (mm) | H (mm) | n | m | Mass (kg)

A1 Block | A2 Block | | | | | A1 Block | A2 Block

980 | 1089 | 828 | 700 | 40 | 90 | 7 | 5 | 18.6 | 20.3
1080 | 1189 | 928 | 800 | 15 | 40 | 8 | 6 | 20.3 | 22.0
1180 | 1289 | 1028 | 900 | 65 | 90 | 8 | 6 | 22.0 | 23.7
1280 | 1389 | 1128 | 1000 | 40 | 40 | 9 | 7 | 23.6 | 25.3
1380 | 1489 | 1228 | 1100 | 15 | 90 | 10 | 7 | 25.3 | 27.0

KK130

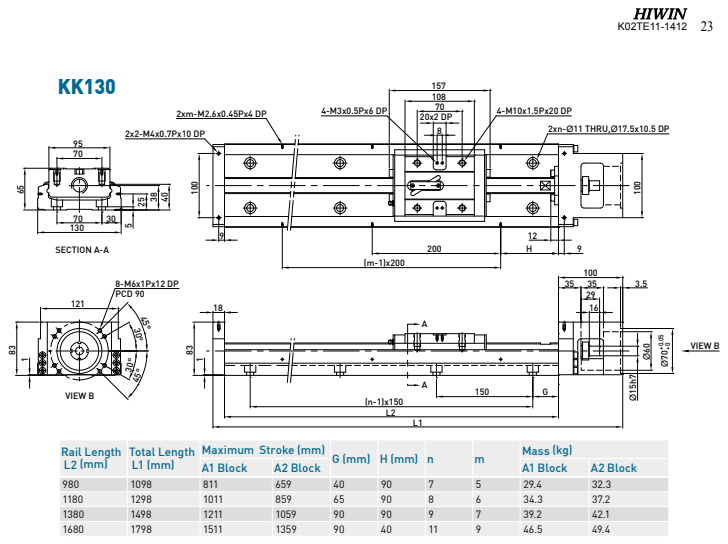
[picture p117: page 15]
2xn-Ø11 THRU,Ø17.5x10.5 DP; SECTION A-A; VIEW B; 8-M6x1Px12 DP PCD 90

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

A1 Block | A2 Block | | | | | A1 Block | A2 Block

980 | 1098 | 811 | 659 | 40 | 90 | 7 | 5 | 29.4 | 32.3
1180 | 1298 | 1011 | 859 | 65 | 90 | 8 | 6 | 34.3 | 37.2
1380 | 1498 | 1211 | 1059 | 90 | 90 | 9 | 7 | 39.2 | 42.1
1680 | 1798 | 1511 | 1359 | 90 | 40 | 11 | 9 | 46.5 | 49.4

# 1.9.2 With cover

KK30

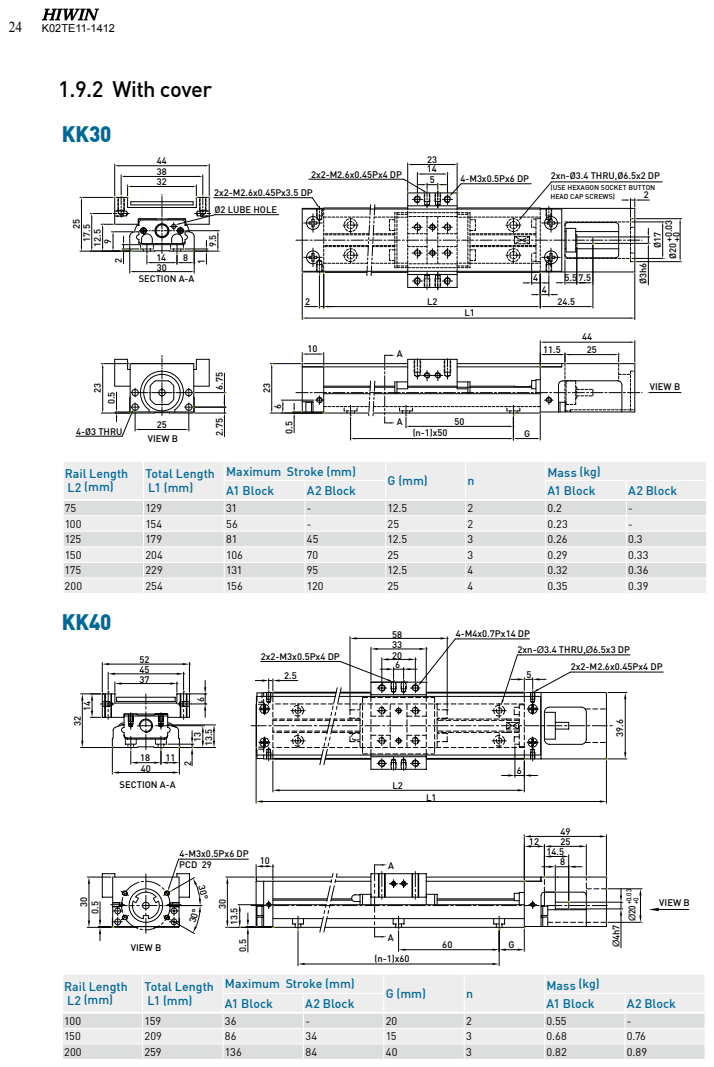
[picture p118: page 16]
SECTION A-A; VIEW B; Ø2 LUBE HOLE; 4-Ø3 THRU; 4-M3x0.5Px6 DP PCD 29; 2xn-Ø3.4 THRU,Ø6.5x3 DP

2xn-Ø3.4 THRU,Ø6.5x2 DP
(USE HEXAGON SOCKET BUTTON
HEAD CAP SCREWS)

Rail Length L2 (mm) | Total Length L1 (mm) | Maximum Stroke (mm) | G (mm) | n | Mass (kg)

A1 Block | A2 Block | | | A1 Block | A2 Block

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

100 | 159 | 36 | - | 20 | 2 | 0.55 | -
150 | 209 | 86 | 34 | 15 | 3 | 0.68 | 0.76
200 | 259 | 136 | 84 | 40 | 3 | 0.82 | 0.89

KK50

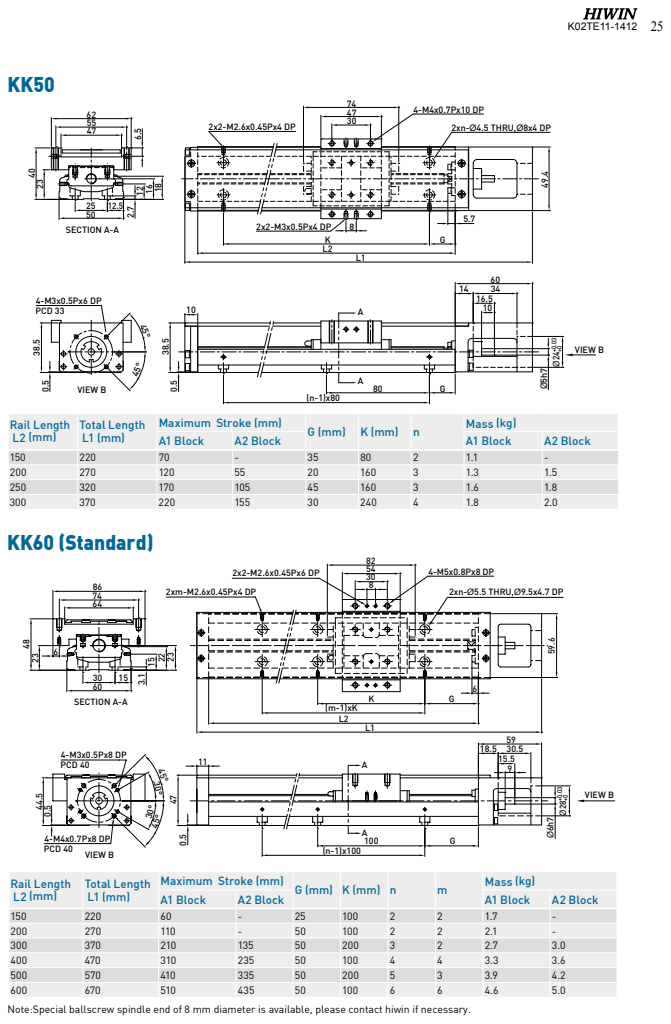
[picture p119: page 17]
SECTION A-A; VIEW B; 2xn-Ø4.5 THRU,Ø8x4 DP; 4-M3x0.5Px6 DP PCD 33; KK60 (Standard); 2xn-Ø5.5 THRU,Ø9.5x4.7 DP; 30 60 SECTION A-A; PCD 40

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

A1 Block | A2 Block | | | | A1 Block | A2 Block

150 | 220 | 70 | - | 35 | 80 | 2 | 1.1 | -
200 | 270 | 120 | 55 | 20 | 160 | 3 | 1.3 | 1.5
250 | 320 | 170 | 105 | 45 | 160 | 3 | 1.6 | 1.8
300 | 370 | 220 | 155 | 30 | 240 | 4 | 1.8 | 2.0

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

A1 Block | A2 Block | | | | | A1 Block | A2 Block

150 | 220 | 60 | - | 25 | 100 | 2 | 2 | 1.7 | -
200 | 270 | 110 | - | 50 | 100 | 2 | 2 | 2.1 | -
300 | 370 | 210 | 135 | 50 | 200 | 3 | 2 | 2.7 | 3.0
400 | 470 | 310 | 235 | 50 | 100 | 4 | 4 | 3.3 | 3.6
500 | 570 | 410 | 335 | 50 | 200 | 5 | 3 | 3.9 | 4.2
600 | 670 | 510 | 435 | 50 | 100 | 6 | 6 | 4.6 | 5.0

Note:Special ballscrew spindle end of 8 mm diameter is available, please contact hiwin if necessary.

# KK60 (Light Duty)

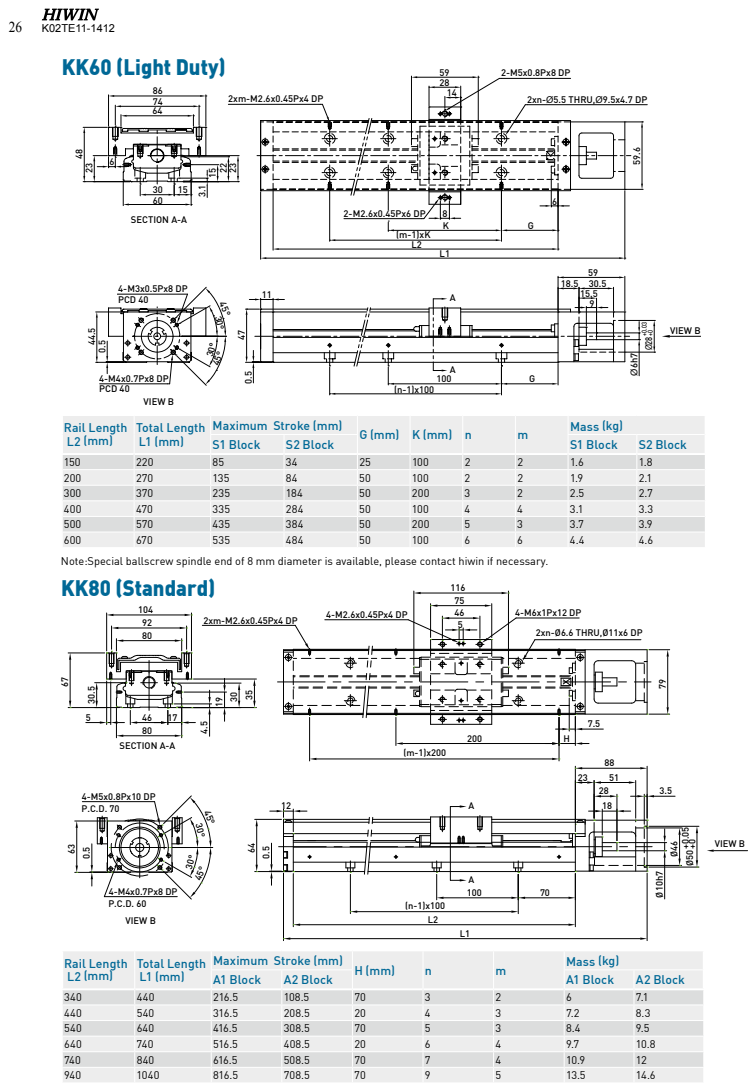
[picture p120: page 18]
VIEW B; PCD 40; SECTION A-A; 2xn-Ø5.5 THRU,Ø9.5x4.7 DP; 2xn-Ø6.6 THRU,Ø11x6 DP

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

S1 Block | S2 Block | | | | | S1 Block | S2 Block

150 | 220 | 85 | 34 | 25 | 100 | 2 | 2 | 1.6 | 1.8
200 | 270 | 135 | 84 | 50 | 100 | 2 | 2 | 1.9 | 2.1
300 | 370 | 235 | 184 | 50 | 200 | 3 | 2 | 2.5 | 2.7
400 | 470 | 335 | 284 | 50 | 100 | 4 | 4 | 3.1 | 3.3
500 | 570 | 435 | 384 | 50 | 200 | 5 | 3 | 3.7 | 3.9
600 | 670 | 535 | 484 | 50 | 100 | 6 | 6 | 4.4 | 4.6

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

A1 Block | A2 Block | | | | A1 Block | A2 Block

340 | 440 | 216.5 | 108.5 | 70 | 3 | 2 | 6 | 7.1
440 | 540 | 316.5 | 208.5 | 20 | 4 | 3 | 7.2 | 8.3
540 | 640 | 416.5 | 308.5 | 70 | 5 | 3 | 8.4 | 9.5
640 | 740 | 516.5 | 408.5 | 20 | 6 | 4 | 9.7 | 10.8
740 | 840 | 616.5 | 508.5 | 70 | 7 | 4 | 10.9 | 12
940 | 1040 | 816.5 | 708.5 | 70 | 9 | 5 | 13.5 | 14.6

# KK80 (Light Duty)

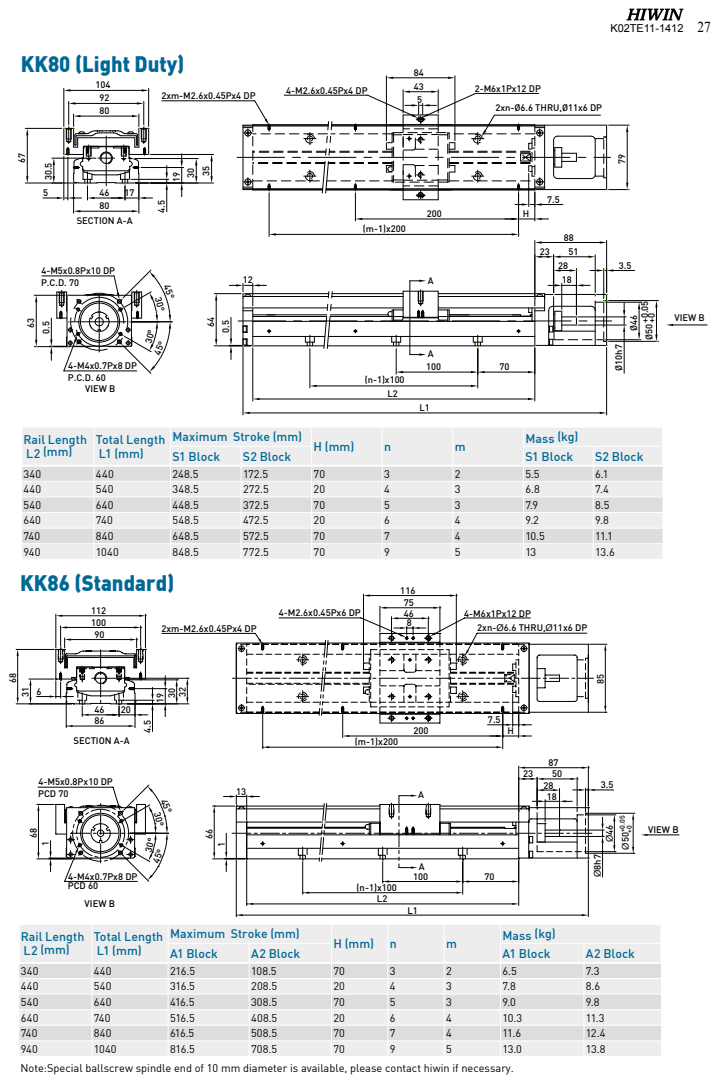
[picture p121: page 19]
VIEW B; SECTION A-A; 2xn-Ø6.6 THRU,Ø11x6 DP; KK86 (Standard); 4-M5x0.8Px10 DP PCD 70; 4-M4x0.7Px8 DP PCD 60

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

S1 Block | S2 Block | | | | S1 Block | S2 Block

340 | 440 | 248.5 | 172.5 | 70 | 3 | 2 | 5.5 | 6.1
440 | 540 | 348.5 | 272.5 | 20 | 4 | 3 | 6.8 | 7.4
540 | 640 | 448.5 | 372.5 | 70 | 5 | 3 | 7.9 | 8.5
640 | 740 | 548.5 | 472.5 | 20 | 6 | 4 | 9.2 | 9.8
740 | 840 | 648.5 | 572.5 | 70 | 7 | 4 | 10.5 | 11.1
940 | 1040 | 848.5 | 772.5 | 70 | 9 | 5 | 13 | 13.6

A1 Block | A2 Block | | | | A1 Block | A2 Block

340 | 440 | 216.5 | 108.5 | 70 | 3 | 2 | 6.5 | 7.3
440 | 540 | 316.5 | 208.5 | 20 | 4 | 3 | 7.8 | 8.6
540 | 640 | 416.5 | 308.5 | 70 | 5 | 3 | 9.0 | 9.8
640 | 740 | 516.5 | 408.5 | 20 | 6 | 4 | 10.3 | 11.3
740 | 840 | 616.5 | 508.5 | 70 | 7 | 4 | 11.6 | 12.4
940 | 1040 | 816.5 | 708.5 | 70 | 9 | 5 | 13.0 | 13.8

Note:Special ballscrew spindle end of 10 mm diameter is available, please contact hiwin if necessary.

# KK86 (Light Duty)

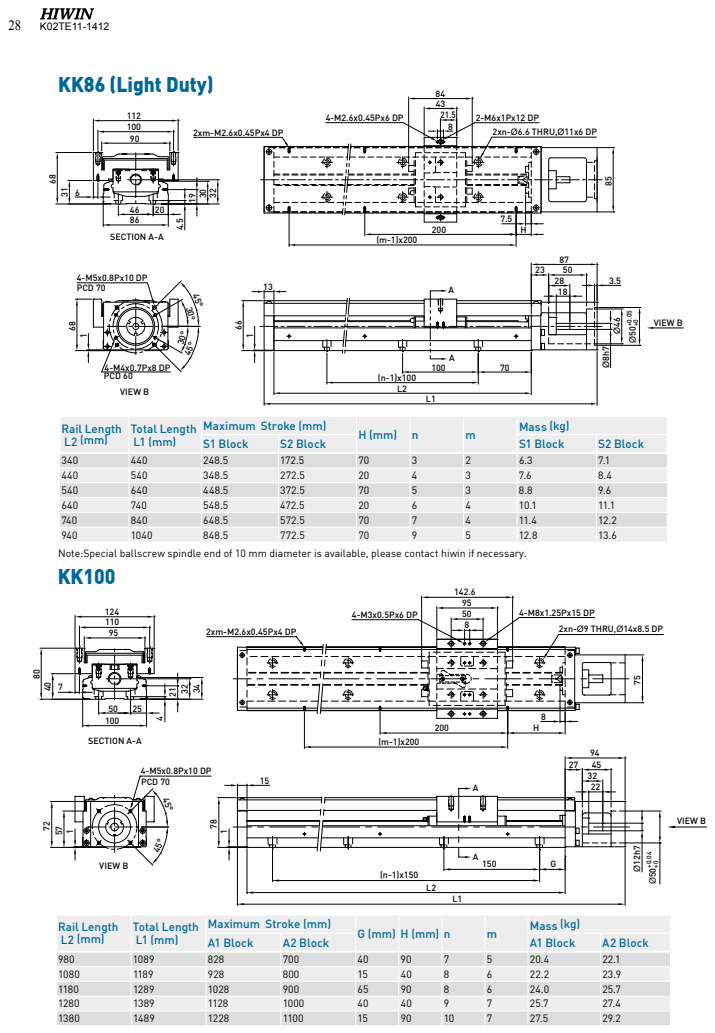
[picture p122: page 20]
2xn-Ø6.6 THRU,Ø11x6 DP; 4-M5x0.8Px10 DP PCD 70; VIEW B; 4-M4x0.7Px8 DP PCD 60; 86 SECTION A-A; SECTION A-A; 2xn-Ø9 THRU,Ø14x8.5 DP

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

S1 Block | S2 Block | | | | S1 Block | S2 Block

340 | 440 | 248.5 | 172.5 | 70 | 3 | 2 | 6.3 | 7.1
440 | 540 | 348.5 | 272.5 | 20 | 4 | 3 | 7.6 | 8.4
540 | 640 | 448.5 | 372.5 | 70 | 5 | 3 | 8.8 | 9.6
640 | 740 | 548.5 | 472.5 | 20 | 6 | 4 | 10.1 | 11.1
740 | 840 | 648.5 | 572.5 | 70 | 7 | 4 | 11.4 | 12.2
940 | 1040 | 848.5 | 772.5 | 70 | 9 | 5 | 12.8 | 13.6

Note:Special ballscrew spindle end of 10 mm diameter is available, please contact hiwin if necessary.

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

A1 Block | A2 Block | | | | | A1 Block | A2 Block

980 | 1089 | 828 | 700 | 40 | 90 | 7 | 5 | 20.4 | 22.1
1080 | 1189 | 928 | 800 | 15 | 40 | 8 | 6 | 22.2 | 23.9
1180 | 1289 | 1028 | 900 | 65 | 90 | 8 | 6 | 24.0 | 25.7
1280 | 1389 | 1128 | 1000 | 40 | 40 | 9 | 7 | 25.7 | 27.4
1380 | 1489 | 1228 | 1100 | 15 | 90 | 10 | 7 | 27.5 | 29.2

KK130

# PCD 90²⁵

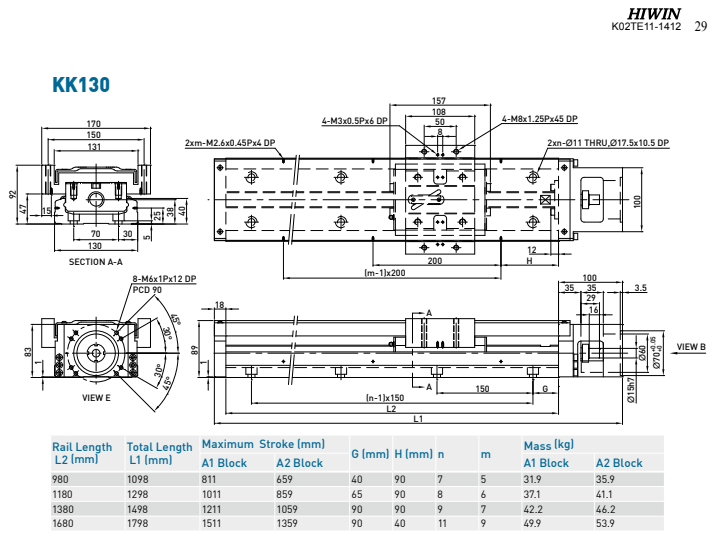
[picture p123: page 21]
SECTION A-A; VIEW E; 2xn-Ø11 THRU,Ø17.5x10.5 DP; VIEW B

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

A1 Block | A2 Block | | | | | A1 Block | A2 Block

980 | 1098 | 811 | 659 | 40 | 90 | 7 | 5 | 31.9 | 35.9
1180 | 1298 | 1011 | 859 | 65 | 90 | 8 | 6 | 37.1 | 41.1
1380 | 1498 | 1211 | 1059 | 90 | 90 | 9 | 7 | 42.2 | 46.2
1680 | 1798 | 1511 | 1359 | 90 | 40 | 11 | 9 | 49.9 | 53.9

## Panasonic Servo Motor

# 1.10 Motor Housing and Motor Adaptor Flange

## Mitsubishi Servo Motor

## Yasukawa Servo Motor

## HIWIN Mikrosystem Servo Motor

# 1.10.1 Motor Selection

Motor Output | Motor | Weight (kg) | Flange Selection | +Brake Weight (kg) | Drive | Weight (kg) | Remarks
KK30 | KK40 | KK50 | KK60 | KK80 | KK86 | KK100 | KK130
100W | FRAC101022 | 0.6 | - | F2 | F2 | F2 | F3 | F3 | - | - | - | MD-36-S | 1.25 | 220V
200W | FRAC102022 | 1 | - | - | - | - | F0 | F0 | F0 | F1 | - | | | 220V
400W | FRAC104022 | 1.45 | - | - | - | - | F0 | F0 | F0 | F1 | - | | | 220V
750W | FRAC107522 | 2.66 | - | - | - | - | - | - | F1 | F2 | - | | | 220V
Motor Output | Motor | Weight (kg) | Flange Selection | +Brake Weight (kg) | Drive | Weight (kg) | Remarks
KK30 | KK40 | KK50 | KK60 | KK80 | KK86 | KK100 | KK130
10W | HC-AQ0135D | 0.19 | F1 | - | - | - | - | - | - | - | 0.29 | M2-JR-03A5 | 0.2
20W | HC-AQ0235D 0.22 | F1 | - | - | - | - | - | - | - | 0.32 | M2-JR-03A5 | 0.2
50W | HF-KP053 | 0.35 | - | F1 | F1 | F1 | F2 | F2 | - | - | 0.75 | MR-J3S-10A | 0.8 | 220V
100W | HF-KP13 | 0.56 | - | F1 | F1 | F1 | F2 | F2 | - | - | 0.89 | MR-J3S-10A | 0.8 | 220V
200W | HF-KP23 | 0.94 | - | - | - | - | F0 | F0 | F0 | F1 | 1.6 | MR-J3S-20A | 0.8 | 220V
400W | HF-KP43 | 1.5 | - | - | - | - | F0 | F0 | F0 | F1 | 2.1 | MR-J3S-40A | 1 | 220V
750W | HF-KP73 | 2.9 | - | - | - | - | - | - | F1 | F2 | 4 | MR-J3S-70A | 1.4 | 220V
Motor Output | Motor | Weight (kg) | Flange Selection | +Brake Weight (kg) | Drive | Weight (kg) | Remarks
KK30 | KK40 | KK50 | KK60 | KK80 | KK86 | KK100 | KK130
50W | MSMD5AZP1 0.32 | | - | F2 | F2 | F2 | F3 | F3 | - | - | 0.53 | MADDT1105 | 0.8 | 110V
50W | MSMD5AZP1 0.32 | | - | F2 | F2 | F2 | F3 | F3 | - | - | 0.53 | MADDT1205 | 0.8 | 220V
100W | MSMD011P1 | 0.47 | - | F2 | F2 | F2 | F3 | F3 | - | - | 0.68 | MADDT1107 | 0.8 | 110V
100W | MSMD012P1 | 0.47 | - | F2 | F2 | F2 | F3 | F3 | - | - | 0.68 | MADDT1205 | 0.8 | 220V
200W | MSMD021P1 | 0.82 | - | - | - | - | F1 | F1 | - | - | 1.3 | MADDT2110 | 1.1 | 110V
200W | MSMD022P1 | 0.82 | - | - | - | - | F1 | F1 | - | - | 1.3 | MADDT1207 | 0.8 | 220V
400W | MSMD041P1 | 1.2 | - | - | - | - | F1 | F1 | - | - | 1.7 | MADDT3120 | 1.5 | 110V
400W | MSMD042P1 | 1.2 | - | - | - | - | F1 | F1 | - | - | 1.7 | MADDT2210 | 1.1 | 220V
750W | MSMD082S1 | 2.3 | - | - | - | - | F4 | F4 | F2 | F4 | 3.1 | MADDT3520 | 1.5 | 220V
Motor Output | Motor | Weight (kg) | Flange Selection | +Brake Weight (kg) | Drive | Weight (kg) | Remarks
KK30 | KK40 | KK50 | KK60 | KK80 | KK86 | KK100 | KK130
10W | SGMMV-A1A2A21 | 0.13 | F2 | - | - | - | - | - | - | - | 0.215 | SGDV-R90A01A | 0.9 | 220V
20W | SGMMV-A2A2A21 0.17 | | F2 | - | - | - | - | - | - | - | 0.27 | SGDV-R90A01A | 0.9 | 220V
50W | SGMAV-A5ADA61 | 0.3 | - | F1 | F1 | F1 | F2 | F2 | - | - | | SGDV-R70A01A | 0.9 | with key
50W | SGMAV-A5ADA2C | 0.3 | - | F1 | F1 | F1 | F2 | F2 | - | - | | SGDV-R70A01A | 0.9 | no key
50W | SGMAV-A5ADA21 | 0.3 | - | F1 | F1 | F1 | F2 | F2 | - | - | 0.75 | SGDV-R70A01A | 0.9 | Mid inertia
100W | SGMAV-01ADA64 | 0.4 | - | F1 | F1 | F1 | F2 | F2 | - | - | 0.89 | SGDV-R90A01A | 0.9
200W | SGMAV-02ADA65 | 0.9 | - | - | - | - | F0 | F0 | F0 | F1 | 1.6 | SGDV-1R6A01A | 0.9
400W | SGMAV-04ADA66 | 1.2 | - | - | - | - | F0 | F0 | F0 | F1 | 2.1 | SGDV-2R8A01A | 1
750W | SGMAV-08ADA67 | 2.6 | - | - | - | - | | | F1 | F2 | 4 | SGDV-5R5A01A | 1.5

## HIWIN Mikosystem Step Motor

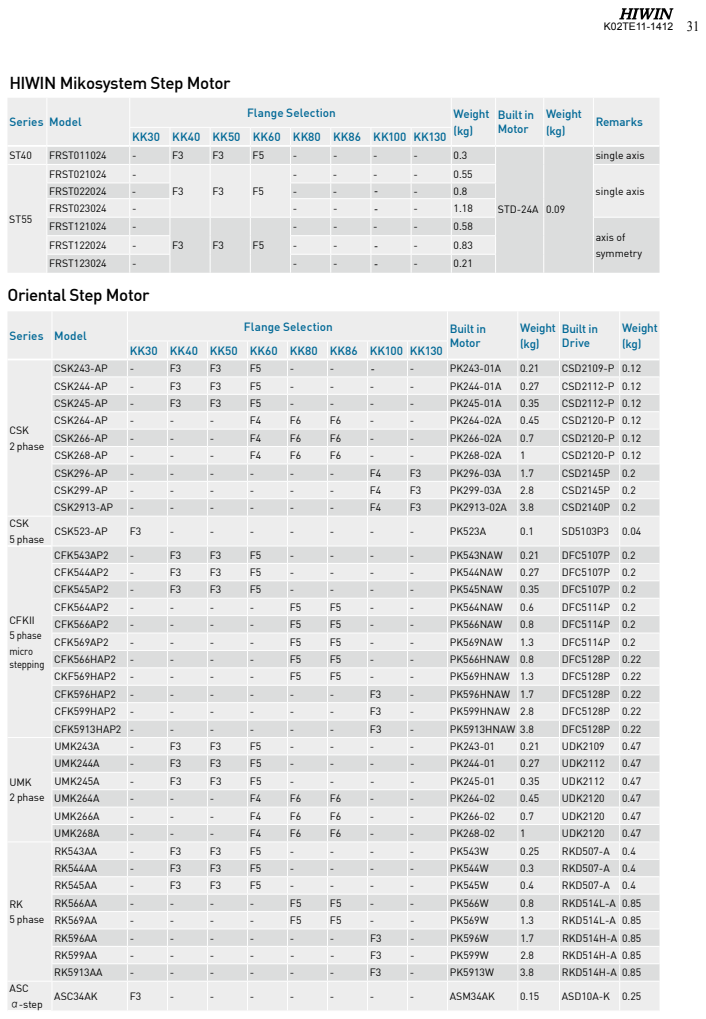
[picture p124: page 23]
Series; Model; Flange Selection; Built in; Motor; Weight (kg); Built in Drive; Weight; CSK 2 phase; CSK243-AP; CSD2109-P; CSK244-AP; CSD2112-P; CSK245-AP; CSK264-AP; CSD2120-P; CSK266-AP; CSK268-AP; CSK296-AP; CSD2145P; CSK299-AP; CSK2913-AP; CSD2140P; CSK; 5 phase; CSK523-AP; CFKII 5 phase micro stepping; CFK543AP2; PK543NAW; DFC5107P; CFK544AP2; PK544NAW; CFK545AP2; PK545NAW; CFK564AP2; PK564NAW; DFC5114P; CFK566AP2; PK566NAW; CFK569AP2; PK569NAW; CFK566HAP2; PK566HNAW; DFC5128P; CKF569HAP2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

Series | Model | Flange Selection | Weight (kg) | Built in Motor | Weight (kg) | Remarks

ST40 | FRST011024 | - | F3 | F3 | F5 | - | - | - | - | 0.3 | STD-24A | 0.09 | single axis
ST55 | FRST021024 | - | F3 | F3 | F5 | - | - | - | - | 0.55 | | | single axis

FRST022024 | - | | | | - | - | - | - | 0.8
FRST023024 | - | | | | - | - | - | - | 1.18
FRST121024 | - | F3 | F3 | F5 | - | - | - | - | 0.58 | | | axis of symmetry
FRST122024 | - | | | | - | - | - | - | 0.83
FRST123024 | - | | | | - | - | - | - | 0.21

Oriental Step Motor

# 1.10.2 Motor Housing and Motor Adaptor Flange

KK30

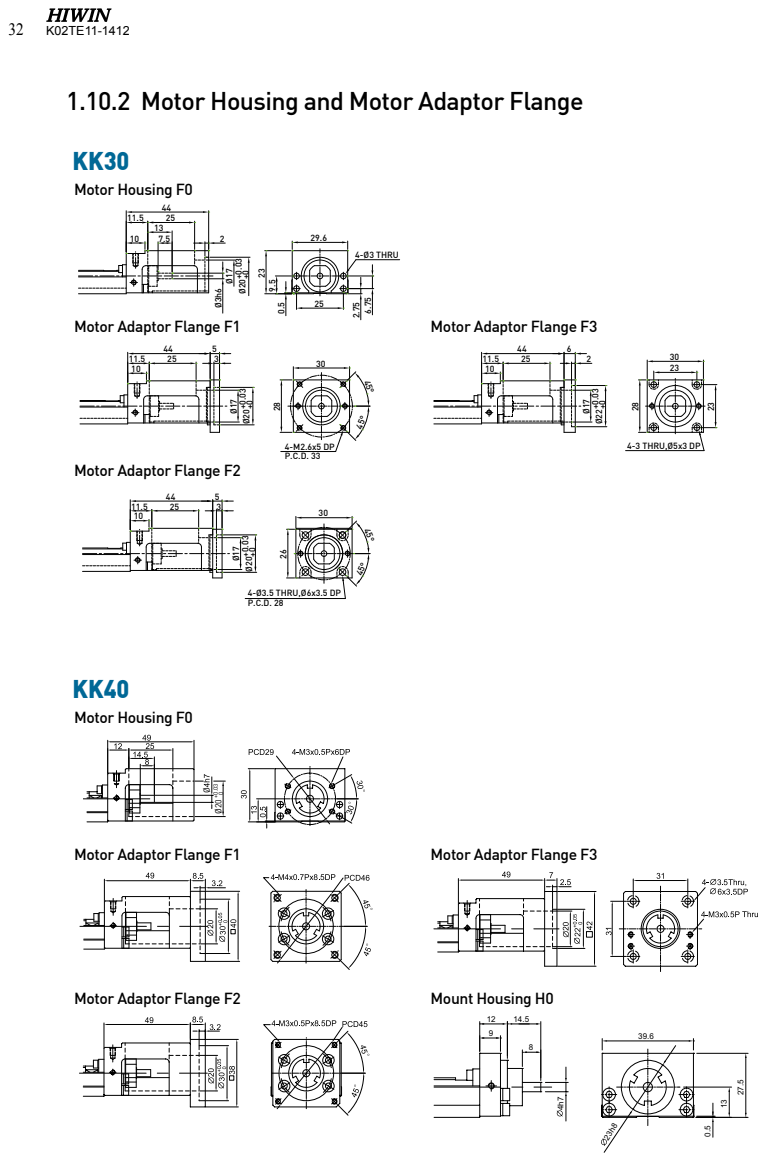
[picture p125: page 24]
4-Ø3 THRU; 4-3 THRU,Ø5x3 DP; 4-Ø3.5 THRU,Ø6x3.5 DP P.C.D. 28; Motor Housing F0; Motor Adaptor Flange F2; Mount Housing H0; Motor Adaptor Flange F1; Motor Adaptor Flange F3

Motor Adaptor Flange F2

KK50

### Motor Housing F0

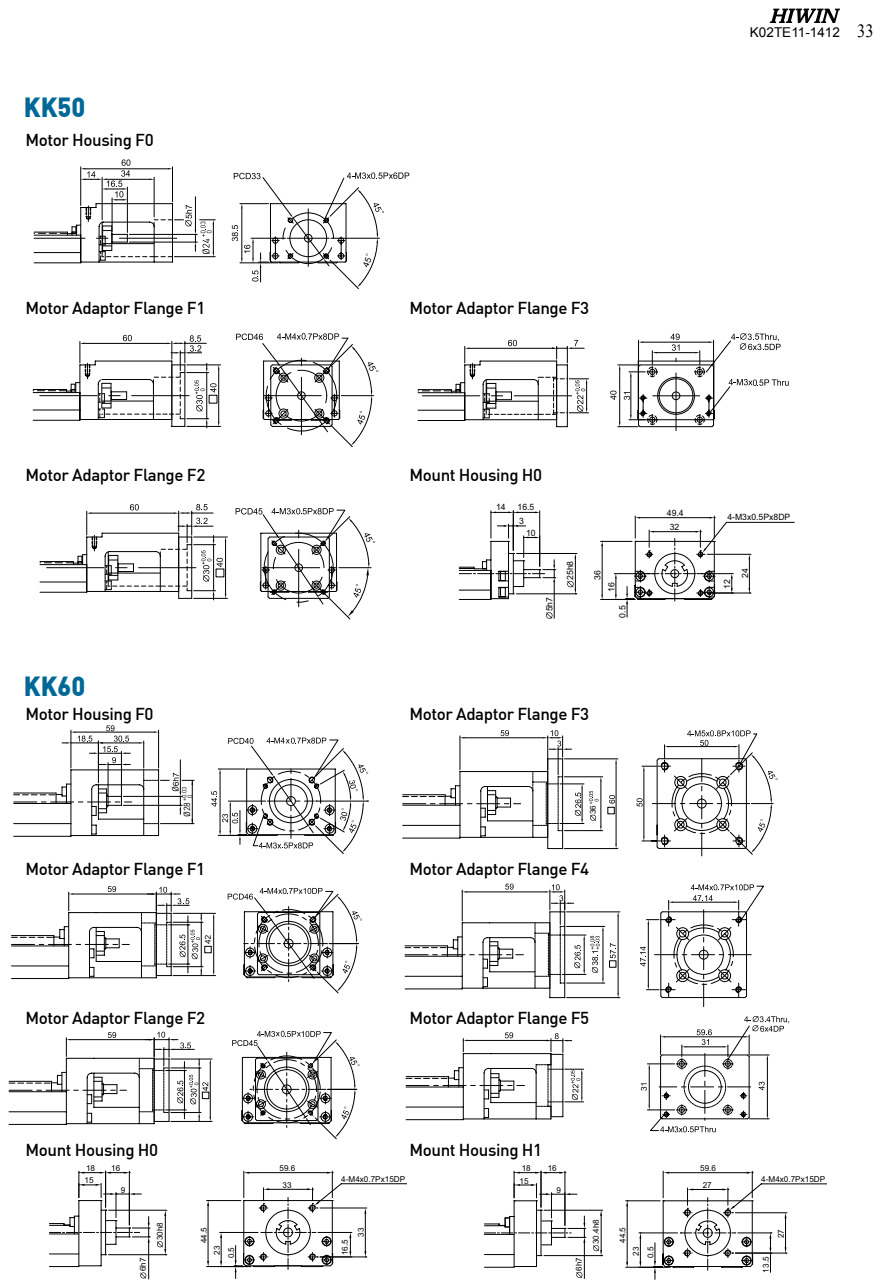
[picture p126: page 25]
Motor Adaptor Flange F2; Mount Housing H0; Motor Adaptor Flange F1; Motor Adaptor Flange F3 Ø²⁸⁺⁰.03; Motor Housing F0; Motor Adaptor Flange F3; Motor Adaptor Flange F5; Mount Housing H1; Motor Adaptor Flange F4

KK80

### Motor Housing F0

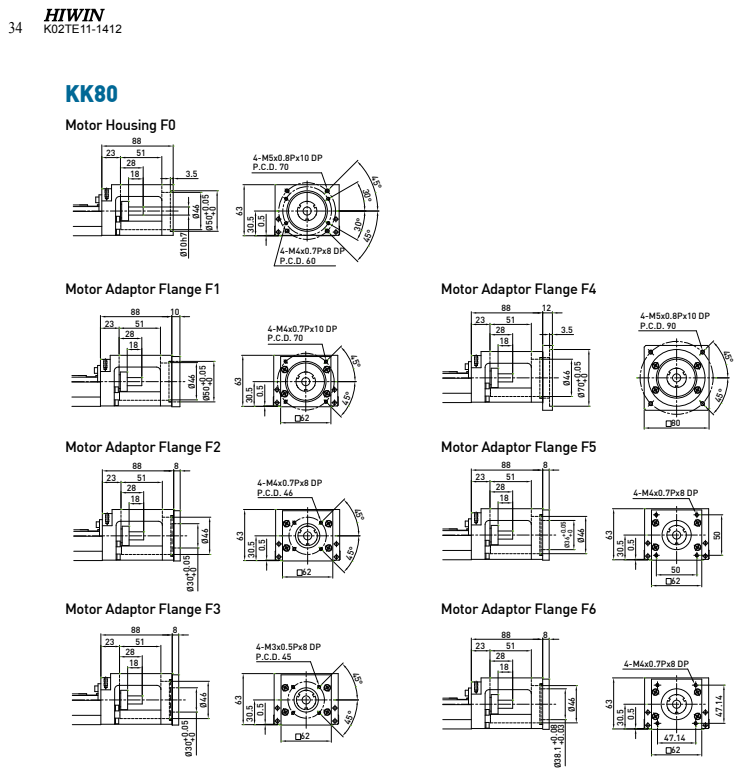
[picture p127: page 26]
3.5Ø⁴⁶; Motor Adaptor Flange F1; Motor Adaptor Flange F4; Motor Adaptor Flange F2; Motor Adaptor Flange F5; Motor Adaptor Flange F3; Motor Adaptor Flange F6

KK86

Motor Housing F0 | Motor Adaptor Flange F4

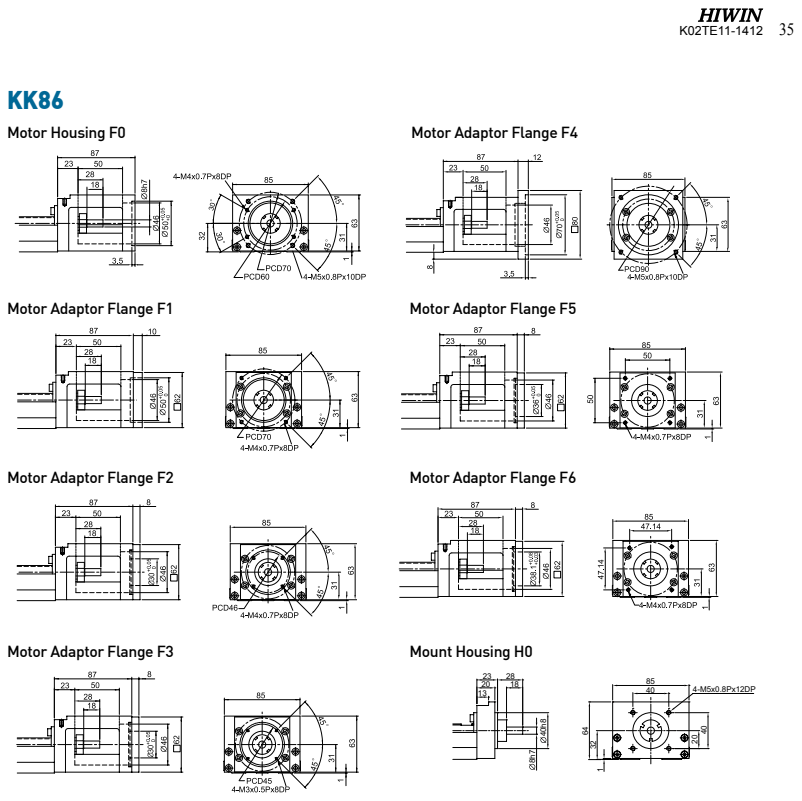
[picture p128: page 27]
Motor Adaptor Flange F1; Motor Adaptor Flange F5; Motor Adaptor Flange F2; Motor Adaptor Flange F6; Motor Adaptor Flange F3; Mount Housing H0

KK100

Motor Housing F0 | Motor Adaptor Flange F3

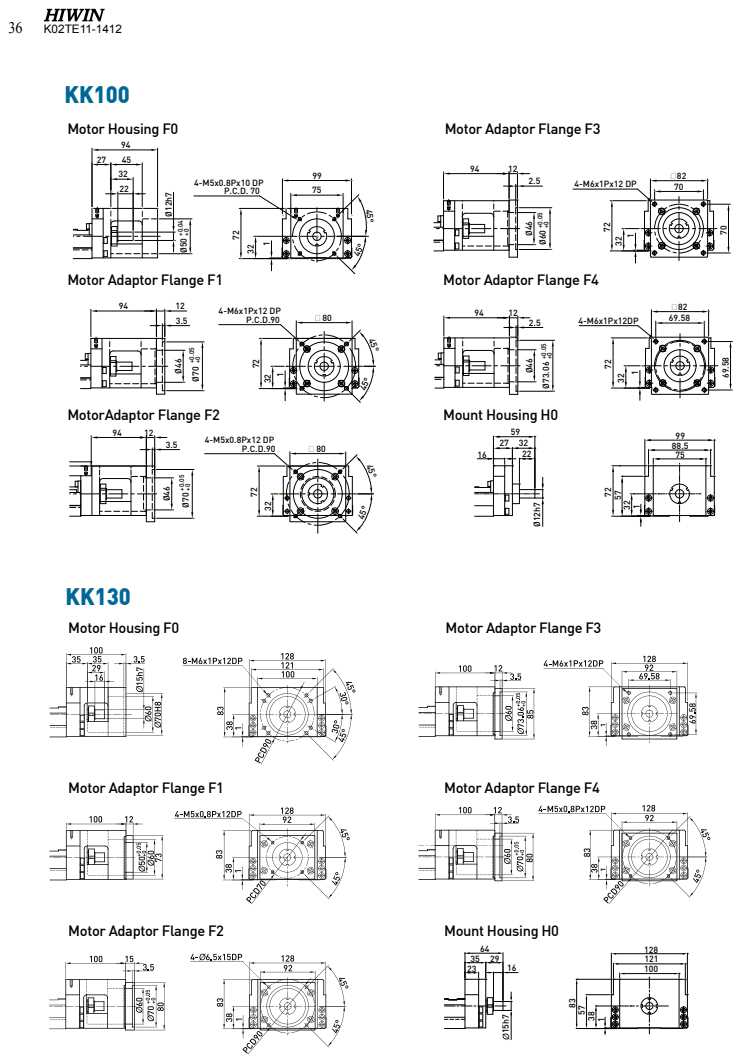
[picture p129: page 28]
2.5Ø⁴⁶; Motor Adaptor Flange F1; Motor Adaptor Flange F4; MotorAdaptor Flange F2; Mount Housing H0; Motor Housing F0; Motor Adaptor Flange F3; Motor Adaptor Flange F2

# 1.11 Optional Accessories

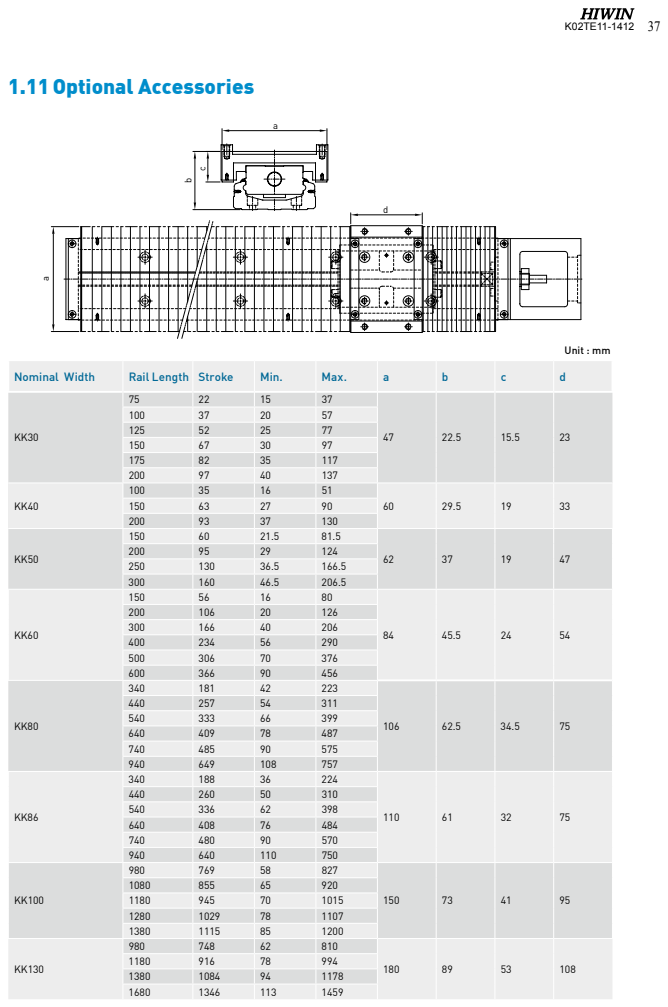
[picture p130: page 29]
Unit : mm

Nominal Width | Rail Length | Stroke | Min. | Max. | a | b | c | d

100 | 37 | 20 | 57
125 | 52 | 25 | 77
150 | 67 | 30 | 97
175 | 82 | 35 | 117
200 | 97 | 40 | 137
100 | 35 | 16 | 51 | 60 | 29.5 | 19 | 33
150 | 63 | 27 | 90
200 | 93 | 37 | 130

200 | 95 | 29 | 124
250 | 130 | 36.5 | 166.5
300 | 160 | 46.5 | 206.5

200 | 106 | 20 | 126
300 | 166 | 40 | 206
400 | 234 | 56 | 290
500 | 306 | 70 | 376
600 | 366 | 90 | 456

440 | 257 | 54 | 311
540 | 333 | 66 | 399
640 | 409 | 78 | 487
740 | 485 | 90 | 575
940 | 649 | 108 | 757

440 | 260 | 50 | 310
540 | 336 | 62 | 398
640 | 408 | 76 | 484
740 | 480 | 90 | 570
940 | 640 | 110 | 750

1080 | 855 | 65 | 920
1180 | 945 | 70 | 1015
1280 | 1029 | 78 | 1107
1380 | 1115 | 85 | 1200

1180 | 916 | 78 | 994
1380 | 1084 | 94 | 1178
1680 | 1346 | 113 | 1459

# 1.12 Switch

## Switch rail

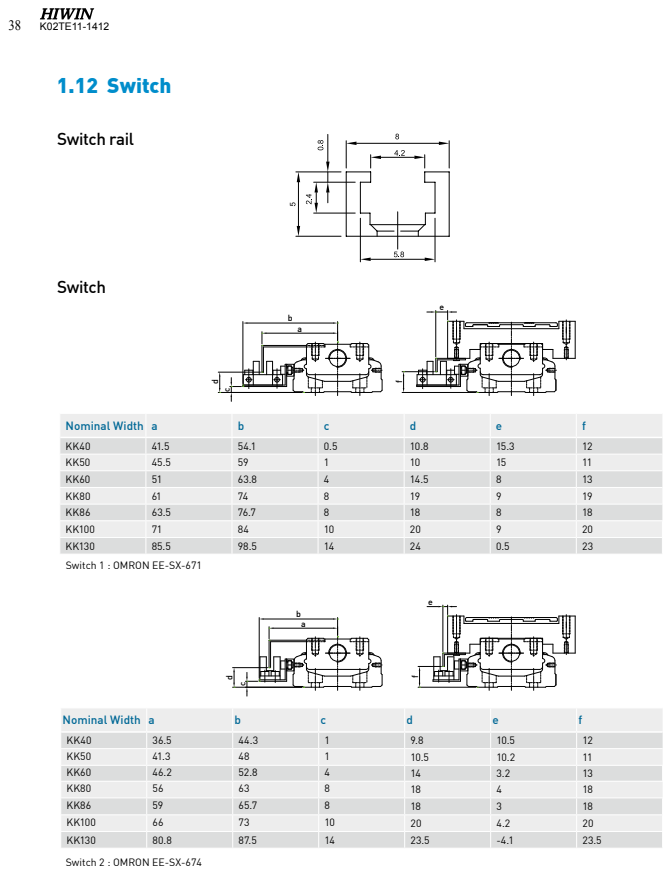
[picture p131: page 30]
Switch

Nominal Width | a | b | c | d | e | f
KK40 | 41.5 | 54.1 | 0.5 | 10.8 | 15.3 | 12
KK50 | 45.5 | 59 | 1 | 10 | 15 | 11
KK60 | 51 | 63.8 | 4 | 14.5 | 8 | 13
KK80 | 61 | 74 | 8 | 19 | 9 | 19
KK86 | 63.5 | 76.7 | 8 | 18 | 8 | 18
KK100 | 71 | 84 | 10 | 20 | 9 | 20
KK130 | 85.5 | 98.5 | 14 | 24 | 0.5 | 23

Switch 1 : OMRON EE-SX-671

KK40 | 36.5 | 44.3 | 1 | 9.8 | 10.5 | 12
KK50 | 41.3 | 48 | 1 | 10.5 | 10.2 | 11
KK60 | 46.2 | 52.8 | 4 | 14 | 3.2 | 13
KK80 | 56 | 63 | 8 | 18 | 4 | 18
KK86 | 59 | 65.7 | 8 | 18 | 3 | 18
KK100 | 66 | 73 | 10 | 20 | 4.2 | 20
KK130 | 80.8 | 87.5 | 14 | 23.5 | -4.1 | 23.5

Switch 2 : OMRON EE-SX-674

S3 & S4

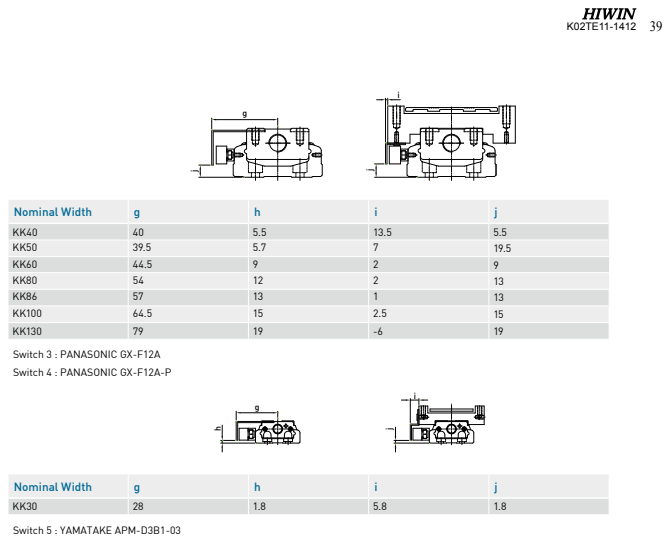
[picture p132: page 31]

N o m i n a l W i d t h | g | h | i | j
K K 4 0 | 4 0 | 5 . 5 | 1 3 . 5 | 5 . 5
K K 5 0 | 3 9 . 5 | 5 . 7 | 7 | 1 9 . 5
K K 6 0 | 4 4 . 5 | 9 | 2 | 9
K K 8 0 | 5 4 | 1 2 | 2 | 1 3
K K 8 6 | 5 7 | 1 3 | 1 | 1 3
K K 1 0 0 | 6 4 . 5 | 1 5 | 2 . 5 | 1 5
K K 1 3 0 | 7 9 | 1 9 | -6 | 1 9

K K 3 0 | 2 8 | 1 . 8 | 5 . 8 | 1 . 8
