ASamarkRoth/ScanningSystem/figs_and_draws/Positioning system/FullTable-V0.pdf

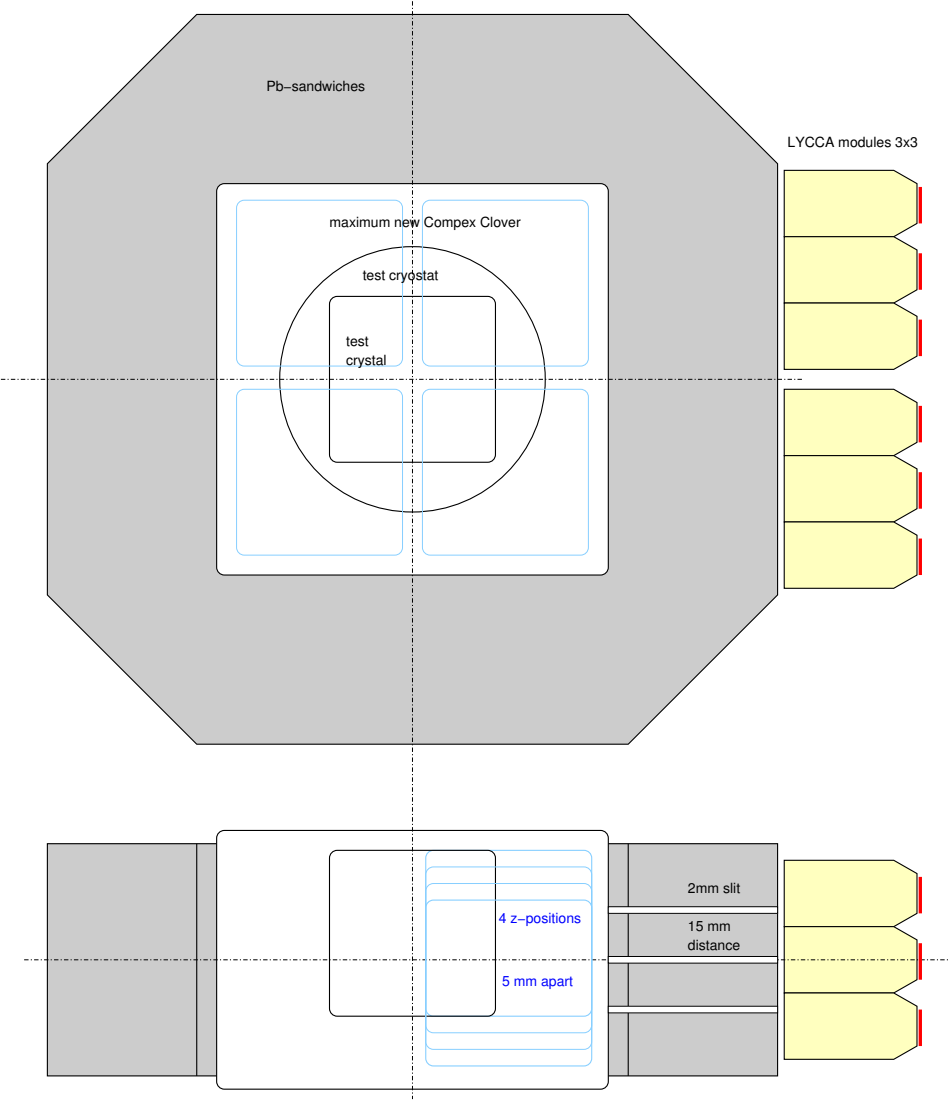
[picture p133: page 1]
test crystal; test cryostat; Pb−sandwiches; 4 z−positions; 5 mm apart; 2mm slit; 15 mm distance; LYCCA modules 3x3

maximum new Compex Clover
