ASamarkRoth/ScanningSystem/figs_and_draws/Ritningar LYCCA-mount scanner/AbsAluBase-V1.0.pdf

# Absorber LYCCA−Holder Al−Base V1.0

# Material: Aluminum

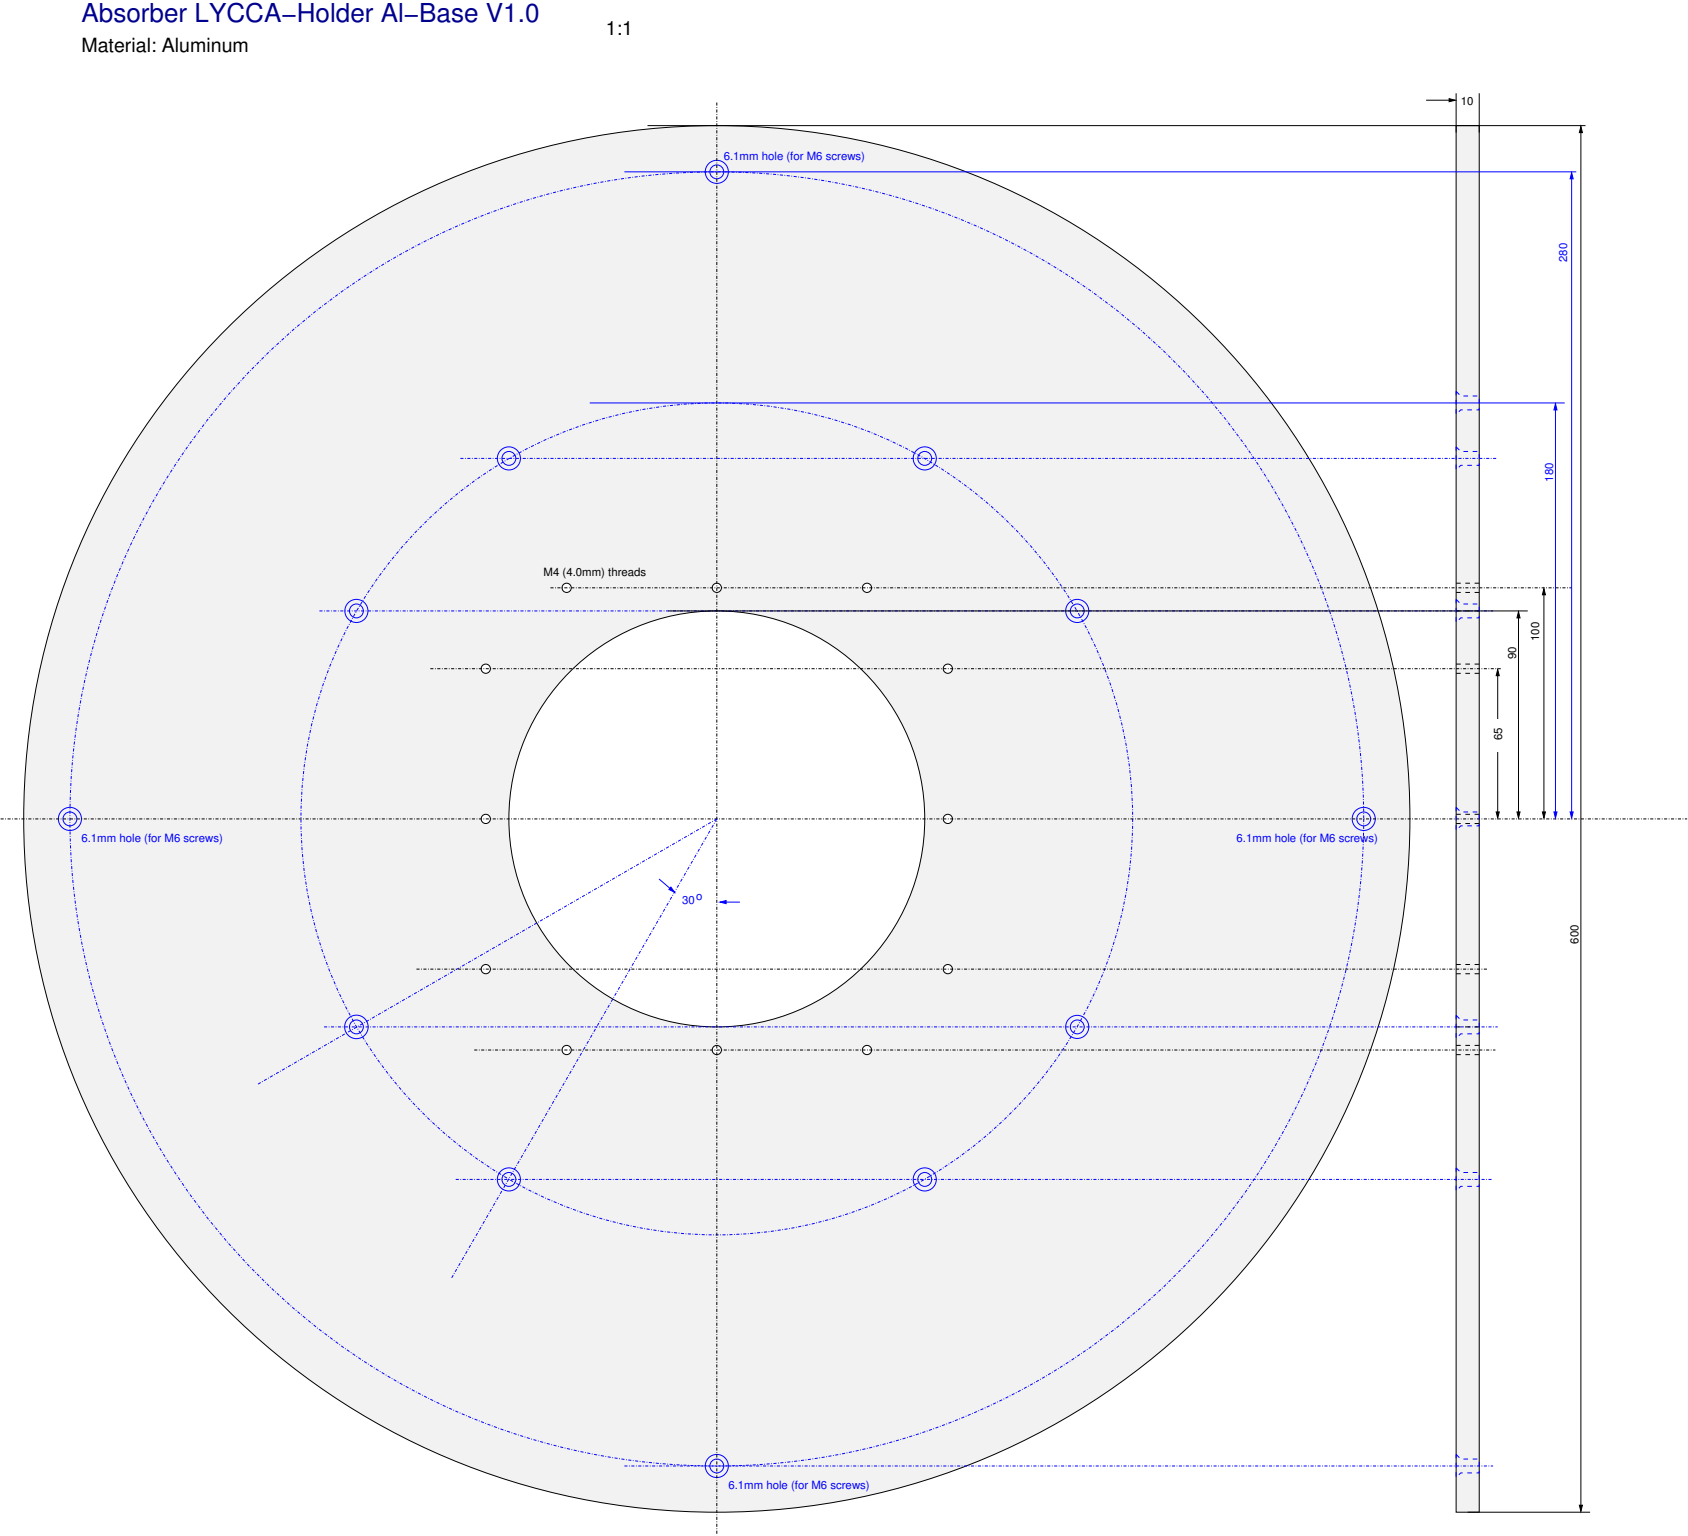
[picture p134: page 1]
M4 (4.0mm) threads

6.1mm hole (for M6 screws)
