ASamarkRoth/ScanningSystem/figs_and_draws/Ritningar LYCCA-mount scanner/AbsPlastBottom-V1.0.pdf

# Material: Hard plastic / plexiglas

# Absorber LYCCA−Holder Plastic−Base V1.0

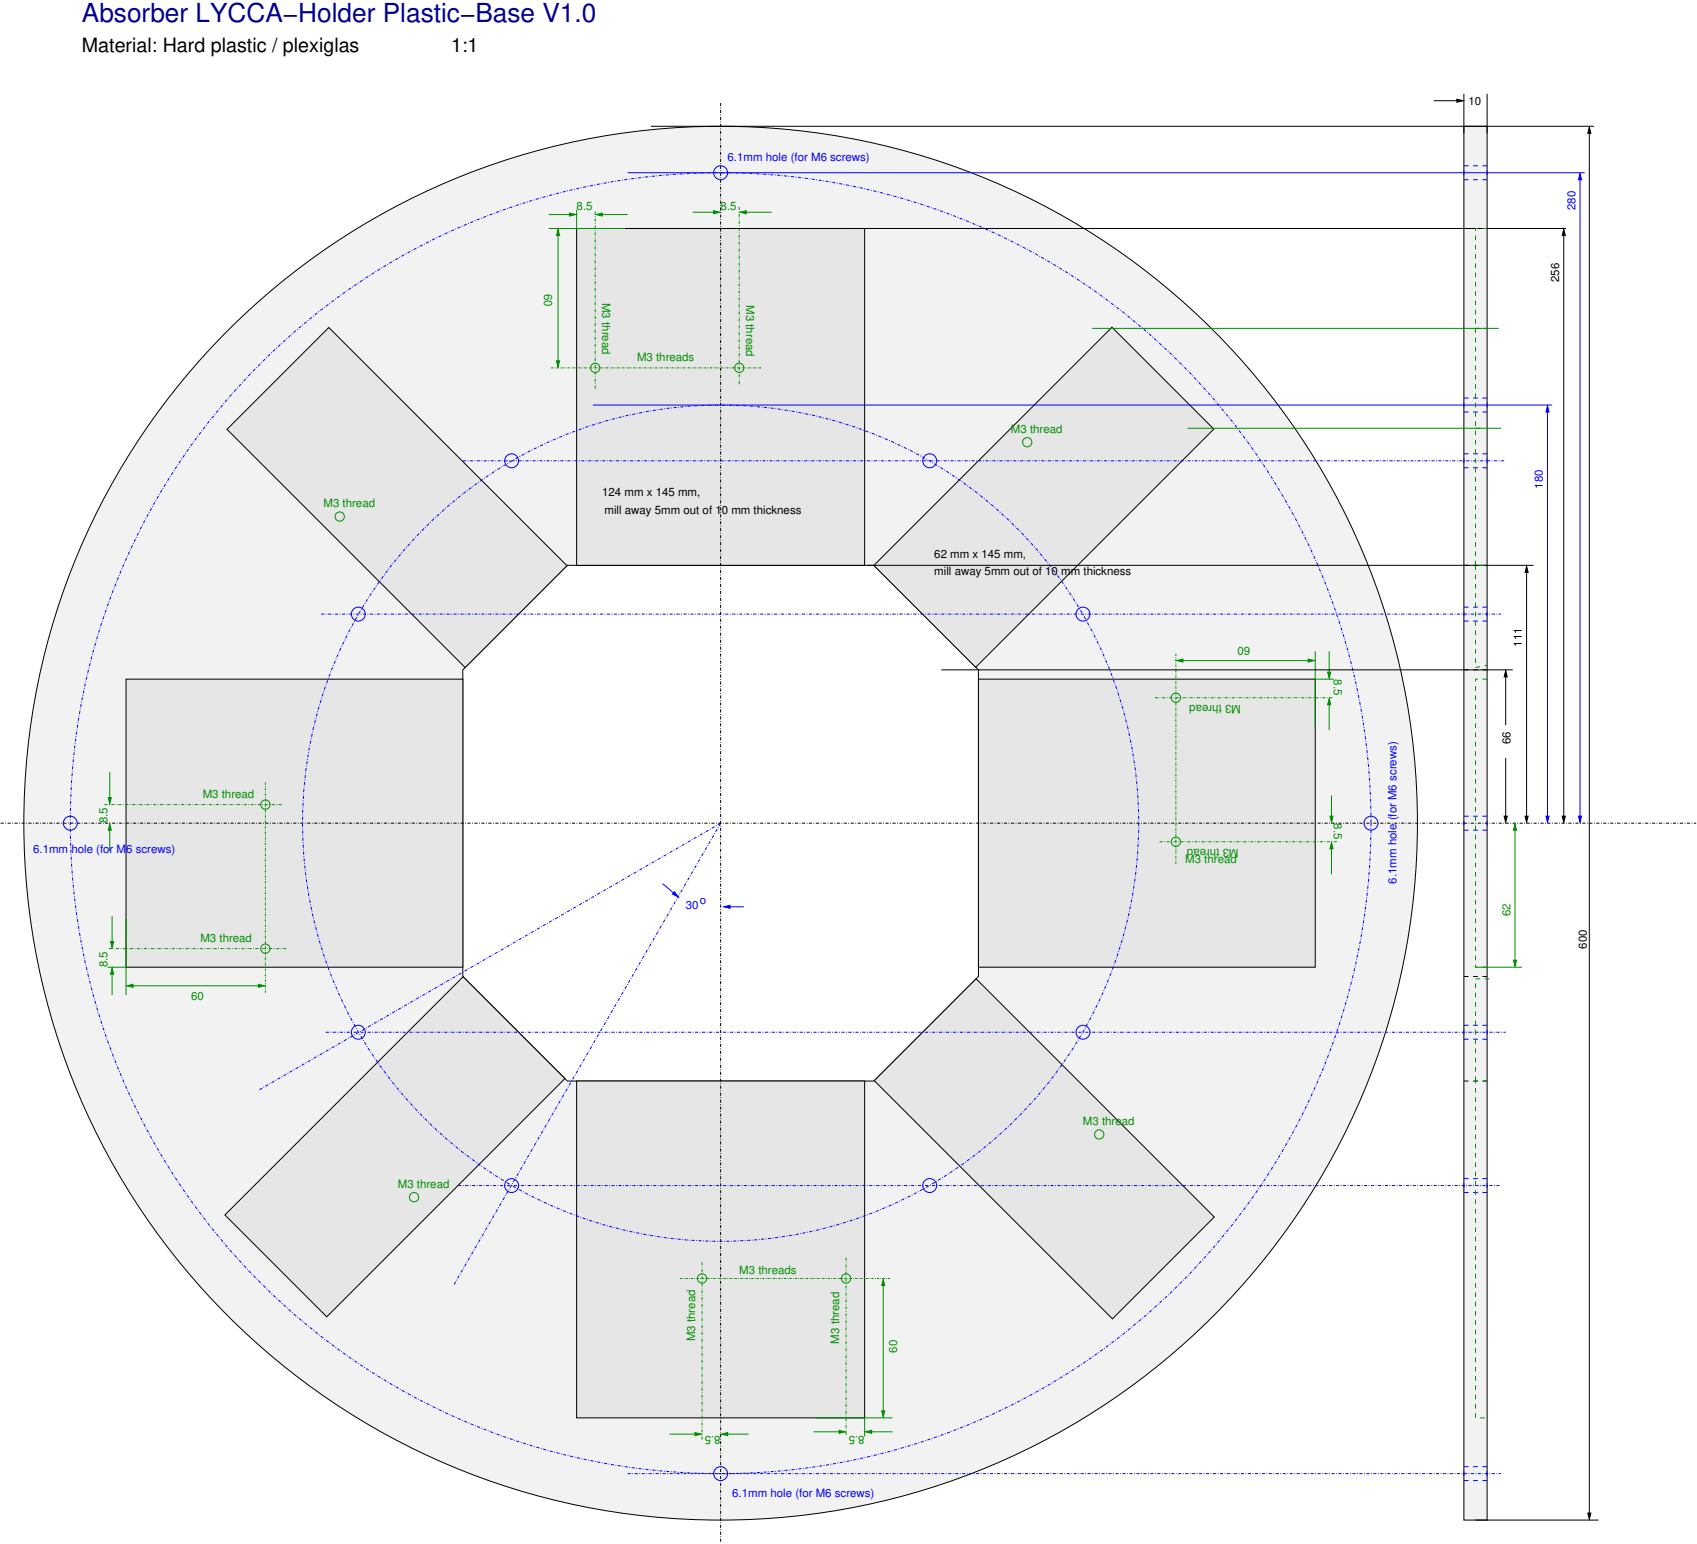
[picture p135: page 1]
M3 thread; M3 threads

6.1mm hole (for M6 screws)

mill away 5mm out of 10 mm thickness
