ASamarkRoth/ScanningSystem/figs_and_draws/Ritningar LYCCA-mount scanner/AbsPlastTop-V1.0.pdf

Material: Hard plastic / plexiglas | 1:1

# Absorber LYCCA−Holder Plastic−Top V1.0

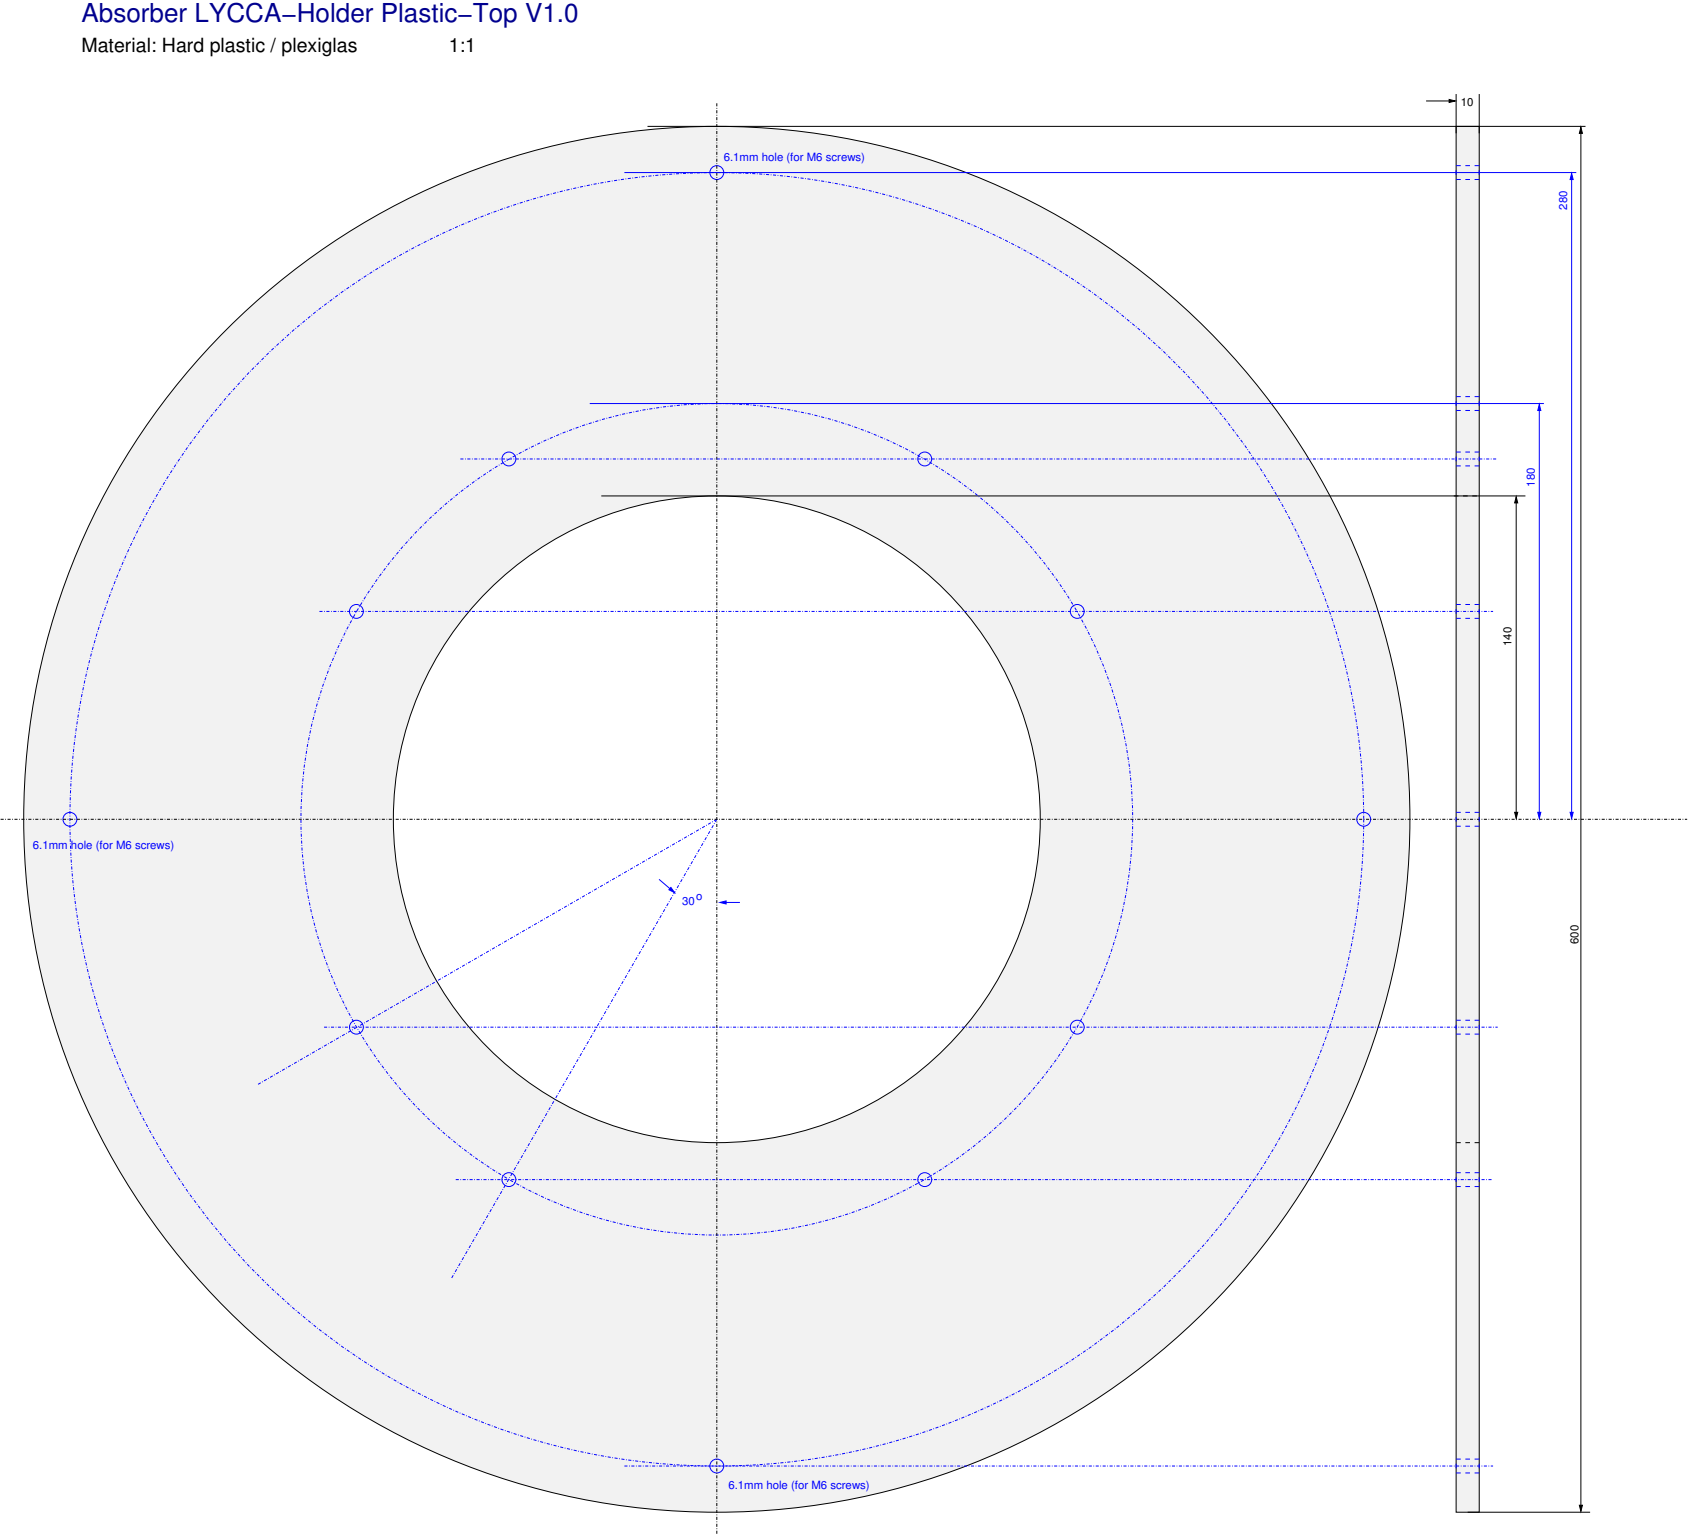
[picture p136: page 1]

6.1mm hole (for M6 screws)
