ASamarkRoth/ScanningSystem/TASISpec pieces/TASISpec piece1 2D.pdf

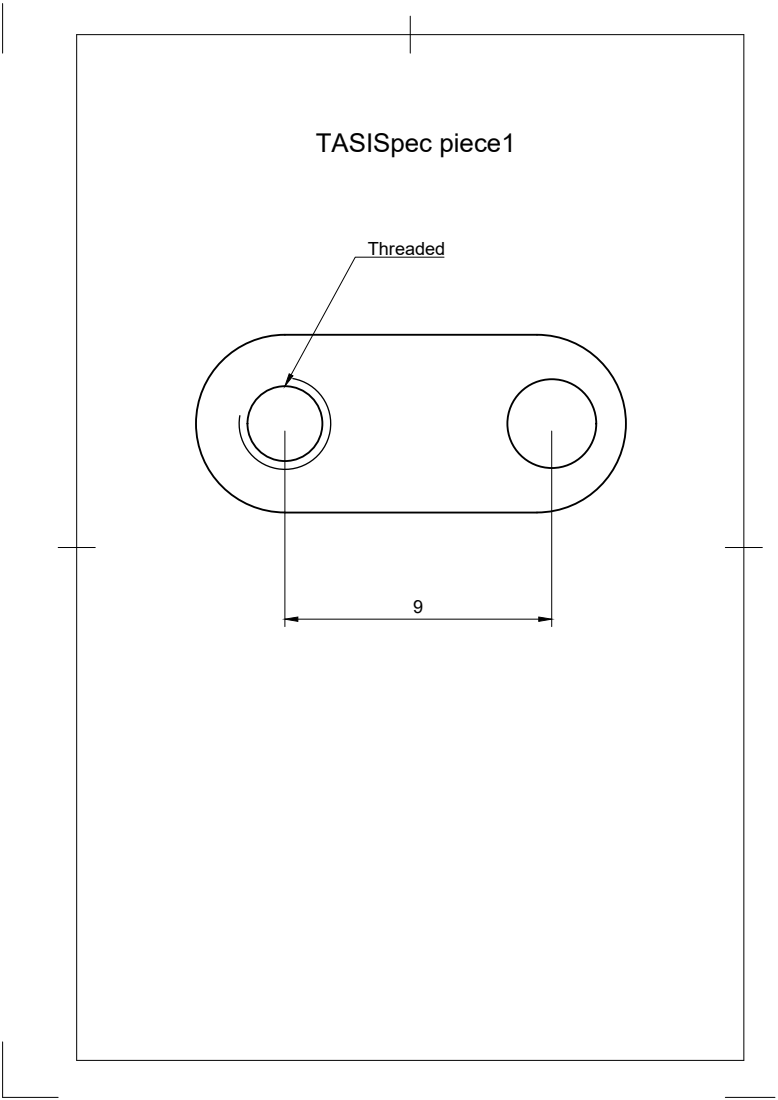
[picture p137: page 1]
TASISpec piece1
