ASamarkRoth/ScanningSystem/figs_and_draws/TableGigant1.pdf

A

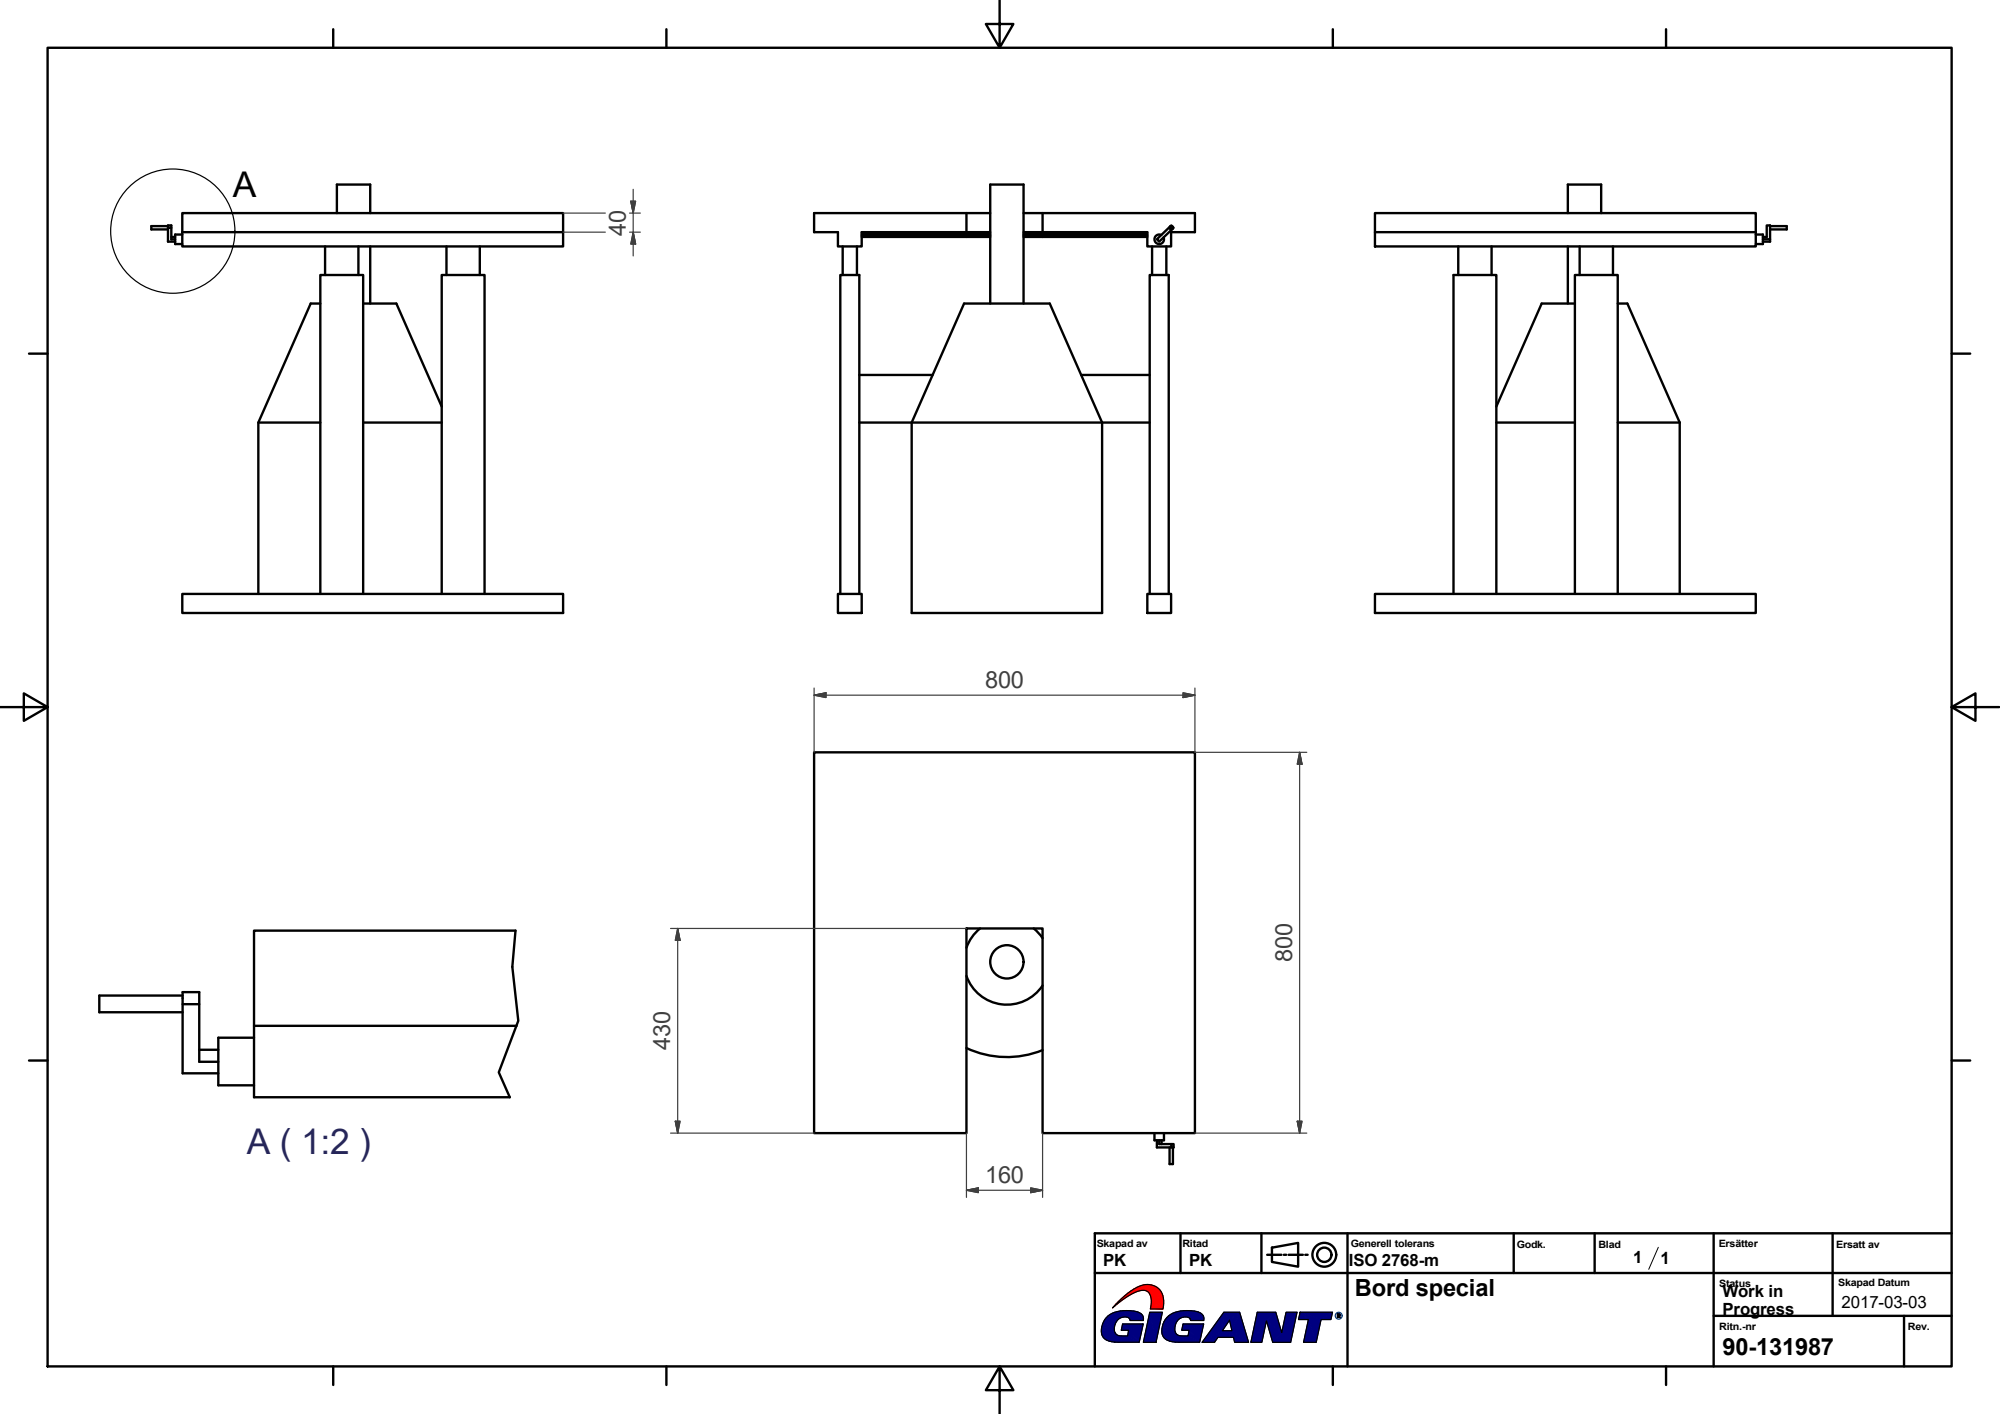
[picture p138: page 1]
Skapad av; Ritad; Generell tolerans; Ritn.-nr; Godk.; Blad; Status; Ersltter; Rev.; Ersatt av; Skapad Datum; ISO 2768-m; Work in Progress; Bord special
