ASamarkRoth/ScanningSystem/(commit log)

2017-01-23 Monday 23/1 work. Determine height adjustable tables. Ordering linear units and stepper motors.
2017-02-01 Gertbot and raspberry pi info from Emil.
2017-02-03 Added rotary stepper motor catalogue.
2017-02-06 added step files and diary updated
    [Collimator.step, Horizontal absorber.step, Lock.step, Source holder.step]
2017-02-09 new file results, diary uploaded
    [Results.xls]
2017-02-10 Added step files for svemek, diary up, results file up
    [Distance cylinder v1.step, Holder plastic base v3.step, Lycca aluminum base v1.step, Lycca holder top v1.step, Preamp support v1.step]
2017-02-10 Results updated
    [Results.xls]
2017-02-13 New SveMek file
    [Holder plastic base v2.step, Holder plastic base v3.step]
2017-02-13 Changed the report file
    [Results.xls]
2017-02-14 updated report and changed the calibration in the results using both centers (60Co and 57Co) and not only the 60Co center measurement
2017-02-16 Added the peak-to-Compton ratio in the Results file
    [Results.xls]
2017-02-24 Step file for positionning system, added links for lift tables
    [Position table.step]
2017-03-01 table.stp added
    [Table v1.step]
2017-03-06 Added step file with complete setup
    [Setup.step]
2017-03-08 Table step file
    [20-131992.stp]
2017-03-09 Plan updated
    [Results.xls]
2017-03-10 Results with americium
    [Results.xls]
2017-03-17 Added file for legs
    [Legs v4.step, Results.xls]
2017-03-22 A lot or rearrangements. Added files on screwsandrods, motor control.
    [Position table.step, Results.xls, Setup.step, Table v1.step]
2017-03-23 Added a step file for the arm
    [Collimator arm.step]
2017-03-27 Added step files for top plate and collimator arm
    [Collimator arm.step, Top plate.step]
2017-03-29 Added cable description for motor control.
2017-05-09 Added new screws asnd gertbot driver.
2017-05-22 Added endstops info.
2017-06-05 TASISpec file added
    [TASISpec piece1.step, TASISpec piece2.step, TASISpec piece3.step]
2017-06-15 Added some changes to setting it up. New collimator arm installation and details of LundiumPC.
2017-06-19 Removed some files.
    [Results.xls]
2017-06-20 The move_collimator program is now functioning very properly. Only minor changes needed before ready and of course implementing the power supply communication.
2017-06-22 The power supply communication now works. However, the write to the log file has not been handled just yet.
2017-06-26 Added stepper log and now try to make back-up if program is closing.
2017-06-30 Sensor step files have been designed and produced.
    [SensorCutBladeLG v0.step, SensorCutBladeLU v0.step, SensorHolder&Slit v0.step]
2017-07-03 Enlargened the length of the slit holder and made a step file for it.
    [SensorHolder&Slit v1.step]
2017-08-21 Iseg control install improved. 3D printer info added.
2017-09-10 Added info on orders and printer3D.
2017-11-17 Implemented YAML and Class for move_collimator. 3D printer info and laser triangulation sensor added.
